soypat/proy-final/README.md

# Capstone Project (Tesis de grado): Diseño, ensamblaje, integración y testeo de un vehículo VTVL eléctrico
## Autores: Patricio Whittingslow & Luis Cretton

Link to public domain site(ITBA) [spanish]:
https://ri.itba.edu.ar/handle/123456789/4253
