soypat/proy-final/chapter/designcad.tex

\section{Planos de diseño y planos de piezas}
En esta sección se detallan vistas explotadas de versiones anteriores 
y luego planos constructivos de las piezas que componen al prototipo.

% VIEJAS
\includepdf[angle=90]{pdf/cad/Vista explotada}
\includepdf[angle=90]{pdf/cad/Vista explotada 1.0}
\includepdf[angle=90]{pdf/cad/Vista explotada 5}

% VERSION FINAL
\includepdf[angle=90]{pdf/cad/ALUM-06-02}
\includepdf[angle=90]{pdf/cad/ALUM-06-03}
\includepdf[angle=0]{pdf/cad/ALUM-06-04}
\includepdf[angle=0]{pdf/cad/ALUM-06-05}
\includepdf[angle=0]{pdf/cad/ALUM-06-06}
\includepdf[angle=0]{pdf/cad/ALUM-06-07}
\includepdf[angle=0]{pdf/cad/ALUM-06-08}
\includepdf[angle=0]{pdf/cad/ALUM-06-09}
\includepdf[angle=0]{pdf/cad/ALUM-06-10}
\includepdf[angle=0]{pdf/cad/ALUM-06-11}
\includepdf[angle=0]{pdf/cad/ALUM-06-12}
\includepdf[angle=0]{pdf/cad/ALUM-06-13}
\includepdf[angle=0]{pdf/cad/ALUM-06-14}
\includepdf[angle=0]{pdf/cad/ALUM-06-15}
\includepdf[angle=0]{pdf/cad/ALUM-06-16}

% \section{Dibujos de }

% \includepdf[angle=90]{pdf/cad/Vista explotada 1.0}
