soypat/proy-final/pf-cretton-whitti.tex

% !TeX spellcheck = es
\documentclass[11pt, titlepage]{article}
\input{tex/preamble.tex}
\input{tex/macros.tex}
\input{tex/code.tex}
% \input{tex/footmult.tex}
\input{tex/glossary.tex}
\lhead{ LIA Aerospace -- ITBA}
\newcommand{\mldivide}{\,{\boldsymbol{\backslash}}\,}
\usepackage{pdfpages}
\author{Patricio Whittingslow \and Luis Cretton}
\begin{document}
\begin{titlepage}
	
	\centering
	\vspace{-1cm}
	\begin{figure}[htb]
		\centering
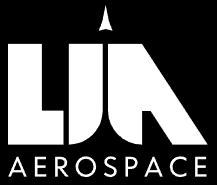
[picture p1: fig/lia-aerospace-logo.png]
		
	\end{figure}
	\begin{figure}[htb]
		\centering
		
	\end{figure}
	
	\vspace{1cm}
	{\Huge Diseño, ensamblaje, integración y testeo de un vehículo VTVL eléctrico \par}
	% {\Huge Gimballed EDF propelled VTVL vehicle design, assembly, integration and testing \par}
	\vspace{2cm}
	{ \large {
			Patricio Whittingslow \\ Luis Cretton 
		\par}}
	\vspace{.5cm}
	{ \large {
			Tutores:\\ Dan Etenberg \\ Alejandro Ghersin
		\par}}
	\vspace{1cm}
	\today
	\vspace{1cm}
	\begin{figure}[htb]
		\centering
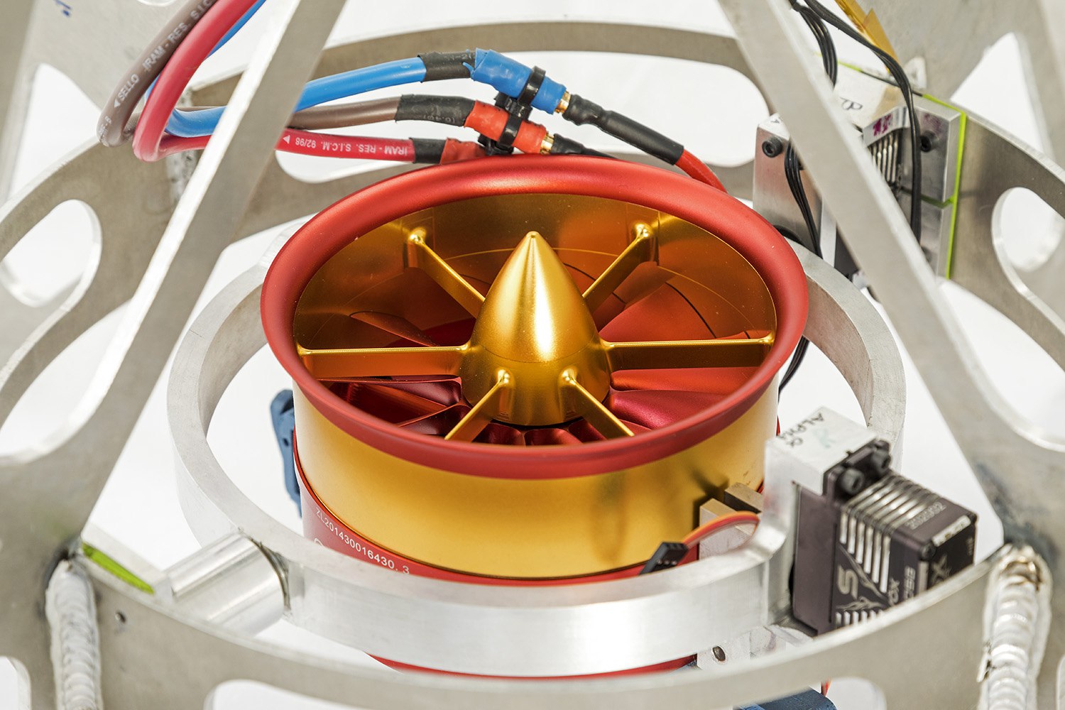
[picture p2: fig/hq/gimbal_close.jpg]
		
	\end{figure}
\end{titlepage}

\begin{abstract}
	
\indent En este documento se encuentran descriptas las secuencias del diseño, simulación, construcción, pruebas, y puesta en marcha de un UAV VTVL. Se evaluaron métodos de propulsión, diseño de fuselaje, software de vuelo, implementación de sistema de control para luego efectuar ensamblaje, y la integración final con testeo en campo. Se logro ensayar el sistema de control a baja escala con el propósito de incorporarlo a un sistema de mayor escala en desarollo paralelo de uso sub-orbital o incluso orbital. 

Se documentan todos los pasos seguidos para llegar al resultado final y se adjuntan los documentos relevantes del desarrollo para su posible replicación incluyendo los planos de cada parte del vehículo, fotos del ensamble, extractos de código, desarrollo de ecuaciones de dinámica de cuerpo rígido y modelos para el control del vehículo utilizando teoría de control óptimo lineal.

% - Proyecto es punta pie para otros desarrollos mas grandes, i.e: ESA FROG.
% - se propuso un projecto, y se logro
% 	- Como se logro?
% 	- Que nos propusimos?
% 	- No seguimos con las pruebas por el incidente. Nos detuvimos. Llevo a mas mejoras
% 	- Se reescribio todo el codigo, mejora de raiz. Se cambiaron componentes.
% 	- mas protecciones electricas
% 	- El fallo nos mostro el valor del proyecto. Si fuera un VTVL a combustible podria haber sido catastrofico
% 	- problema perdida de control podria generar perdidas en proyectos analogos(seguridad/desarrollos) de la empresa donde se usaba este tipo de tecnologia.
% 	- pruebas de campo

% - Flaps: Se diseño en 3D el soporte de sin tener el EDF en la mano. Cuando llego el EDF nos dimos cuenta que el soporte iba arriba de la parte giratoria.
% 	- Se tuvo que pausar y pensar en un diseño para el soporte que consolide el resto del diseño entero.

% - Queda mucho más para investigar y desarrollar.
% 	- En una proxima iteración podria extenderse el alcance de este desarollo.

\end{abstract}

\newpage
\tableofcontents
\newpage
\printunsrtglossaries
\vfill
\hrule
% \vspace{-1cm}
% \subsection*{Nota del autor}
% Si el documento es abierto desde un lector PDF moderno (Chrome, Adobe Acrobat Reader, entre otros), se podrá navegar el mismo mediante las referencias (haciendo click derecho).

\newpage

\input{chapter/intro.tex}

\null\newpage
\clearpage

\input{chapter/design.tex}

\null\newpage
\clearpage

\input{chapter/fea.tex}

\null\newpage
\clearpage

\input{chapter/designfig.tex}

\null\newpage
\clearpage

\input{chapter/model2d_es.tex}
\input{chapter/threeDdemo.tex}

\null\newpage
\clearpage

\input{chapter/simulation.tex}

\null\newpage
\clearpage

\input{chapter/software.tex}

\null\newpage
\clearpage

\input{chapter/tests.tex}

\null\newpage
\clearpage

\input{chapter/challenges-solutions.tex}

\null\newpage
\clearpage

\input{chapter/conclusion.tex}

% \null\newpage
% \clearpage

\subsection*{Agradecimientos}
Dan Etenberg por habernos ayudado en condiciones dificiles dado el contexto de pandemia y por proveer instalaciones, compra de materiales e insumos. 

\medskip

Stéphane Querry por haber intercambiado información acerca de parámetros de diseño del proyecto FROG de la ESA relevantes a la programación del sistema de control.

\medskip

Pablo Cossutta por compartir su experiencia trabajando con sistemas de potencia electrónicos. 

\input{chapter/annex.tex}

\bibliography{tex/biblio} % Indica archivo
\bibliographystyle{plainnat} %estilo de bibliografía
% \bibliographystyle{unsrtnat}
%\includepdf[fitpaper=false,landscape]{pdf/Vistaexplotada5.pdf}

\null\newpage
\clearpage

\input{chapter/designcad.tex}

\end{document}
