soypat/proy-final/tex/preamble.tex

\usepackage[spanish,mexico]{babel}
\usepackage{xcolor}
\definecolor{darkblue}{rgb}{0.1 , 0.1, 0.7}
% referencias antes de geometría!
\usepackage[
hyperfootnotes=true,
urlcolor=blue,
colorlinks=true,
linkcolor=darkblue,
citecolor=darkblue]{hyperref}

% Texto matemático
%\usepackage[utf8]{inputenc}
\usepackage[a4paper,top=2cm,bottom=2cm,left=3cm,right=3cm,marginparwidth=1.75cm,headheight=28pt]{geometry}
%\usepackage[spanish, mexico]{babel}
\usepackage{graphicx}

%\usepackage[utopia]{mathdesign}
\usepackage[T1]{fontenc}					
\usepackage[utf8]{inputenc}		
%\renewcommand*\familydefault{\sfdefault} 

\usepackage{amsmath,array,IEEEtrantools,bm}
\usepackage{pdfpages}
% ENCABEZADO
\usepackage{fancyhdr,framed}
\setlength{\headheight}{44pt}
\pagestyle{fancy}
% TODO
\usepackage[
textwidth=2.6cm,
textsize=footnotesize,
]{todonotes}

\usepackage{natbib}
\usepackage{afterpage}
