soypat/proy-final/presentation.pdf

## Gimballed EDF propelled VTVL vehicle design and control

### Defensa de proyecto final

Patricio Whittingslow
Luís Cretton

11 de febrero de 2023

### Objetivo

- Tecnología central para el desarrollo aeroespacial futuro
- Desarrollo de vehículo plataforma para ensayos a pequeña escala


Figura 1: Starship: referente en tecnología de vehículos orbitales reutilizables.

### Estado del arte

- Tecnología monorrotor fijo tiene uso amplio


Figura 2: Dos vehículos VTVL eléctricos modernos. “VBat” (Izq.) y “Ikarus”. (https://hackaday.com/2018/08/31/single-rotor-drone-a-thrust-vectoring-monocopter/)

### Estado del arte

- Tecnología monorrotor para empuje vectorial siendo usado por la ESA para ensayar algoritmos de control.


Figura 3: FROG de la ESA. Plataforma de ensayo de sistemas.

## Diseño

### Diseño – Propulsión másica

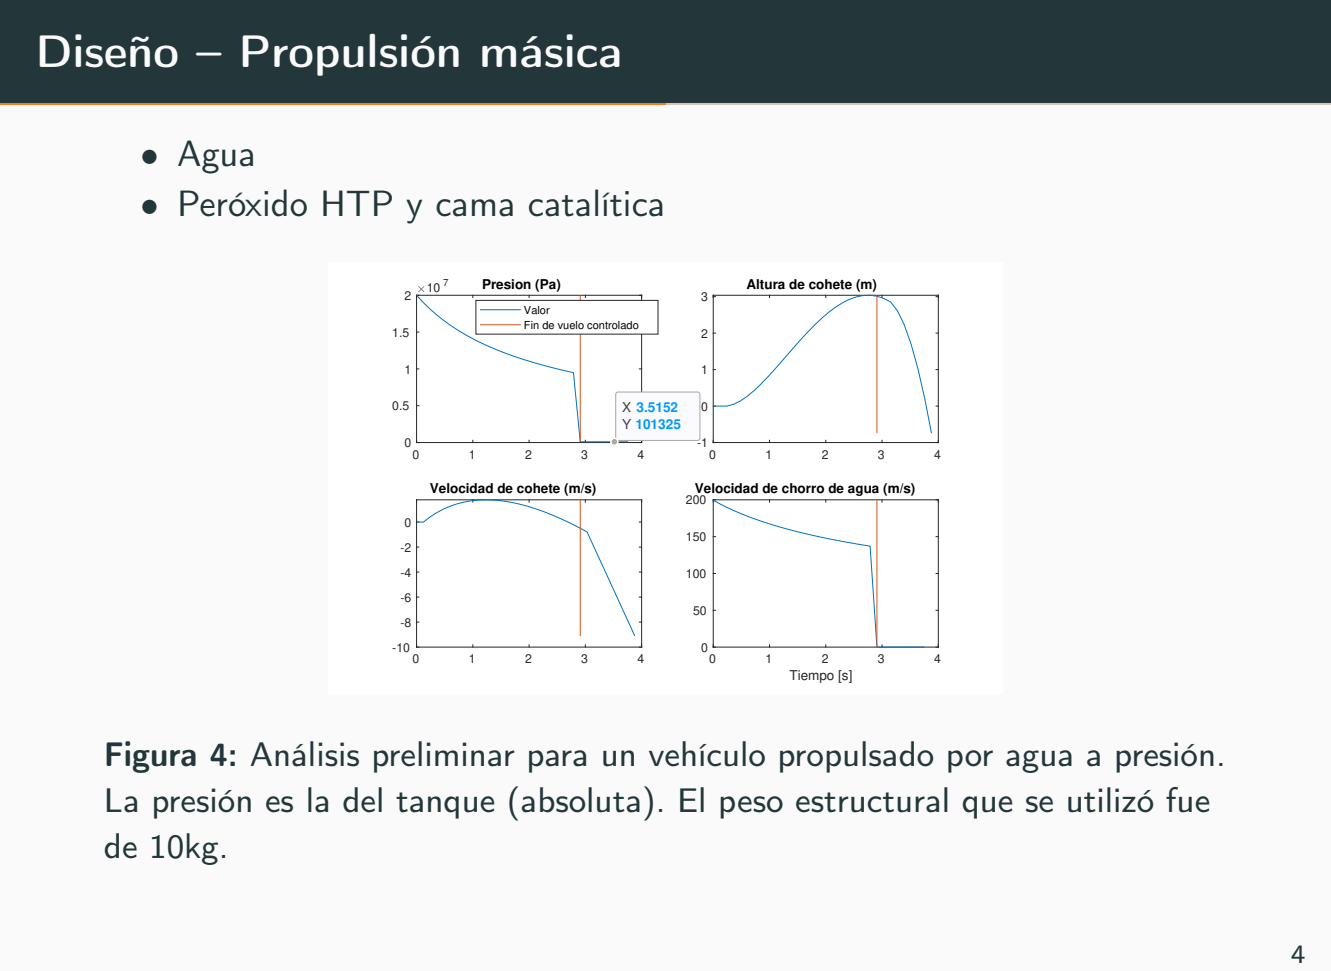
[picture p6: page 6]
Presion (Pa); Tiempo [s]

• Agua
• Peróxido HTP y cama catalítica

Valor
Fin de vuelo controlado

Altura de cohete (m)

Velocidad de cohete (m/s)

200Velocidad de chorro de agua (m/s)

Figura 4: Análisis preliminar para un vehículo propulsado por agua a presión.
La presión es la del tanque (absoluta). El peso estructural que se utilizó fue

### Diseño – Elección de propulsor

Diámetro de EDF | 70mm | 90mm | 120mm
Masa estructural [kg] | 0,4 | 1 | 2
Masa batería [kg] | 0,9 | 1,9 | 2
Mas electrónica [kg] | 0,5 | 1 | 1
Empuje restante [kgf] | 0,01 | 0,478 | 3,116
Tiempo vuelo [s] | 253 | 184 | 132
Precio baterías-propulsor [usd] | 165 | 365 | 693
Costo total [ars] | 23968 | 53017 | 101313

Tabla 1: Estudio de diferentes EDF’s disponibles en el mercado. El requerimiento excluyente para la selección de batería fue que permita vuelo sostenido por 2 minutos.

## Simulación

### Simulación – Modelo matemático

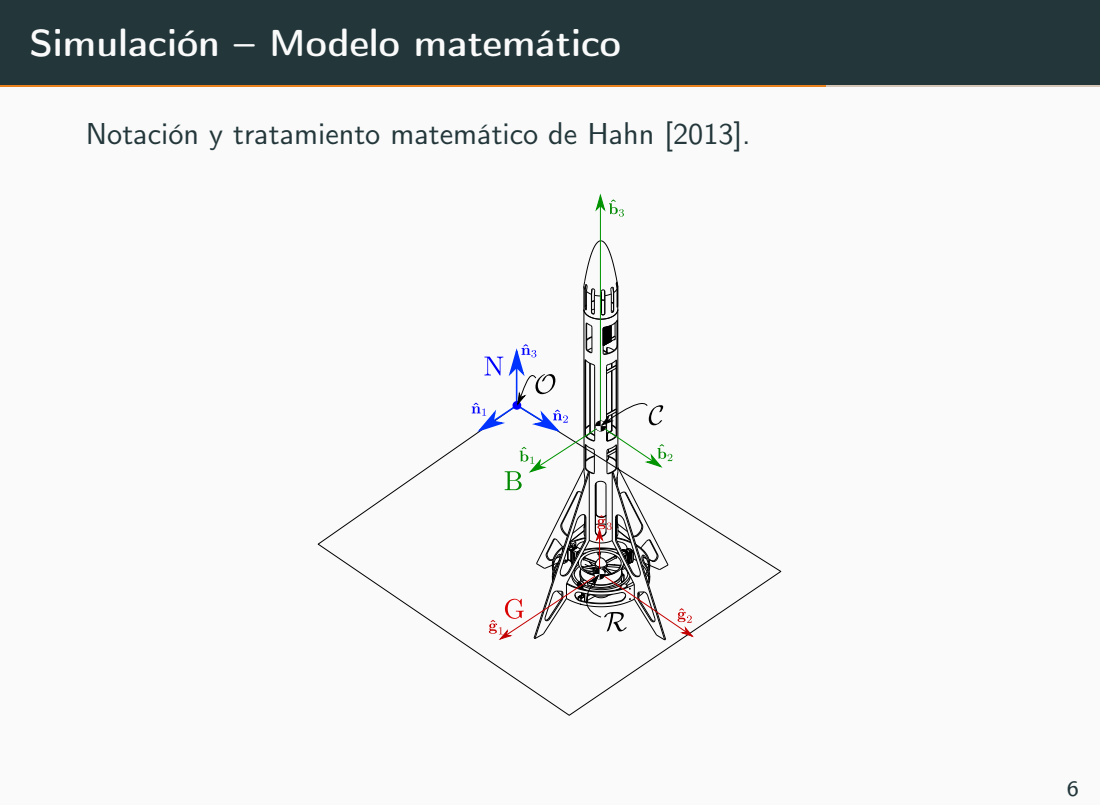
[picture p7: page 9]

Notación y tratamiento matemático de Hahn [2013].

### Simulación – Modelo matemático

Aceleración angular del vehículo tomando en cuenta efecto giroscopo y fuerzas externas debido a vorticidad.

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
BN ·J

B
C
- ω

B
BN − A

BG
- ω˜

G
GB ·J

G
rR
- ω

G
r −

ω˜

B
BN ·J

G
rR
- ω

G
r − A

BG
·J

G
rC

·

Nω˙

G

r +MB
C

### Simulación – Control

- Representación espacio de estados.
- Controlador LQR.
- Estimador de actitud Madgewick.
x˙ = Ax + Bu | (1)

u = KLQR (x − x0

) | (2)

## Referencias

Hubert Hahn. Rigid Body Dynamics of Mechanisms: 1 Theoretical Basis. Springer Science & Business Media, 2013.
