soypat/proy-final/pf-cretton-whitti.pdf

LIA Aerospace

# Gimballed EDF propelled VTVL vehicle design and control

Patricio Whittingslow
Luis Cretton

8 de abril de 2021

Resumen

En este documento se encuentran descriptas las secuencias del diseño, simulación, pruebas, y puesta en marcha de un vehículo autónomo VTVL (Vertical Take-off Vertical Landing). Se desarrolla la elección de un método de propulsión que lograra ensayar el sistema de control a baja escala para luego ser puesto en marcha en un sistema de mayor escala de uso sub-orbital o incluso orbital.

LIA | ÍNDICE

## Índice

Glosario | 2
Siglas | 2
1. Introducción | 3
2. Estudios | 3
3. Diseño | 6
4. Modelo 2D simplificado | 10
5. Ecuaciones de movimiento de cuerpo rígido | 12
6. Simulación | 19
7. Desarrollo de software | 22

LIA | Siglas

## Glosario

Corrutina Una unidad de procesamiento que puede ejecutarse en simultaneo con otras corrutinas.

Electronic Speed Control Controlador de velocidad para motores brushless. Suelen tener DC a la entrada y trifásica a la salida.

Electronic ducted fan Turbina impulsada por un motor eléctrico brushless. Es eficiente a altas velocidades.

Linear Quadratic Regulator Regulador basado en control óptimo que busca reducir error cuadratico de una función costo.

System on a chip Integración de modulos conectados a un controlador en un único circuito impreso.

LIA Laboratorio de Investigaciónes Aeroespaciales. Empresa para la cual se efectuó el desarrollo del vehículo.

## Siglas

I

2C Protocolo de comunicación de dos hilos que permite comunicar varios circuitos integrados en un bus.

GPIO Salida digital de uso genérico. Pueden estar en high (tensión de fuente) o low (puesto a tierra).

SPI Serial peripheral interface. Un protocolo de comunicación full-duplex de Motorola.

UART Protocolo de comunicación universal asincrono.

Nota del autor

Si el documento es abierto desde un lector PDF moderno (Chrome, Adobe Acrobat Reader, entre otros), se podrá navegar el mismo mediante las referencias (haciendo click derecho).

LIA | 2 ESTUDIOS

## 1. Introducción

El diseño, desarrollo, fabricación, armado, simulación y lanzamiento de cohetes, no es una tarea sencilla ni repetida en intervalos de cortos de tiempo, al contrario, suelen llevar décadas y una fuerte inversión para que sean posibles estos logros. El diseño y auge de vehículos VTVL viene a subsanar estos factores ya que una vez terminada la misión el vehículo se puede reutilizar, con mínimas intervenciones, y estaría listo para una nueva misión, atacando estos dos puntos principales anteriormente mencionados, el tiempo y el costo. Esto es a diferencia del método convencional donde el vehículo, luego de completar la misión, pasa a formar parte de basura espacial o, en el mejor de los casos, es recuperado del mar como el caso del Space Shuttle.

Un vehículo VTVL es aquel que despega verticalmente (como la mayoría de los cohetes convencionales) y aterriza verticalmente, por sí solo, sin necesidad de ser tripulado, y con el objeto de completar una misión, esto supone una gran variante de ventajas, como ser una de las más destacadas el reutilizamiento del vehículo, con todo lo que ello implica, logrando una optimización de los costos, disminución de huella ecológica, y tiempo de desarrollo para las empresas interesadas.

Los vehículos VTVL son tan viejos como el primer alunizaje. Traen en si varias ventajas frente a otros vehículos voladores como la gran reducción de espacio necesario para despegar y aterrizar. Esto no es un detalle menor dado que la mayor parte de la superficie terrestre de la tierra no son pistas de aterrizaje si no más bien terreno formado naturalmente.

Este documento propone el diseño, simulación, control y fabricación de un vehículo con capacidades VTVL siendo un prototipo de baja escala. Este prototipo serviría como punta pie inicial para vehículos de escala mayor que puedan completar misiones espaciales. Existen varias ventajas de implementar este tipo de tecnología.

A baja escala, un vehículo que despega y aterriza por su cuenta, teniendo la capacidad de superar obstáculos que se presenten, puede ser de gran utilidad en ambientes hostiles para el ser humano, que esto se logre de manera rápida y efectiva podría ser la diferencia entre el éxito o no de la misión. Como ser el transporte de insumos médicos en tiempo real desde que un paciente lo requiere, en zonas de acceso limitado.

Últimamente hay un interés nuevo en imágenes espaciales. El vehículo podría ser utilizado para fines de sistemas de monitoreo y análisis geoespacial mediante el uso de estas imágenes, como hacen las empresas Ceres Imaging y Satellogic.

El vehículo una vez desarrollado y funcionando, puede servir de plataforma para diversos estudios de fenómenos de dinámica de fluidos, como ser, mediciones aerodinámicas, investigación del fuel sloshing en vehículos con tanques esbeltos.

Los sistemas de vehículos orbitales tienen sistemas complejos que deben ser testeados en una primera etapa mediante algún ensayo controlado. El vehículo que se desarrolla en el presente documento podría ser usado para tales fines como una plataforma para pruebas como ser el despliegue de una nariz o etapa, comprobación de sensores y actuadores a gran velocidad y con empuje variable.

## 2. Estudios

En lo que se refiere a la construcción del vehículo, el diseño propuesto paso por varias etapas y decisiones de ingeniería hasta su forma final. Desde su diseño en lápiz y papel hasta la simulación del CAD con el detalle del ultimo bulón del ensamble para poder recoger datos de momentos de inercia, centros de masa y la dinámica del vehículo.

LIA | 2 ESTUDIOS

### 2.1. Agua como propelente

El primer prototipo muy distante del diseño final perteneciente a este trabajo, consistía en un recipiente a presión con agua, abulonado a un chasis, con un gimbal y actuadores para poder redirigir el empuje.

La figura 1 muestra los resultados de una simulación de un vehículo pequeño de aluminio con un recipiente a presión lleno en parte de agua y aire a 200 bar. La simulación considera masa variable y una transición isoentrópica del gas en el recipiente. En el mejor de los casos se llegaba a un tiempo de vuelo cercano a los 4 segundos que no es suficiente para comprobar un sistema de control.
Para optimizar este problema se modificaba

Diámetro de la tobera – más empuje vs. menos tiempo de vuelo controlado

Volumen de agua – más tiempo de vuelo vs. mayor peso de vehículo

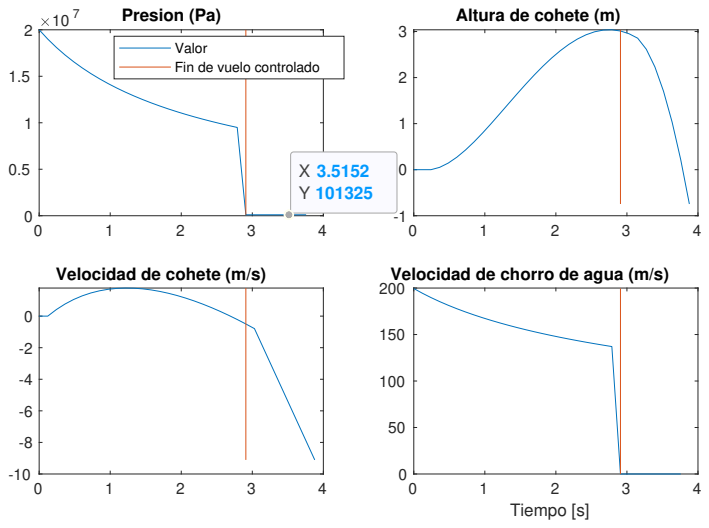
[picture p8: figure]
Presion (Pa); Altura de cohete (m); Velocidad de cohete (m/s); Tiempo [s]; Velocidad de chorro de agua (m/s); Valor Fin de vuelo controlado

Figura 1: Análisis preliminar para un vehículo propulsado por agua a presión. La presión es la del tanque (absoluta). El peso estructural que se utilizó fue de 10kg.

### 2.2. Turbina a reacción

Se propuso la construcción de una turbina de combustible líquido, como método de propulsión del vehículo favorable debido al excelente cociente de peso-empuje.
Esta idea se vio descartada por la pandemia que estamos atravesando (COVID19) debido a que no teníamos acceso al taller de la institución para poder realizar en tiempo y forma el dispositivo mecánico, que era la primer tarea inmediata a tener en banco de pruebas asegurando su funcionamiento en optimas condiciones, para luego proseguir con el desarrollo del vehículo y el sistema de control.

### 2.3. Propulsión eléctrica

Luego de descartar las ideas vistas en 2.1 y 2.2 se pasó al análisis de la incorporación de una turbina eléctrica que es un dispositivo ya existente en el mercado, no en nuestro país, pero que podría llegar a importarse mediante una inversión privada.¹ Dado el alcance de un

1Agradecemos a LIA Aerospace por hacerse cargo de la compra de todos los elementos necesarios para la fabricación del cohete.

LIA | 2 ESTUDIOS


Figura 2: Dos vehículos VTVL eléctricos modernos. “VBat” (Izq.) y “Ikarus” (https://hackaday.com/2018/08/31/single-rotor-drone-a-thrust-vectoring-monocopter/) (Der.).

proyecto de universidad se decidió por un diseño compuesto por elementos comercialmente disponibles.²

Para lograr estas tareas generalmente los vehículos VTVL de baja escala generalmente son propulsados por motores eléctricos.

Los vehículos VTVL eléctricos son propulsados por hélices en su mayoría y constan casi siempre de 3 o más propulsores en un arreglo simétrico y plano. Recientemente hay un interés por la construcción de vehículos de una sola hélice por la buena relación empuje– peso que tienen. Sin embargo, estos vehículos no vienen sin sus complicaciones:

La rotación dada al aire por la hélice causa un momento en el eje de propulsión que es contrarrestado en vehículos multirrotores.

Inclinar al rotor durante su funcionamiento causa una fuerza perpendicular a la dirección de inclinación conocido como el efecto giroscópico.

El primer punto es mitigado fácilmente agregando álabes a la salida del chorro para enderezar el flujo y contrarrestar la rotación. El segundo punto solo se resuelve conociendo las ecuaciones de momento angular y controlando actuadores con un sistema de control a lazo cerrado. Los sistemas vistos en la figura 2 tienen la particularidad de poder ser representados con relativa facilidad usando un solo marco de referencia inercial para el cálculo de las ecuaciones de momento angular.

Existen placas pre-programadas para vehículos multirrotores, pero en el caso de vehículos monorrotores de hélice fija se precisa re-programar la placa para compensar por el efecto giroscópico y agregar dinámica de álabes ya que no existe software disponible aún para esta configuración. En el caso de tener una hélice móvil se suma un nivel de complejidad agregada debido al despeje de las ecuaciones de momento angular (ver sección 5). Al momento de escribir este documento aún no hay desarrollo disponible de carácter público para esta configuración.

2Commercial off the shelf (COTS)

LIA | 3 DISEÑO

## 3. Diseño

En el marco de este proyecto, es de interés el diseño mecánico del mecanismo de control semejante un vehículo propulsado por combustión externa. Estos últimos suelen ser dirigidos por toberas montadas sobre un cardán. En el caso de un vehículo eléctrico de una hélice se tendría que montar el sistema de propulsión centrado en un gimbal para no obstruir el flujo.

### 3.1. Selección de propulsor

Los requerimientos para el propulsor son los siguientes

Empuje que mantenga altura del vehículo para la máxima actuación del gimbal

Disponible comercialmente

Precio de propulsor y accesorios relevantes dentro de presupuesto

Durabilidad ante pruebas físicas en cuanto a la duración del proyecto

Estos requerimientos fueron los primeros especificados para el diseño del vehículo. El diseño estructural y la selección de componentes electrónicos parten del propulsor seleccionado ya que este es la pieza central para lograr los objetivos propuestos y la que más puede variar en especificaciones técnicas.

Existen diversas maneras de impulsar un vehículo de forma eléctrica. Luego de un cuidadoso estudio y discusión de ingeniería se decidió optar por un EDF, quien juega un rol central en el diseño pues es lo que se intenta controlar para llevar a cabo la navegación y guiado.

Se generó una lista de EDF’s de diferentes diámetros disponibles comercialmente.

| 70mm | 90mm | 120mm
Masa estructural [kg] | 0,4 | 1 | 2
Masa batería [kg] | 0,9 | 1,9 | 2
Mas electrónica [kg] | 0,5 | 1 | 1
Empuje restante [kgf] | 0,01 | 0,478 | 3,116
Tiempo vuelo [s] | 252,972973 | 183,5294118 | 131,8309859
Precio baterías-propulsor [usd] | 165,075 | 365,15 | 693,005
Costo total [ars] | 23968,06463 | 53017,95425 | 101313,866

Tabla 1: Estudio de diferentes EDF’s disponibles en el mercado. El requerimiento excluyente para la selección de batería fue que permita vuelo sostenido por 2 minutos.

El empuje restante de la tabla 1 es el empuje que sobra luego de restar el peso del vehículo al empuje nominal del EDF. Este empuje dará margen para maniobrar y recuperar la orientación luego de una perturbación externa.

Los EDF de aluminio solo se consiguen en el exterior y su precio es en dolares³
| | | . Esto trae
varios inconvenientes en lo referente al presupuesto acotado, logística, compra y obtención.
Los EDF disponibles de plástico tienen una relación de empuje-diámetro mucho menor con
respecto a los de aluminio. Cabe destacar que el costo de un EDF de plástico y un EDF
de aluminio son cercanos para diámetros similares. | juntar estos dos
parrafos (arriba
Los EDF que fueron analizados son los más baratos que se encontraron en eBay y son y abajo) en uno provenientes de Hong Kong. Como condición de selección excluyente para cumplir con el
requerimiento de durabilidad el hecho de que sean de aluminio ya que deberán resistir

LIA | 3 DISEÑO

test y pruebas físicas (durabilidad) además de la fabricación y vinculación mecánica de
actuadores de aluminio (tensiones). Son todos de aluminio y se espera . | corregir esto

Se decidió por el EDF de 120mm, motor brushless alimentado por una batería Li-Po
12s (48V) 5000mAh 50c/100c para la construcción del prototipo. Este EDF mantiene un
empuje resultante positivo para un ángulo de actuación de aproximadamente 45◦
, el cual
supera el ángulo actuado máximo de las simulaciones.

### 3.2. Diseño de la mecánica

Para el diseño del gimbal se propuso una distribución de los mecanismos de actuación con servos concéntricos a los ejes de rotación. Para evitar de esta manera complejidad de mecanismos, cantidad de piezas de conexión entre servo y ejes, manufactura de mecanismos, uniones rotoides, y obtener así un mapeo lineal del ángulo de actuación. El único intermediario es el rodamiento que como se dispuso en la configuración ocupa el mínimo lugar posible justo por encima de la estría del servo y se lleva las cargas. Este mecanismo viene con la desventaja de una reducción de la resolución del ángulo de actuación comparado a un sistema actuado por un mecanismo biela-manivela.

El material seleccionado para la fabricación del gimbal fue aluminio serie siete mil calidad aeroespacial. Esta construido de una sola pieza, siendo el elemento que se lleva las tensiones en todo momento en variabilidad de ángulos hacia el fuselaje, por ello la decisión de ser de la serie de mayor resistencia mecánica de los aluminios comerciales.

Los rodamientos seleccionados son de dimensiones 18mm exterior, 10mm interior y 7mm de espesor, elegidos de esta manera por una cuestión de espacio para poder pasar la estría de los servomotores por dentro, dejando un espesor de la pared del estriado de 2.5mm, para evitar fisuras y hacer posible la manufactura de la pieza. La forma de generar el estriado interno, es la de indentar con un patrón sobre un agujero previo de diámetro medio a los valores máximos y mínimos de las crestas y valles de la estría. Esta operación debe hacerse con el material en bruto para no arruinar las tolerancias que necesitan los rodamientos. Los rodamientos se montarían clavados, minimizando el peso al no agregar anillos seguers ni tapas con bulones.

Los ejes del gimbal estarían en disposición simplemente apoyada y de forma axisimétrica para prevenir perturbaciones dinámicas por desbalanceo.

Con respecto al fuselaje, al inicio se pensó una envolvente cilíndrica para el anillo externo del gimbal. Luego se diseñó un desarrollo reticulado optimizado, se pasó por diferentes modelos e ideas, hasta que se combinaron varios puntos fuertes de cada idea. La envolvente del gimbal se fabrica de forma rolada y optimizada en peso a raíz de una planchuela de aluminio vaciada y luego generando su forma cilíndrica.⁴ Esto distribuye las masas de manera más favorable con menos espacio ocupado (dinámica-peso). Aguas arriba del gimbal se opto por un chasis tubular, con diversos vaciados, que mediante flejes puede soportar cada elemento que se acopla al cohete por medio de uniones abulonadas. Permitiendo mediante sus aberturas el acceso a cada componente del vehículo, proporcionando, además, una renovación del aire para una evacuación del calor generado, y un flujo abundante hacia la admisión del EDF.

De la manera que se construye el gimbal puede entregar una rotación entera sin hacer contacto con la estructura. Se elige esta configuración por posibles desviaciones del proyecto en el futuro, calculamos que utilizaremos menos de 20◦ de rotación de cada eje de gimbal (±10◦
).

3El cambio de divisas es desfavorable para el lugar donde se desarrolla este proyecto.
4Contiene al anillo del gimbal.

LIA | 3 DISEÑO

### 3.3. Posición de baterías

La la decisión de donde posicionar las baterías surgía de querer simular un vehículo semejante a los VTVL con motores a reacción y también la posibilidad de tener una inercia favorable para los margenes de estabilidad. Estos dos últimos puntos sugieren que la posición ideal para las baterías es arriba de todo. Esto haría que el punto alrededor del cual se linealizó las ecuaciones de movimiento sea más estable. Luego de una conversación con Pablo Cossutta, un ingeniero electrónico especialista en sistemas de potencia, se optó por la configuración encontrada en el documento. Las baterías se encuentran cerca del EDF para alejar las líneas de potencia trifásica correspondientes al motor brushlesss de lo que es la electrónica digital. Al inestabilizar el punto de operación se obtiene una mejora en la respuesta ante actuaciones permitiendo una corrección de trayectoria más rápida.⁵

### 3.4. Selección de servos

Para obtener una buena respuesta del vehículo ante actuaciones se debe acotar la resolución necesaria. Según Castillo-Martínez et al. [2018], la resolución angular de un servo analógico está dada por

Rp =

θ · TD
PW
donde θ es el angulo de barrido del servo (especificado por el fabricante), TD es el tiempo muerto y PW es el ancho de pulso operativo.
El servo seleccionado es el SC1258TG. Tiene las siguientes especificaciones

Tiempo muerto (deadband) 3µs

Rango de ancho de pulso mínimo y máximo 800-2100µs

Posición neutra 1500µs

Ángulo de barrido operativo 100◦
(para 1000-2000µs)

Velocidad 1,05 rad/s

Controlador digital

Se tiene entonces una resolución mínima de 0,3◦
con un ancho de pulso de 2000µs. Esta cuenta cede la resolución para un servo analógico, en el caso de tener un servo digital se toma el límite superior entre este valor y la resolución del controlador digital. Como el fabricante no especifica el controlador utilizado, se supone el peor de los casos: un controlador de 8 bits. Este caso tiene una resolución de 0,4◦
Esta resolución es alimentada como parámetro de actuación en las simulaciones.

### 3.5. Tren de aterrizaje

Se definen algunos requerimientos para el tren de aterrizaje

Cada pata será dimensionada para soportar 20 veces el peso del vehículo. Este factor
de seguridad toma en cuenta la posibilidad de aterrizaje desparejo y el factor dinámico
de un impacto | 20 veces? Cuan- tas veces?

Facilidad de fabricación y armado

5Este resultado es deseado cuando se desea tener mejor rendimiento por ángulo de actuación, como sucede con los aviones caza que utilizan este fenómeno a conveniencia.

LIA | 3 DISEÑO

El primer diseño consistía en una estructura reticulada, la cual se decidió abandonar por la dificultad del armado y sucesivas soldaduras, consecuentes alineaciones por las dilataciones térmicas.

El diseño seleccionado consiste en unas patas compuestas de una placa de aluminio vaciada y soldada a la estructura principal del fuselaje. Otorga rigidez a expensas de bajo peso y facilidad de construcción.

### 3.6. Selección de controlador y sensores

Se pasó por dos etapas hasta llegar a la decisión final del controlador. Se empezó planteando la utilización de una Raspberry Pi 4B+ para controlar los actuadores con PWM. Esta configuración requeriría el diseño de una placa ad-hoc para desacoplar galvánicamente la Raspberry del controlador de velocidad del EDF (ESC). Se descartó esta idea a favor de usar una combinación de Raspberry Pi y una placa propia de LIA Aerospace.

El controlador a usar es el ARM Cortex-A72 que sería comprado en el paquete comercial (SoC) conocido como Raspberry Pi 4B+. El producto provee salidas para los siguientes usos

UART

SPI

I

2C

GPIO

El controlador ira montado sobre una placa cuyo desarrollo pertenece a LIA Aerospace denominada LIA-Board. Esta placa hace interfaz con el controlador mediante el GPIO header del SoC. Esto le permite al controlador acceder a los periféricos y salidas disponibles del LIA-Board que controlaran los actuadores y leerán los sensores.

### 3.7. Contexto de pandemia

Las medidas tomadas durante la pandemia por el gobierno fueron muy estrictas e influenció a todo tipo de acción que se quiso tomar. Durante el primer año de pandemia no nos pudimos reunir físicamente para discutir ideas de diseño, lo cual dificultó el avance físico del proyecto como así también la toma de decisiones y la comunicación entre partes, crucial en el inicio de todos proyectos de ingeniería.

Una de las mayores complicaciones que se tuvo fue la compra de componentes, además de la fabricación, que se vio afectada, por las políticas cambiantes de nuestro país con respecto a la compra y la entrada de productos importados a suelo argentino. Incluso la compra y llegada de los productos fue un motivo de festejo luego de un tortuoso trayecto.

LIA | 4 MODELO 2D SIMPLIFICADO

## 4. Modelo 2D simplificado

Esta siguiente sección detallará el tratamiento matemático efectuado para controlar un vehículo con propulsión vectorizada en el plano. El propósito es ilustrar a un nivel simple las herramientas que serán aplicadas para controlar el vehículo diseñado.

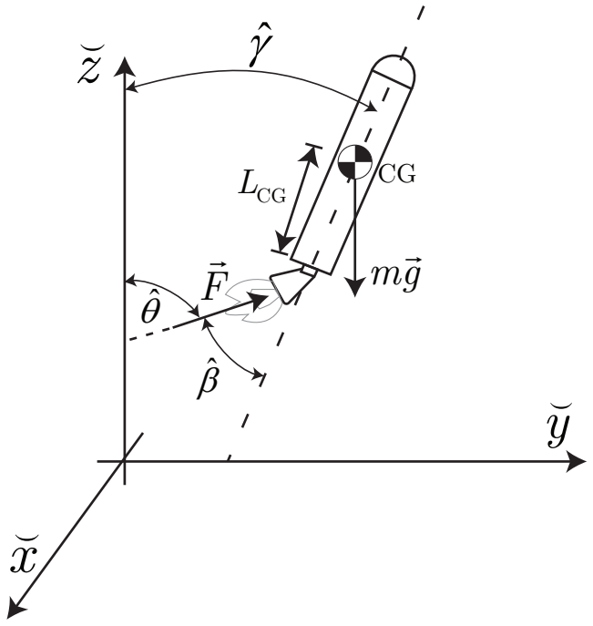
[picture p9: figure]
LCG

Figura 3: Diagrama de cuerpo libre de un vehículo con propulsión vectorizada 2D.

### 4.1. Modelado matemático

Comenzamos con las ecuaciones dinámicas de un vehículo en el plano con control de propulsión vectorizada (por ángulo)

y¨ =

F
m

sin(γ + β)
z¨ =

F
m

cos(γ + β) − g
γ¨ =

LCG·F
Ixx

sin β

donde LCG y F están en función del tiempo, m = m0 −

R
m˙ y θ = γ + β.
Vale la pena aclarar que no se tomarán en cuenta los siguientes efectos:

Coeficiente de arrastre

Viento

Fuel sloshing

Efectos relativistas

### 4.2. Armado de sistema lineal

Se propone un punto de operación alrededor del cual se efectúa la linealización las ecuaciones. El estado del vehículo es vertical y quieto en el espacio.

6

6La linealización es valida solo para un vehículo vertical. Se deberá modificar el método para modelar un vehículo orbital.

LIA | 4 MODELO 2D SIMPLIFICADO

γ

∗ = 0

β

∗ = 0

F

∗ = mg

en este caso F es la desviación del punto de operación. Desde ahora en adelante ∆F = F − mg.

### 4.3. Representación en espacio de estados

El número de variables de estado será igual a número de almacenadores de energía independientes. Estos son

z Energía potencial por la gravedad

y,˙ z˙ Energía cinética del vehículo

γ˙ Momento angular del vehículo

entonces, las variables de estado son las siguientes

x1 = y
x2 = ˙y
x3 = z
x4 = ˙z
x5 = γ
x6 = ˙γ

donde x˙1 = x2, x˙3 = x4 y x˙5 = x6
Se aprovecha la expansión de Taylor para la linealización de expresiones trigonométricas:

sin(x + y)|x=x0+∆x,y=y0+∆y ≈ sin(x0 + y0) + cos(x0 + y0)(x − x0) + cos(x0 + y0)(y − y0)

Las ecuaciones dinámicas de los estados 2,3, y 4 son dadas por las ecuaciones mostradas al comienzo de esta sección. Abajo están las ecuaciones de estados

x˙2 =

F
m
(γ + β) = gx5 + gu2 | (1)

x˙4 =

F
m

− g =

F − F0
m

=

u1
m

(2)

x˙6 =

LCG · F

Ixx

β =

LCG · mg

Ixx

u2 | (3)

donde Ts es el periodo de muestreo. Los vectores de entrada y salida son

u(t) =
u1
u2
=
∆F
β

y(t) =

y1
y2
y3
- =

y
z
γ

LIA | 5 ECUACIONES DE MOVIMIENTO DE CUERPO RÍGIDO

tal que las ecuaciones de salida son

y1 = x1 | (4)
y2 = x3 | (5)
y3 = x5 | (6)

Se escriben las matrices del sistema y de control (D = [0])

A =

0 1 0 0 0 0
0 0 0 0 g 0
0 0 0 1 0 0
0 0 0 0 0 0
0 0 0 0 0 1
0 0 0 0 0 0

, B =

0 | 0
0 | g
0 | 0
1
m

0
0 0
0

LCG·mg
Ixx

, C =

1 0 0 0 0 0
0 0 1 0 0 0
0 0 0 0 1 0
- (7)

El sistema mostrado en (7) es fully state controllable.

## 5. Ecuaciones de movimiento de cuerpo rígido

A continuación se mostrarán las ecuaciones de movimiento en el espacio usadas para controlar el vehículo. Se hará referencia a la figura 3 para explicar las variables en juego en el modelo 3D debido a la dificultad inherente de mostrar las 16 variables de estado en un dibujo del modelo 3D.

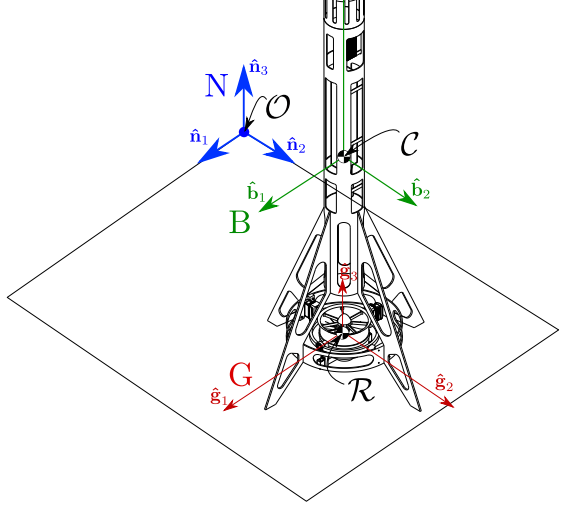
[picture p10: figure]

Figura 4: Marcos de referencia tomados para el análisis de cuerpo rígido. Por simplicidad se toman los centros de masa del cardán y del rotor como coincidentes en el punto R.

LIA | 5 ECUACIONES DE MOVIMIENTO DE CUERPO RÍGIDO

### 5.1. Notación

La notación es la del libro Rigid Body Dynamics of Mechanisms, Theoretical Basics Hahn [2013]. Se requiere un tratamiento algebraico explicito de los marcos de referencia y representación debido al caso especial de un gimballed rotor. Este tratamiento facilita la programación de la simulación y, en consecuencia, el control, el cual se volvería ambiguo y complejo con un tratamiento más común o simplificado.

rCO = [x, y, z] : Posición absoluta del centro de masa del vehículo léase “posición de C respecto O”)

rRC : Posición del centro de masa del cardán respecto al centro de masa del vehículo

η = [φ, θ, ψ] : Ángulos de actitud del vehículo (Ángulos Euler)

ω

G
r

: Velocidad angular del rotor del EDF representado en el marco G (dirección constante)

ω

B
BN : Velocidad angular de B respecto a N, representado en el marco B.

α, β : Ángulo de actuación de vectorización del EDF o ángulo de actitud del marco G

δ : Ángulo de actuación de los dos flaps anti-roll

m : Masa del vehículo sin rotor

mr : Masa del rotor

g : Aceleración de la gravedad

F

B : Empuje del EDF representado en el marco B

ANB : Matriz de transformación de cosenos directores de un marco B a el marco N

Caracterización del EDF

τc : Torque efectivo de control del EDF

KT : Constante de empuje del EDF

KQ : Coeficiente de torque viscoso de fricción

Q : Torque viscoso de fricción

τr : Torque de reacción por el swirl de salida

Caracterización del mecanismo anti-roll:

KFL

: Coeficiente de lift de los flaps anti-roll

KFD

: Coeficiente de drag de los flaps anti-roll

FL : Lift de los flaps anti-roll

FD : Drag de los flaps anti-roll

Matriz de inercia:

J

B
C

: Vehículo sin rotor respecto a C representado en B

J

G
rR : Rotor respecto a R representado en G

J

G
gR : Cardán y motor sin rotor respecto a R representado en G

LIA | 5 ECUACIONES DE MOVIMIENTO DE CUERPO RÍGIDO

### 5.2. Notación del álgebra a utilizar

El producto escalar se define como • para diferenciarlo de simple multiplicación vectorial (·). ω˜ es la matriz skew del vector que reemplaza el producto vectorial ya que r˜· v = r × v

ω˜

L
LR =

0 −ω

L

| zLR, | ωL
| | yLR
ω

L
zLR | 0 | −ω

L
xLR
−ω

L
yLR | ω
| L
| xLR | 0

Se dice que J

B
C

es la matriz de inercia respecto el punto C, representado en el marco B: es decir, las componentes de la matriz de inercia están en la base de B. Esto se puede escribir así:

J

B

C = Jb1bˆ1 + Jb2bˆ2 + Jb3bˆ3

La derivada del término anterior respecto un marco N quedaría escrito

NJ˙B
C =

N dJ

B
C
dt

= ANB
·

B dJ

B
C
dt

Se pueden demostrar las siguientes ecuaciones

A˙ RL = ARL
- ω˜

L
LR = ˜ω

R

LR · ALR = −ω˜

L

LR · ARL | (8)

ABN = (ANB)

> = (ANB)

−1 | ⇒ | ANB
- ABN = I | (9)

donde ω

L
LR es la velocidad angular vectorial del marco L con respecto a R representado en L, ARL es la matriz de cosenos directores que transforma una vector de una base ortogonal L a otra base ortogonal R, y A˙ RL es la derivada de la matriz ARL respecto R.

LIA | 5 ECUACIONES DE MOVIMIENTO DE CUERPO RÍGIDO

### 5.3. Variables de estado

Se tendrán las variables de estado de posición y velocidad donde z positivo es alejándose de la tierra.
r

N
CO =

x y z
, r˙

N
CO =
x˙ y˙ z˙

El movimiento cuerpo rígido será descrito por 3 ángulos de Euler (Cardán o Bryant en algunas bibliografías) φ, θ y ψ (roll, pitch, yaw respectivamente).

η =

φ θ ψ
(10)

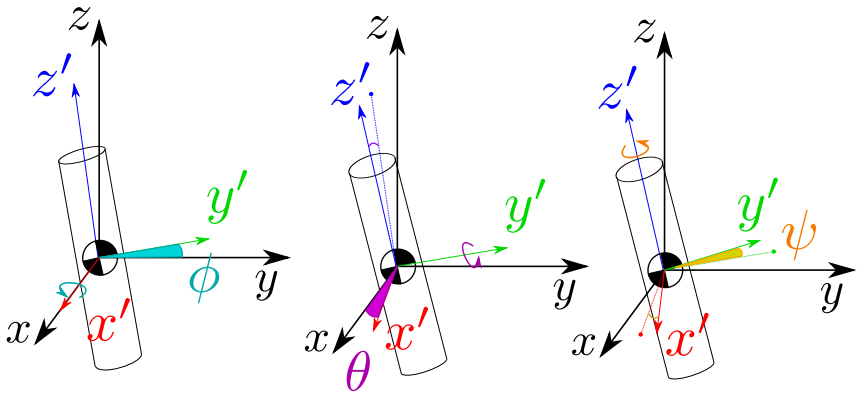
[picture p11: figure]

Figura 5: Diagrama mostrando las rotaciones de ángulo de euler en el orden que son efectuadas para describir el sistema. φ representa el pitch, θ el yaw y ψ el roll. Se muestran las últimas posiciones de los ejes rotados con una linea punteada.

Los ángulos de la vectorización de la tobera serán α y β. δ corresponde a los actuadores que contrarrestan el roll del vehículo mediante dos flaps. Los ángulos α y β describen la dirección en la que está apuntando la tobera (equivalente a la orientación G) respecto la dirección del vehículo (marco B). ωr = ω

G
r

es la velocidad angular del rotor.

Se escriben las variables de estado y el vector input, donde F es la fuerza que hace la tobera sobre el vehículo (la cual depende de la velocidad del vehículo)⁷

x =

r

N
CO η r˙

N
CO ω

B

BN | ωr | α β δ > | (11)

u =

τc | α˙ | β˙ | ˙δ
> | (12)

En la próxima sección se buscará obtener el vector de variables de estado derivado en el tiempo x˙ .

### 5.4. Ecuaciones diferenciales

Definimos la transformación de los ángulos euler con una matriz de transformación ABN donde c y s son las funciones coseno y seno, respectivamente.

ABN =

c θ · c ψ | c θ · s ψ | − s θ
s φ · s θ · c ψ − c φ · s ψ s φ · s θ · s ψ + c φ · c ψ s φ · c θ c φ · s θ · c ψ + s φ · s ψ c φ · s θ · s ψ − s φ · c ψ c φ · c θ
- (13)

La transformación nos servirá para poder pasar de la dinámica que está definida en el marco del vehículo B al marco N donde se tienen las variables de estado que se desean controlar.

7En el código φ, θ y ψ aparecen como q,r,s

LIA | 5 ECUACIONES DE MOVIMIENTO DE CUERPO RÍGIDO

Podemos obtener la velocidad en el marco del cuerpo

r˙

B

CO = ABN · r˙
N
CO | (14)

La obtención de la velocidad angular del cuerpo se complica por el hecho que la razón de cambio de los ángulos de Euler no son vectores cartesianos, si no más bien parámetros que describen la orientación del cuerpo rígido en el espacio.⁸ Para relacionar la velocidad angular con η es necesario utilizar la matriz de actitud cinemática H(η).

H(η) =

1 sin(φ) tan(θ) cos(φ) tan(θ)
0 | cos(φ) | − sin(φ)
0 sin(φ) sec(θ) cos(φ) sec(θ)
- (15)

La matriz de actitud cinemática se usa para transformar

η˙ = H(η) · ω

N
BN | (16)

ω

B

BN = ABN · ω
N
BN | (17)

e inversamente

ω

N

BN = H⁻¹
(η) · η˙ | (18) (19)

La fuerza que impulsa al vehículo en el marco del cuerpo se obtiene transformando del marco del cardán donde se conocen los componentes, al marco cuerpo. La matriz es calculada reemplazando φ ≡ α, θ ≡ β, y ψ = 0.

F

B = ABG · F

G | (20)

La aceleración del centro de masa del vehículo medido en el marco del cuerpo B es igualada a la fuerza
B d
dt
r˙

B
CO
=

1
m + mr
- F

B
| (21)

luego obtenemos la aceleración en coordenadas globales

¨r

N

CO = ANB
·

B d
dt
r˙

B
CO
− g
N | (22)

Los momentos actuantes externos en el marco del vehículo respecto su centro de gravedad C están en función del diseño de los flaps anti roll Romarowski [2020].

MB
C = ˜r

B
RC · F

B + ABG ·

0
0
ω

2
rKFL

dT δ + τr

- (23)

La aceleración angular en el marco B sale del desarrollo de la sección 5.5

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
BN · J

B
C
- ω

B

BN − ABG · ω˜

G
GB · J

G
rR · ω

G
r − ω˜

B
BN · J

G
rR · ω

G

r − ABG · J

G
rC

·

Nω˙

G
r + MB
C
(24)
El rotor y los servos son modelados como de primer orden por el momento. Son limitados por velocidad máxima según sus especificaciones.
Las ecuaciones diferenciales se pueden entonces escribir

x˙ =

r˙

N
CO η˙ ¨r

N
CO

B d
dt
ω

B
BN
ω˙ r | α˙ | β˙ | ˙δ
> | (25)

8Como bien sabemos la matriz de transformación A solo es aplicable para transformar vectores cartesianos de una base ortogonal a otra. Los parámetros η conforman un vector de configuración, no un vector cartesiano!

LIA | 5 ECUACIONES DE MOVIMIENTO DE CUERPO RÍGIDO

### 5.5. Dinámica angular del vehículo

El momento angular del vehículo respecto de su centro de masa (C) y representado en el marco fijo-tierra N debe tomar en cuenta el momento angular por tener un cuerpo con velocidad lineal y angular propia.

L

N

C = ANB
- J

B
C
- ω

B
BN | | {z | }

Vehículo

+ ANGJ

G
gR · ω

G
GN + mg · ˜r

N
RC · r˙

N
RC
| | {z | }
Cardán & EDF

+ ANG · J

G
rR · ω

G
r + mr · ˜r

N
RC · r˙

N
RC
| | {z | }
Rotor
(26)
Esta ecuación describe los efectos de tener un cardán con un rotor integrado acoplado al vehículo sin embargo algunos términos se podrían considerar despreciables debido al diseño del cardán.
Ambos gimbals del cardán tienen su eje de giro cercano a su centro de masa lo cual significa que la velocidad relativa entre los puntos R y C va tener poco impacto sobre los torques internos del vehículo. Se considera que
r˙RC = 0 | (27)

La velocidad angular de los gimbals es poca ya que su actuación ocurre en el orden de la décima de grado lo cual implica un bajo impacto del término del cardán cuando es integrado en el tiempo. El término ANGJ

G
gR ·ω

G
GN entonces pasa a formar parte de la inercia del resto del vehículo J

B
C

, el cual ahora solo excluye al rotor. El momento angular nos queda simplificado:

L

N

C = ANB
- J

B
C
- ω

B

BN + ANGJ

G
rR · ω

G
r

(28)

donde ωr es la velocidad del rotor y J

G
rR es la matriz de inercia del rotor tomado alrededor de su centro de masa representado en coordenadas del marco cardán G. Derivamos el momento angular con respecto a N y junto con J

B
C ≈ constante 9

NL˙ N
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
BN + ANG · J

G
rR · ω

G
r

= A˙ NB
- J

B
C
- ω

B

BN + ANB
·

NJ˙B
C
|{z}
≈0

·ω

B

BN + ANB
- J

B
C
- ω˙

B

BN + A˙ NG · J
G
rR · ω

G

r + ANG ·

N d
dt
J

G
rR · ω

G
r

la derivada de la inercia del cuerpo se anula y luego se aplica la regla de la cadena a la derivada

NL˙ N

C = A˙ NB
- J

B
C
- ω

B

BN + ANB
- J

B
C
- ω˙

B

BN + A˙ NG · J
G
rR · ω

G

r + ANG ·

N d
dt
J

G
rR · ω

G
r

= ANB
- ω˜

B
BN · J

B
C
- ω

B

BN + ANB
- J

B
C
- ω˙

B

BN + ANG · ω˜

G
GN · J

G
rR · ω

G

r + ANG ·

NJ˙G
rR · ω

G
r + J

G
rR ·

Nω˙

G
r

donde J˙G
rR se puede considerar despreciable por la geometría ligera del conjunto cardán y por actuaciones pequeñas (mencionadas anteriormente).

Como el rotor es fijo a al vehículo alrededor de un punto cercano a R y el movimiento del gimbal es restringido por los actuadores se supone que el rotor es parte del cuerpo rígido del vehículo y se plantea su momento angular como un vector libre. Así podemos igualar J

G
rR ≡ J

G
rC = J

G
r

, y por extensión, J

B
R ≡ J

B
C

= ANB
- ω˜

B
BN · J

B
C
- ω

B
BN + ANB
- J

B
C
- ω˙

B

BN + ANG · ω˜

G
GN · J

G
r
- ω

G

r + ANG · J

G
r

·

Nω˙

G
r

9La inercia del vehículo en su propio marco J

B
C es constante excepto por las variaciones introducidas al agruparlo con el término del cardán J

B
gC, el cual varía en función a la actuación α, β.

LIA | 5 ECUACIONES DE MOVIMIENTO DE CUERPO RÍGIDO

multiplicando por ABN

ABNX

i

MN
iC =

X

i

MB
iC = ˜ω

B
BN · J

B
C
- ω

B
BN + J

B
C
- ω˙

B

BN + ABG · ω˜

G
GN · J

G
r
- ω

G

r + ABG · J

G
r

·

Nω˙

G
r

entonces

J

B
C
- ω˙

B
BN = −ω˜

B
BN · J

B
C
- ω

B

BN − ABG · ω˜

G
GN · J

G
r
- ω

G

r − ABG · J

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
donde ω

G
GN = ω

G
GB + ω

G
BN = ω

G
GB + AGBω
B
BN | Esto está bien?
| el término ω˜ B BN ·
| J G
| r ·ω G r nos hace
| ruido

J

B
C
- ω˙

B
BN = −ω˜

B
BN · J

B
C
- ω

B

BN − ABG · ω˜

G
GB · J

G
r
- ω

G

r − ABGAGB
- ω˜

B
BN · J

G
r
- ω

G

r − ABG · J

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
= −ω˜

B
BN · J

B
C
- ω

B

BN − ABG · ω˜

G
GB · J

G
r
- ω

G
r − ω˜

B
BN · J

G
r
- ω

G

r − ABG · J

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
donde Nω˙

G

r = AGN ·

Gω˙

G

r = AGN · ω˙ rˆg3 | AGN debería
| ser ANG posi-
| blemente

LIA | 6 SIMULACIÓN

## 6. Simulación

Para comprobar el sistema de control se definió el sistema no-lineal en Matlab , se obtuvo el sistema lineal sobre un punto de operación tomando el jacobiano del sistema de ecuaciones diferenciales para controlar el sistema, y finalmente se integró el sistema no lineal en el tiempo retroalimentado con el sistema de control.
Se investigó la respuesta del vehículo ante perturbaciones Delta-Dirac de orientación.

### 6.1. Sistema no-lineal

El sistema (25) describe la dinámica no-lineal del vehículo con 16 ecuaciones. Estas pueden ser integradas mediante un método numérico para ecuaciones diferenciales ordinarias multivariables no-autónomas. El requerimiento no-autónomo surge de la necesidad de incorporar el vector u a la integración, el cual incluye las actuaciones en base a lo que leen los sensores.

Para satisfacer el requerimiento no-autónomo se tuvo que implementar un método numérico basado en Runge-Kutta orden 4. El método fue probado y contrastado con soluciones analíticas conocidas.

### 6.2. Sistema de control

Se optó por controlar mediante el controlador LQR debido a la simplicidad de implementación y adaptabilidad para problemas de variables de estado. Como se mencionó anteriormente, se obtiene el jacobiano del sistema (25) alrededor del punto de operación. Esta es la matriz del sistema A. La matriz B también es el jacobiano del sistema pero diferenciado respecto u. Finalmente, C es la combinación lineal de las mediciones de los sensores (ver sección 4 para entender el proceso).
Se modelaron las siguientes imperfecciones en el sistema:

Delay en medición/actuación

Desalineación de sensores (acelerómetro y giroscopio)

| Resolución mínima de actuación del gimbal según lo visto en la sección 3.4

La matriz costo asociada al equilibrio es construida asignando los siguientes valores a la diagonal: 5 a las posiciones globales, 1 a las velocidades, 1e-3 a la velocidad del rotor del EDF, 1e-4 a la velocidad angular en pitch y yaw del vehículo, y 1e-5 a las variables restantes (actuadores, ángulos de Euler y velocidad angular en roll).

La matriz costo asociada a los actuadores es diagonal con los siguientes valores: 1000 a actuadores de pitch y yaw del gimbal, 1e-5 al actuador de roll, y 1e-6 al control velocidad del rotor del EDF.

### 6.3. Resultados de simulación

Todos los ejes x corresponden al tiempo en segundos.

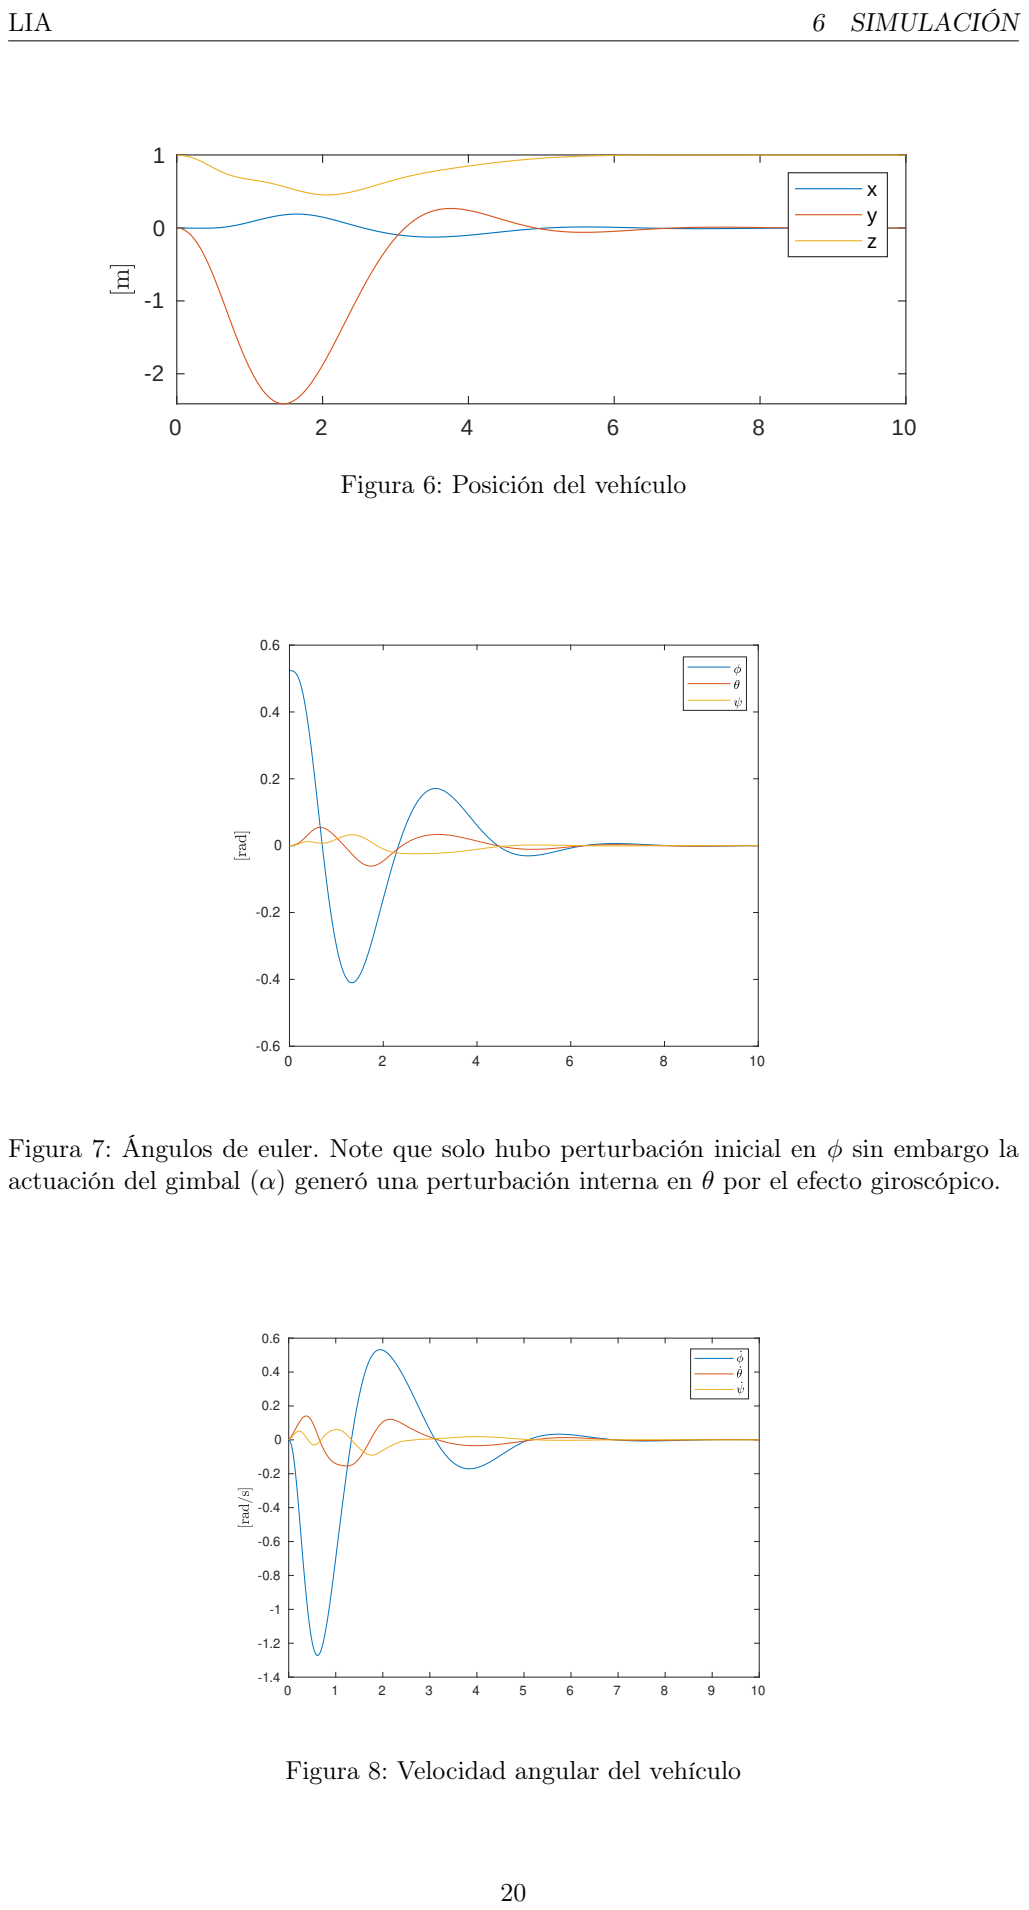
[picture p12: page 22]
LIA; 6 SIMULACIÓN

Figura 6: Posición del vehículo

Figura 7: Ángulos de euler. Note que solo hubo perturbación inicial en φ sin embargo la
actuación del gimbal (α) generó una perturbación interna en θ por el efecto giroscópico.

Figura 8: Velocidad angular del vehículo

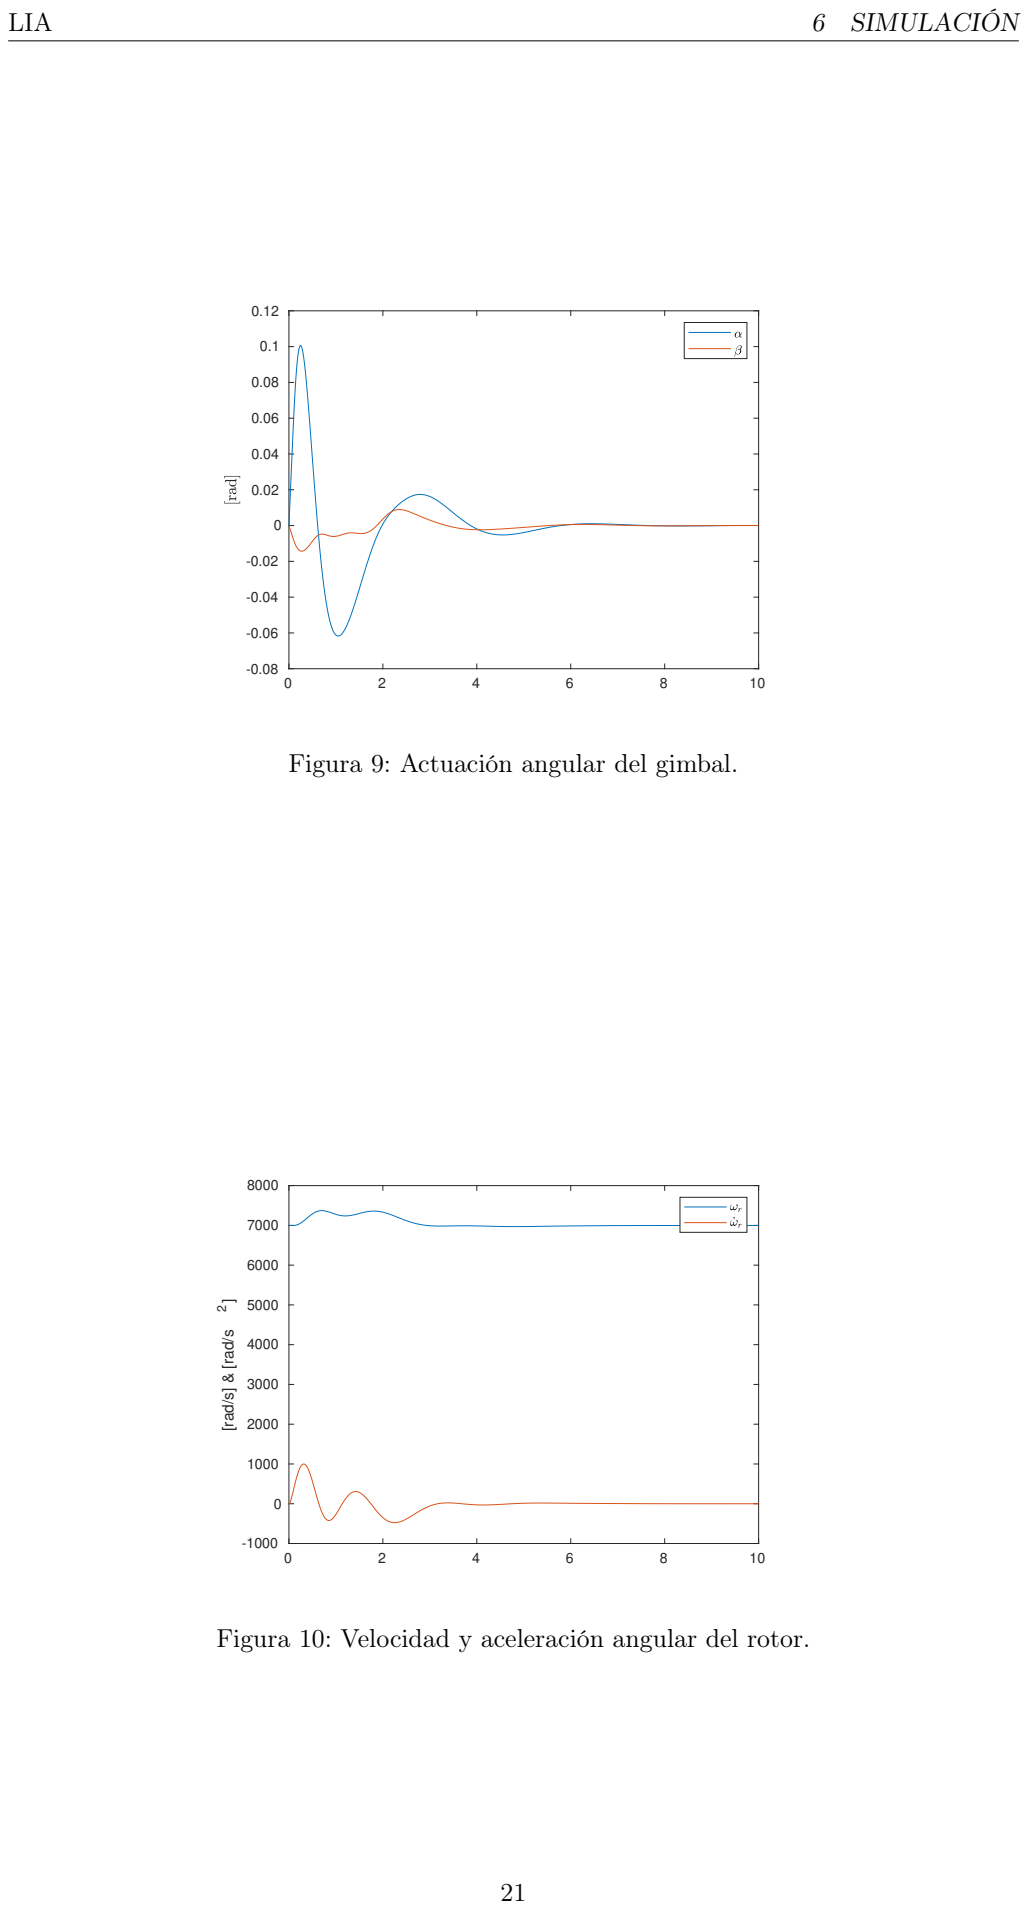
[picture p13: page 23]
LIA; 6 SIMULACIÓN; [rad/s] & [rad/s

Figura 9: Actuación angular del gimbal.

Figura 10: Velocidad y aceleración angular del rotor.

LIA | 7 DESARROLLO DE SOFTWARE

## 7. Desarrollo de software

La decisión de software a usar depende del controlador a usar, poder de cálculo disponible, interfases de periféricos y funcionalidad deseada.

La Raspberry Pi provee un entorno con Linux instalado que permite la programación con virtualmente cualquier lenguaje de programación en existencia. Dado estas condiciones, el lenguaje de programación elegido es Go (Golang) debido a los siguientes puntos

| Seguro - Modelo de memoria Go, sistema de tipado fuerte¹⁰

Simple - Claridad de sintaxis

| Concurrencia - Crear corrutinas es simple, paralelizar corrutinas es trivial
| Rendimiento - Superior a Python, Java y Matlab. Comparable a C. Esto también
implica un menor consumo de energía
| Estable - The Go 1 promise (La promesa Go 1)
| Comprobado - Usado en sistemas de alto-riesgo/alta-complejidad (Kubernetes, Doc-
ker, Go-HEP)
| Portable - Todos los programas Go compilan a código nativo (código de máquina) para cualquier arquitectura y sistema operativo. Incluso se puede programar micro-

controladores (TinyGo)

### 7.1. Flujo de control

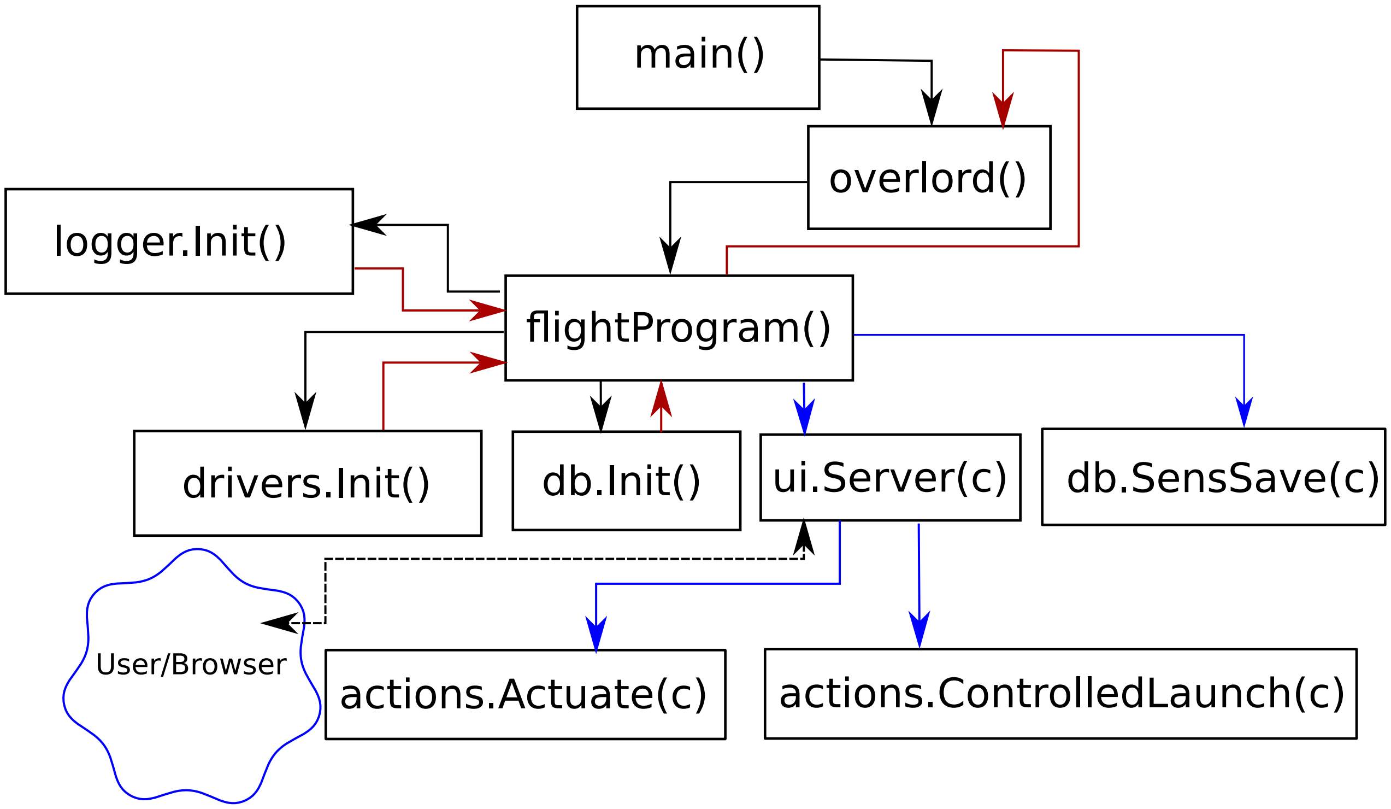
[picture p14: figure]
main(); overlord(); ightProgram(); drivers.Init(); db.Init(); ui.Server(c); db.SensSave(c); actions.Actuate(c); actions.ControlledLaunch(c); User/Browser; logger.Init()

Figura 11: Gráfico de flujo de control (CFG) del programa de vuelo. Las lineas de flujo azules son corrutinas independientes al programa principal. Las lineas negras son flujo del programa principal. Las lineas rojas son flujo del programa principal al encontrar un error.

Se ilustra el flujo de control a grandes rasgos usando un CFG en la figura 11. El programa principal corre la rutina overlord que a su vez comanda flightProgram y espera que esta devuelva control a overlord. El propósito de overlord es guardar el estado del vehículo y ante una falla irrecuperable en flightProgram, terminar con todas las corrutinas generadas por flightProgram y sus afiliadas y a su vez reiniciar flightProgram nuevamente con el último estado antes de la falla.

10Hoy en día hay pocos lenguajes con sistemas de tipos fuertes. Contrario a la creencia popular, C y C++ ambos son tipados débilmente.

LIA | REFERENCIAS

### 7.2. Interfaz con hardware

Como se mencionó anteriormente, la computadora elegida tiene varios puertos que servirán como interfases con periféricos, entre ellos

ADC (sensores)

Generadores de PWM (para actuadores)

Blinkenlights

Para la interacción del software con el hardware se usará la librería periph.io. Esta librería permite la interacción a través de los protocolos de comunicación de la Raspberry Pi. Los drivers para los periféricos fueron programados según la información dada en las datasheet.

### 7.3. Implementación

Al momento de documentar los avances el programa de vuelo tiene 3540 líneas de lógica, de las cuales 1680 corresponden a los drivers de control de periféricos. Se logra controlar la actuación de hasta 12 señales PWM y en simultaneo leer 16 señales de telemetría y guardar a archivo en una tarjeta SD a 1200 muestras por segundo (cada canal). 1060 líneas de código son dedicadas a la interfaz de usuario para facilitar el control del vehículo desde un browser, como por ejemplo Firefox.

Agradecimientos

Dan Etenberg por hacer todo posible. Pablo Cossutta por compartir su experiencia trabajando con sistemas de potencia. Ben Romarowski por ayuda con la aerodinámica de los álabes.

## Referencias

Miguel Ángel Castillo-Martínez, Blanca Esther Carvajal-Gámez, and Francisco Javier Gallegos Funes. Efectos en la resolución de servomotores con interfaz pwm por la generación de señales en microcontroladores. Research in Computing Science, 147:89–98, 2018.

Hubert Hahn. Rigid Body Dynamics of Mechanisms: 1 Theoretical Basis. Springer Science & Business Media, 2013.

Ben Romarowski. Dynamics and control of gimballed edf. Technical report, LIA Aerospace, 2020.
