soypat/proy-final/chapter/model2d_es.tex

\section{Modelo 2D simplificado} \label{sec:model2d}

Esta siguiente sección detallará el tratamiento matemático efectuado para controlar un vehículo con propulsión vectorizada en el plano. El propósito es ilustrar a un nivel simple las herramientas que se aplicaron para controlar un vehículo VTVL propulsado por un motor cohete. Se asume que el vehículo se encuentra en el plano y que el control de propulsión vectorizada se efectúa por medio de un ángulo de inclinación del motor.

\begin{figure}[htb!]
	\centering
	
	\caption{Diagrama de cuerpo libre de un vehículo con propulsión vectorizada 2D.}
	\label{fig:FBD2D}
\end{figure}

\subsection{Modelado matemático}
Se comenzó con las ecuaciones dinámicas de un vehículo en el plano con control de propulsión vectorizada (por ángulo)

\[
\left\{
\begin{array}{l}
	\ddot{y}=\frac{F}{m} \sin(\gamma+\beta) \\
	\ddot{z}=\frac{F}{m} \cos (\gamma+\beta)-g \\
	\ddot{\gamma} = -\frac{L_{\CG}\cdot F}{I_{xx}}\sin(\beta)
\end{array}
\right.
\]
donde \(\LCG\) y \(F\) están en función del tiempo, $m =m_0 - \int \dot{m} $ y $\theta = \gamma+\beta$. Por cuestiones demostrativas de este ejercicio se desprecia el rozamiento con el aire. 

\subsection{Armado de sistema lineal}
Para controlar el sistema se aplicará la teoría de control óptimo. Para ello se deberá linealizar el sistema alrededor de un punto de operación. El estado del vehículo alrededor del cual se linealizó en este caso fue \textit{vertical y quieto en el espacio}.\footnote{La linealización es valida solo para un vehículo vertical. Se deberá modificar el método para modelar un vehículo que se inclina para volar correctamente.} 

\begin{align*}
	\gamma^* = 0 \\
	\beta^* = 0 \\
	F^* = mg
\end{align*}
en este caso $F$ fue la desviación del punto de operación siendo $\Delta F = F- mg$.

\subsection{Representación en espacio de estados}
El número de variables de estado fue igual a número de almacenadores de energía independientes. Estos son

\begin{enumerate}
	\item[$z$] Energía potencial por la gravedad
	\item[$\dot{z}$,] $\dot{y}$  Energía cinética del vehículo
	\item[$\dot{\gamma}$] Momento angular del vehículo
\end{enumerate}
entonces, las variables de estado fueron las siguientes
\begin{align*}
	x_1 = y \\
	x_2 = \dot{y} \\
	x_3 = z \\
	x_4 = \dot{z} \\
	x_5 = \gamma \\
	x_6 = \dot{\gamma}
\end{align*}
donde $\dot{x_1} = x_2$, $\dot{x_3} = x_4$ y $\dot{x_5} = x_6$

Se aprovecho la expansión de Taylor para la linealización de expresiones trigonométricas:
\[
\sin(x+y)|_{x=x_0+\Delta x,y=y_0+\Delta y} \approx \sin(x_0+y_0) + \cos(x_0 + y_0) (x-x_0) + \cos(x_0 + y_0) (y-y_0)
\]
% \todo{Revertir cambios tiempo pasado}
Las ecuaciones dinámicas de los estados 2, 3, y 4 fueron dadas por las ecuaciones mostradas al comienzo de esta sección.

Abajo se encuentran las ecuaciones de estados
\begin{equation}
	\dot{x_2} = \frac{F}{m} \left( \gamma+\beta \right) = g x_5 + g u_2 
\end{equation}
\begin{equation}
\dot{x_4} = \frac{F}{m} - g =\frac{F-F_0}{m}= \frac{u_1}{m}
\end{equation}
\begin{equation}
\dot{x_6} = -\frac{\LCG \cdot F}{I_{xx}} \beta = -\frac{\LCG \cdot mg}{I_{xx}} u_2 
\end{equation}

donde $\Ts$ es el periodo de muestreo.

Los vectores de entrada y salida resultaron
\[
\Cme{u}(t) = \begin{bmatrix}
u_1 \\
u_2
\end{bmatrix} = \begin{bmatrix}
\Delta F \\
\beta
\end{bmatrix}
\]
\[
\Cme{y}(t) = \begin{bmatrix}
y_1 \\
y_2 \\
y_3
\end{bmatrix} = \begin{bmatrix}
y \\
z \\
\gamma
\end{bmatrix}
\]
tal que las ecuaciones de salida son

\begin{equation}
	y_1 = x_1 
\end{equation}
\begin{equation}
	y_2 = x_3
\end{equation}
\begin{equation}
	y_3 = x_5
\end{equation}

Se calcularon las matrices del sistema y de control ($\Mme{D} = [0]$)
\begin{equation} \label{eq:ssmatrices}
	\Mme{A} = 
	\left[\begin{array}{cccccc} 0 & 1 & 0 & 0 & 0 & 0\\ 0 & 0 & 0 & 0 & g & 0\\ 0 & 0 & 0 & 1 & 0 & 0\\ 0 & 0 & 0 & 0 & 0 & 0\\ 0 & 0 & 0 & 0 & 0 & 1\\ 0 & 0 & 0 & 0 & 0 & 0 \end{array}\right],\quad \Mme{B} = 
	\left[\begin{array}{cc} 0 & 0\\ 0 & g\\ 0 & 0\\ \frac{1}{m} & 0\\ 0 & 0\\ 0 & -\frac{\LCG \cdot mg}{I_{xx}} \end{array}\right], \quad \Mme{C} =  \left[\begin{array}{cccccc} 1 & 0 & 0 & 0 & 0 & 0\\ 0 & 0 & 1 & 0 & 0 & 0\\ 0 & 0 & 0 & 0 & 1 & 0 \end{array}\right]
\end{equation}
El sistema mostrado en \eqref{eq:ssmatrices} es \textit{fully state controllable}.
