soypat/proy-final/tex/beamer_preamble.tex

\usepackage[utf8]{inputenc}
\usepackage[T1]{fontenc}
\usepackage[utopia]{mathdesign}
\usetheme[progressbar=frametitle]{metropolis}

\usepackage{amsmath}
\usepackage[spanish, mexico]{babel}
\usepackage{graphicx}
% \usepackage{xcolor}
\usefonttheme[onlymath]{serif}
\usepackage{natbib}

% Footnotes.
% \makeatother
% \renewcommand{\thefootnote}{\ifcase\value{footnote}\or$\dagger$\or
% $\ast$\or\$\or\#\or\ddagger\or$\therefore$\fi}
% \makeatletter
