soypat/proy-final/tex/code.tex

%\usepackage{bigfoot} % to allow verbatim in footnote
\usepackage[numbered,framed]{matlab-prettifier}

\let\ph\mlplaceholder % shorter macro
\lstMakeShortInline"
\renewcommand{\lstlistingname}{Código}
\renewcommand{\lstlistlistingname }{Códigos \Matlab}
\lstset{
  style              = Matlab-editor,
  basicstyle         = \mlttfamily,
  escapechar         = ",
  mlshowsectionrules = true,
  numbers = none,
  tabsize=4,
  literate = {-}{-}1,
}
\lstnewenvironment{sflisting}[1][]
{\lstset{#1}\mathversion{sans}}{}
