soypat/proy-final/fig/design/0.png

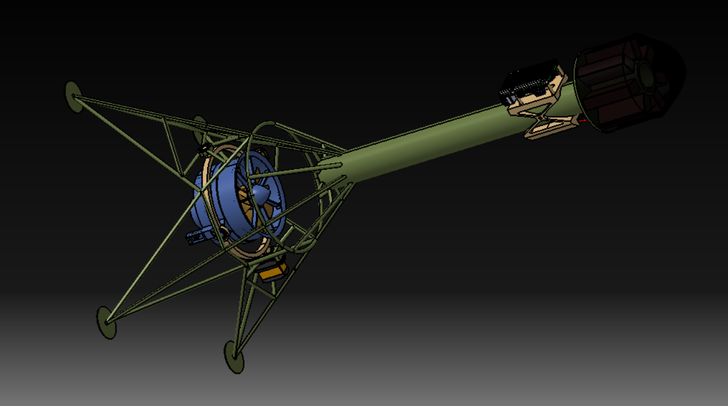
fig/design/0.png
