soypat/proy-final/fig/design/1.png

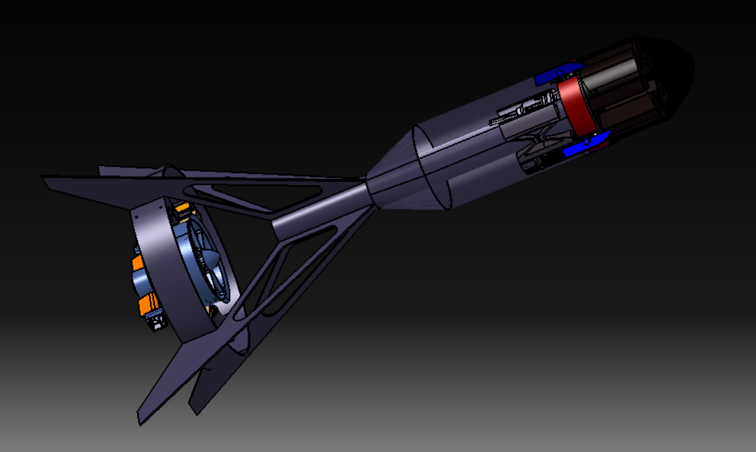
fig/design/1.png
