soypat/proy-final/fig/design/2.png

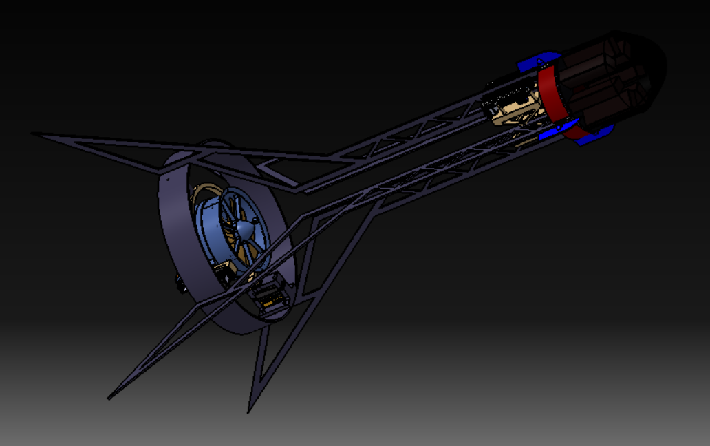
fig/design/2.png
