soypat/proy-final/fig/design/3.png

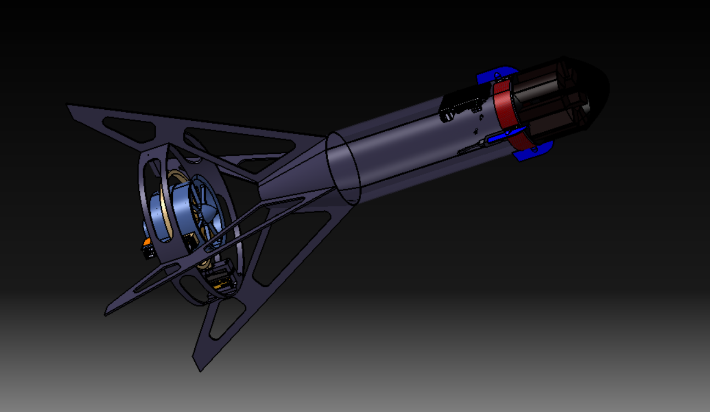
fig/design/3.png
