soypat/proy-final/fig/design/4.png

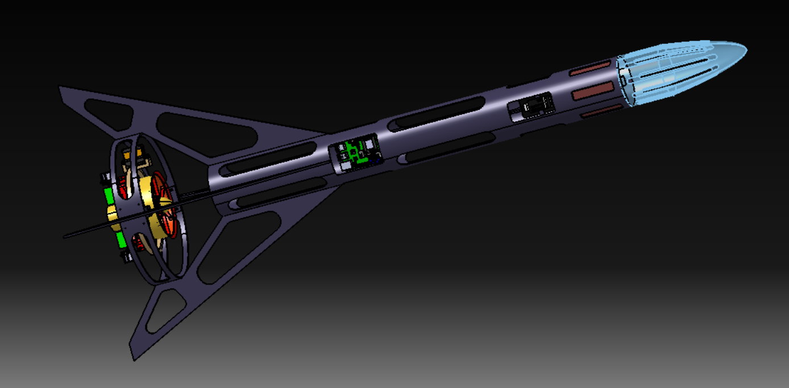
fig/design/4.png
