soypat/proy-final/fig/design/5.png

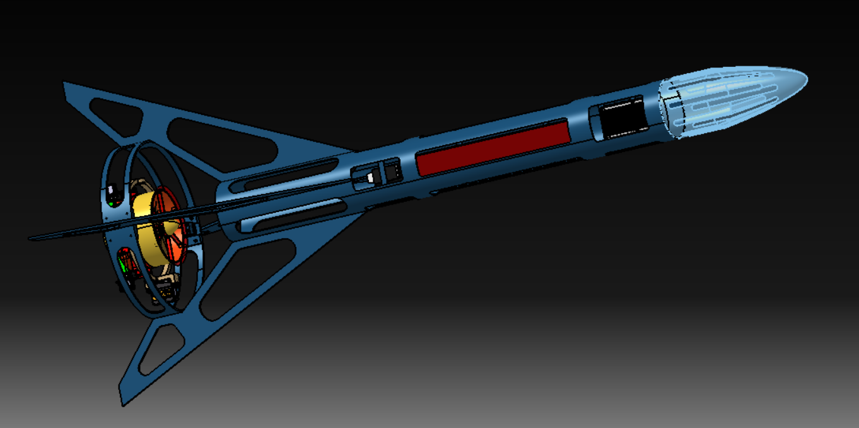
fig/design/5.png
