soypat/proy-final/fig/design/7.png

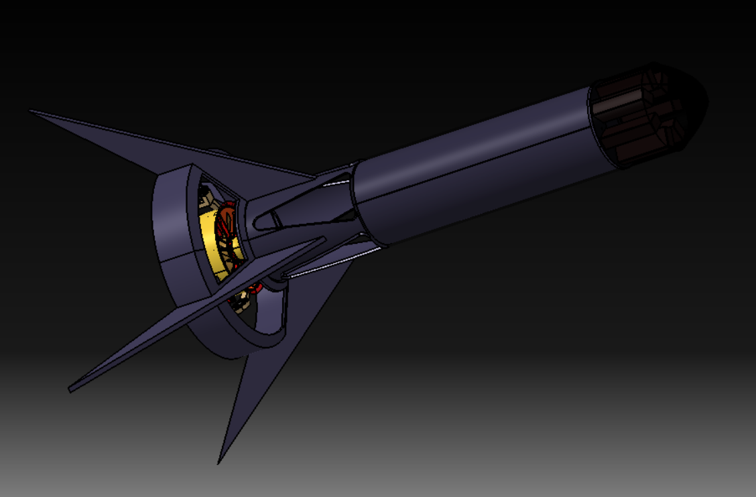
fig/design/7.png
