soypat/proy-final/fig/design/8.png

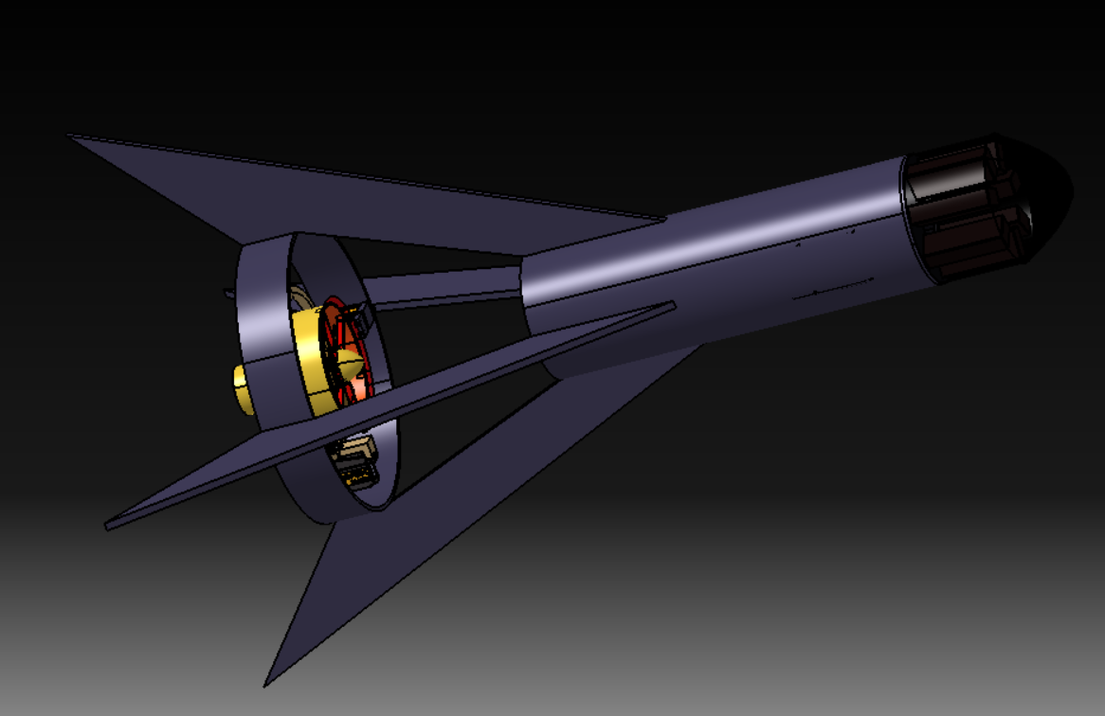
fig/design/8.png
