soypat/proy-final/fig/design/v6.png

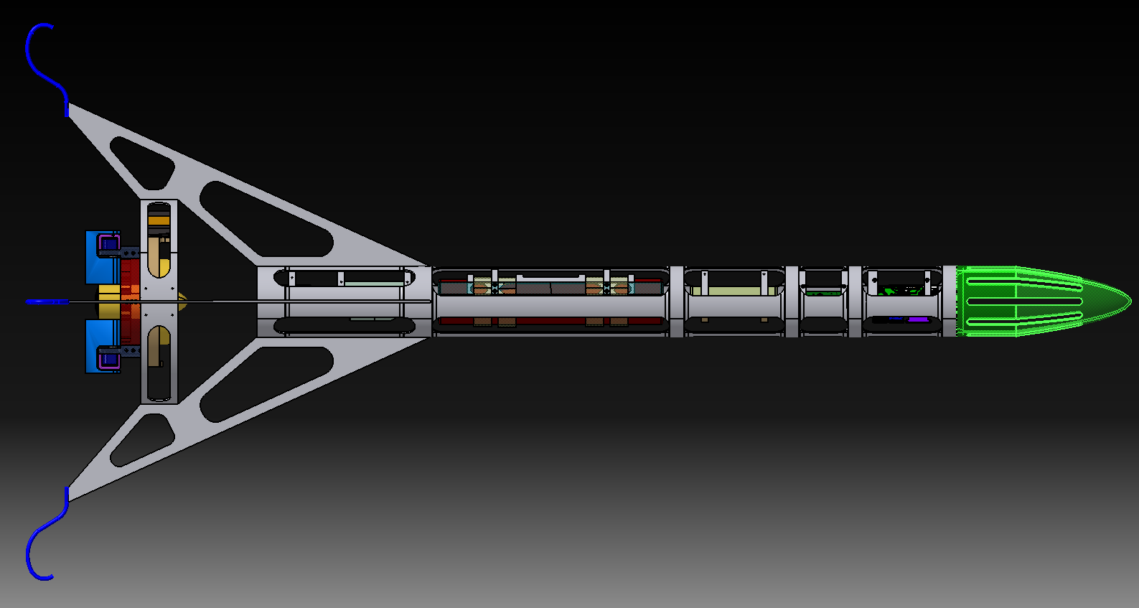
fig/design/v6.png
