soypat/proy-final/fig/design/v6_1.png

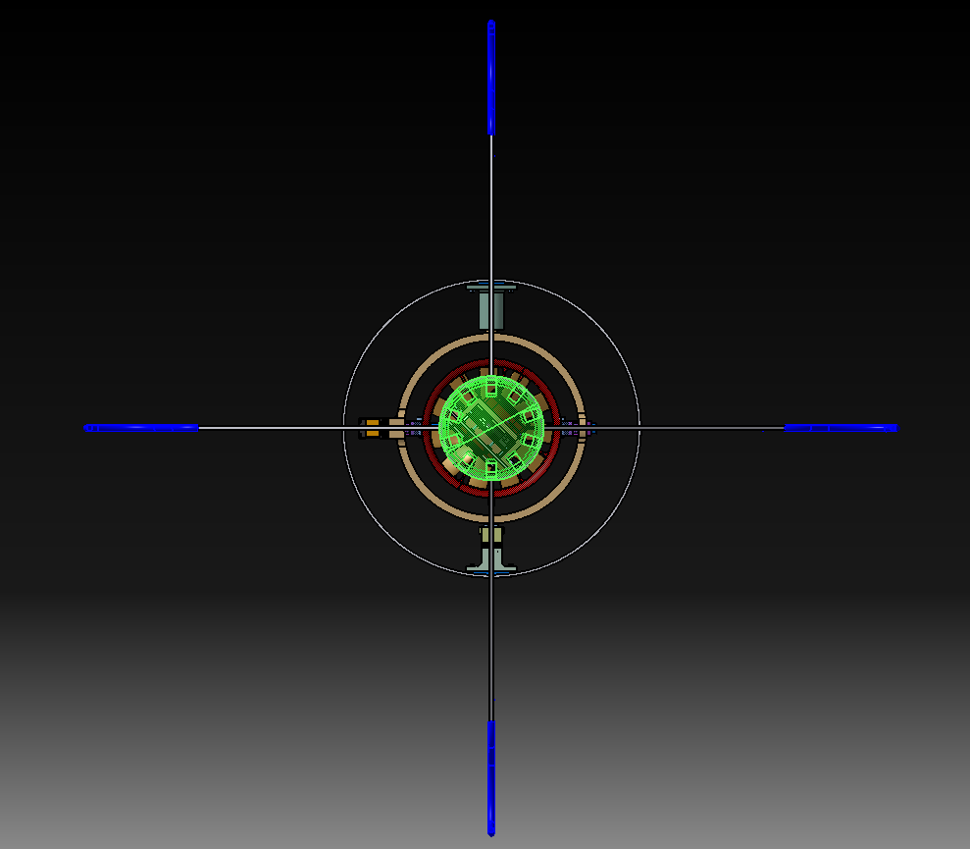
fig/design/v6_1.png
