soypat/proy-final/fig/design/v6_2.png

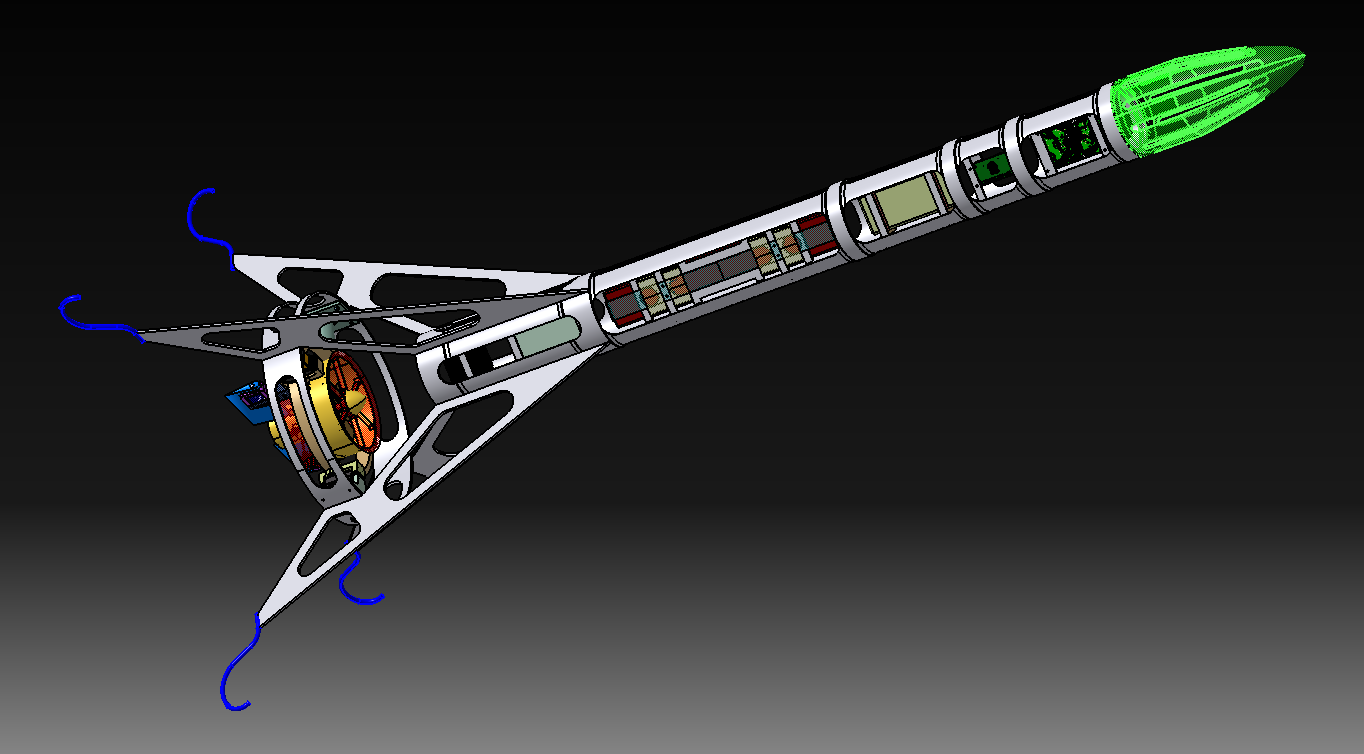
fig/design/v6_2.png
