soypat/proy-final/fig/design/v6_3.png

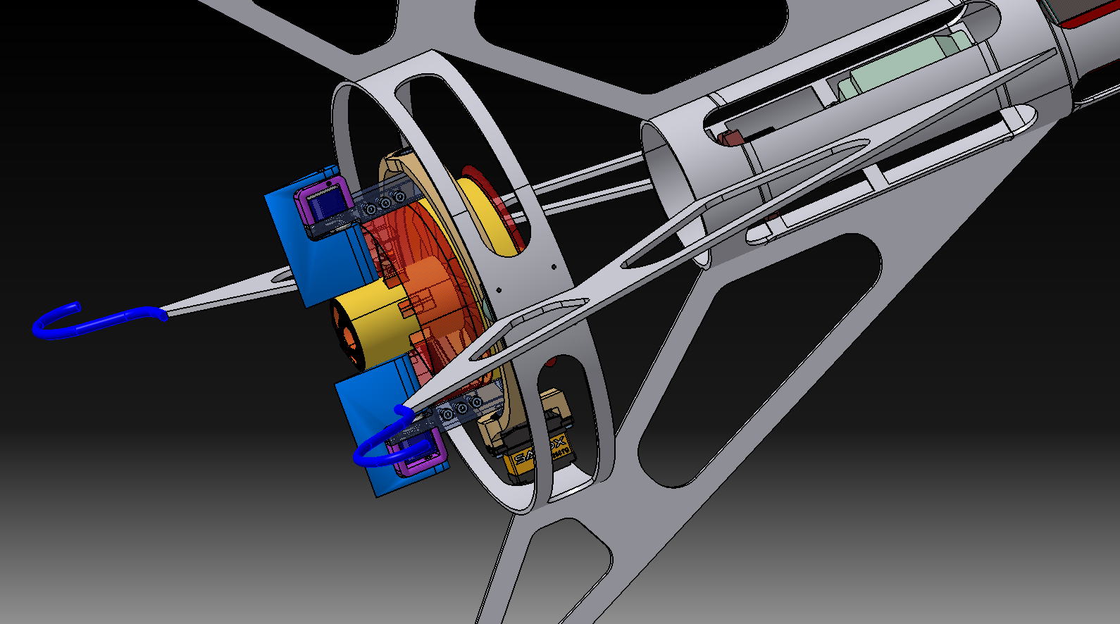
fig/design/v6_3.png
