soypat/proy-final/fig/design/v6_4.png

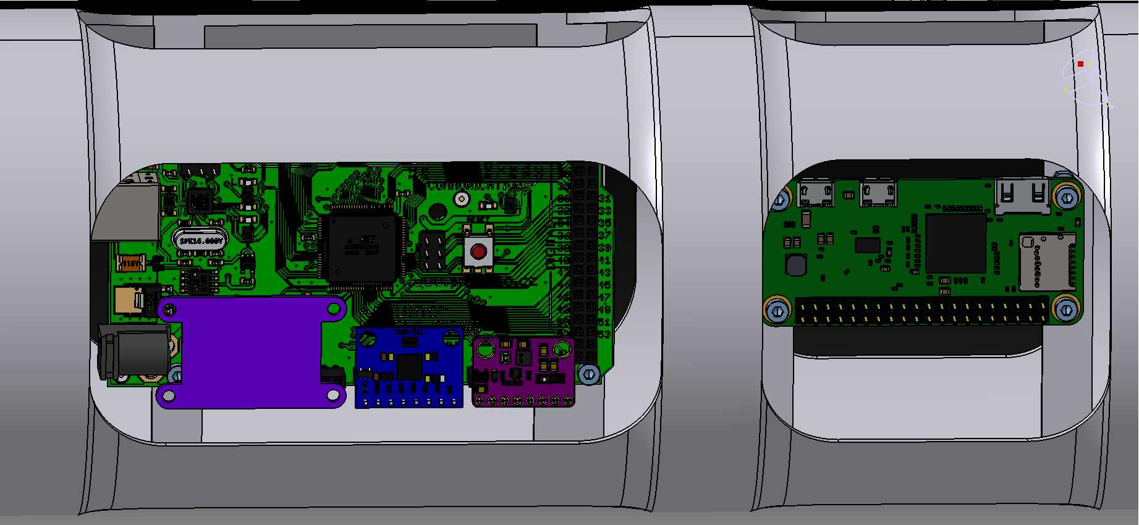
fig/design/v6_4.png
