soypat/proy-final/fig/design/v6_5.png

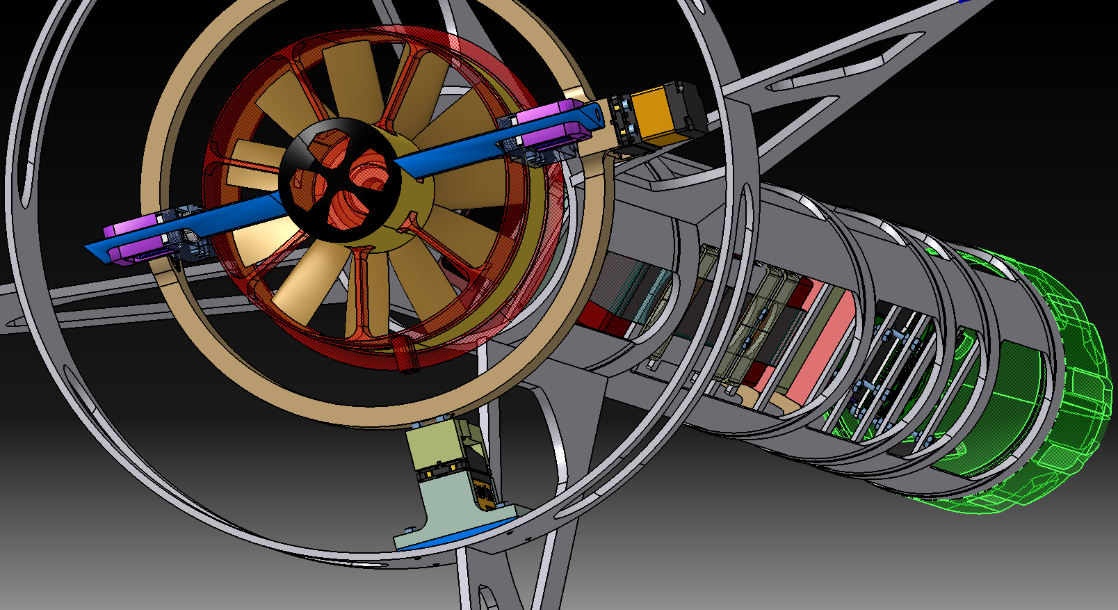
fig/design/v6_5.png
