soypat/proy-final/fig/design/v6_6.png

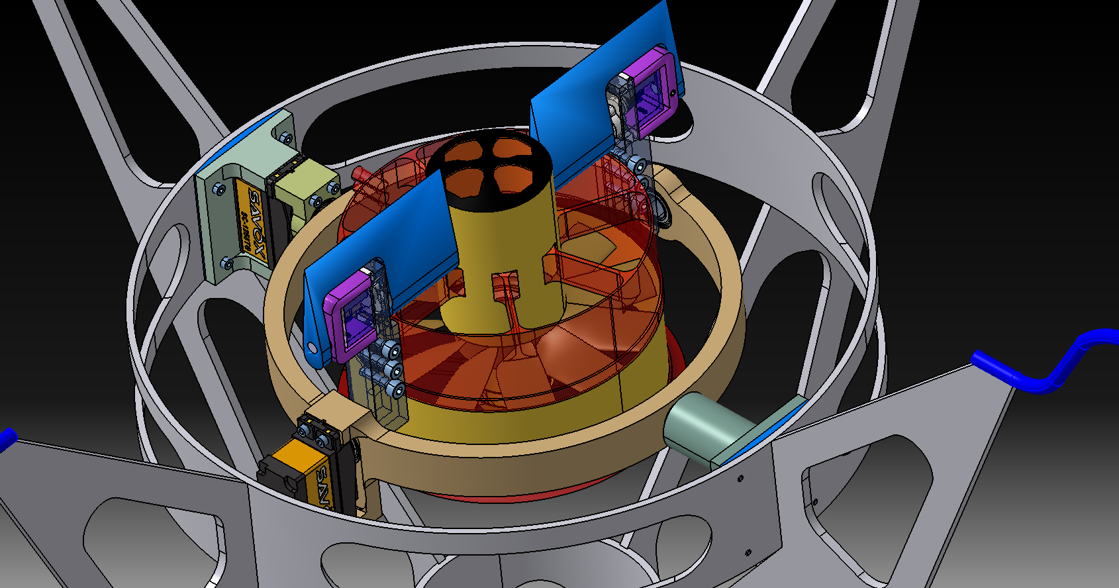
fig/design/v6_6.png
