soypat/proy-final/fig/fea/imagenpatas.png

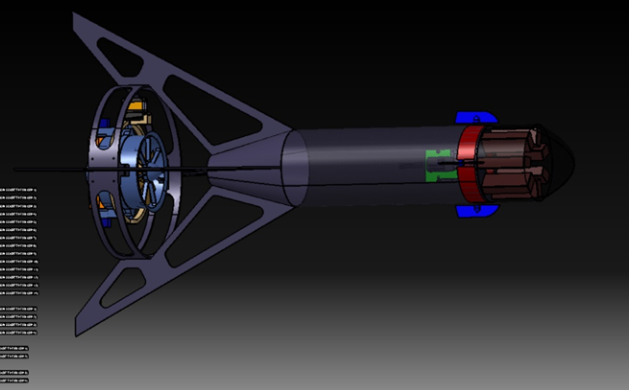
fig/fea/imagenpatas.png
