soypat/proy-final/fig/fea/inercias.png

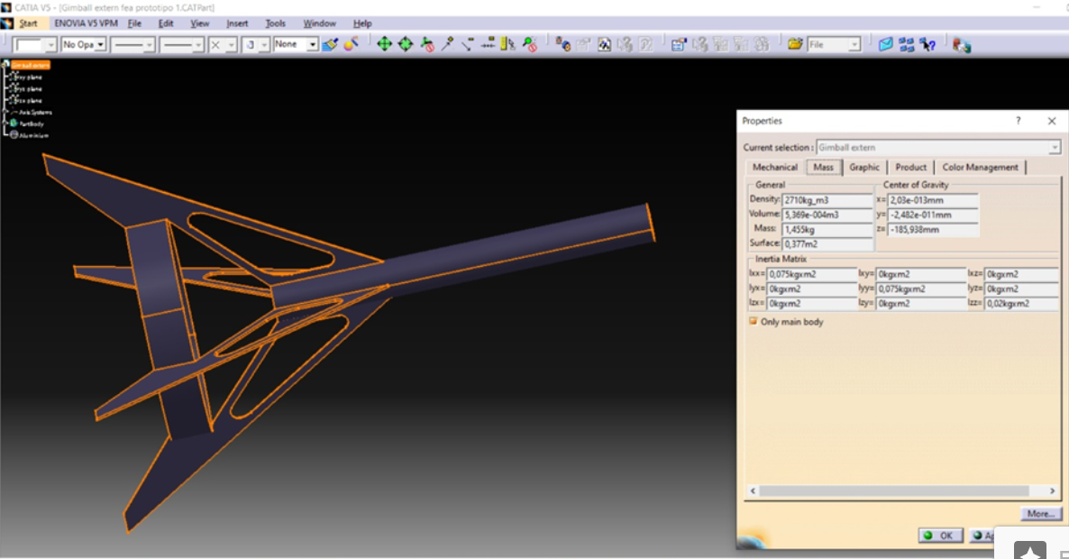
fig/fea/inercias.png
