soypat/proy-final/fig/fea/inerciaspatas.png

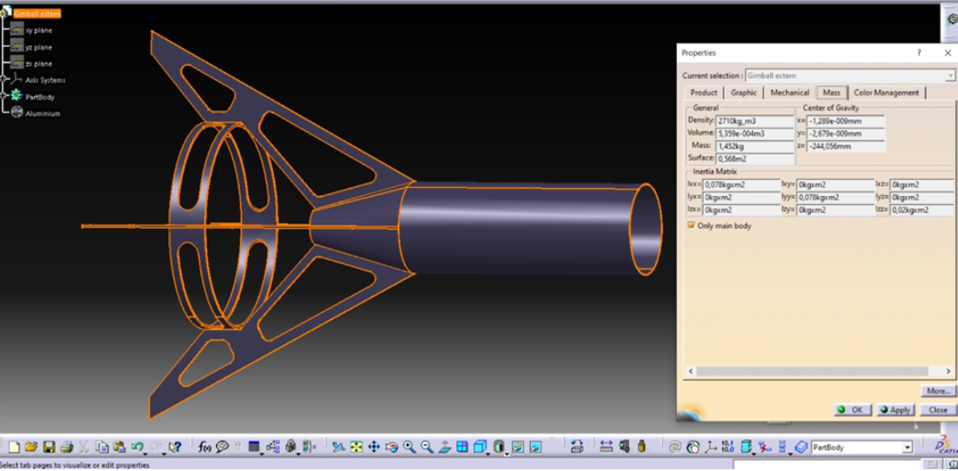
fig/fea/inerciaspatas.png
