soypat/proy-final/fig/fea/jaula2.png

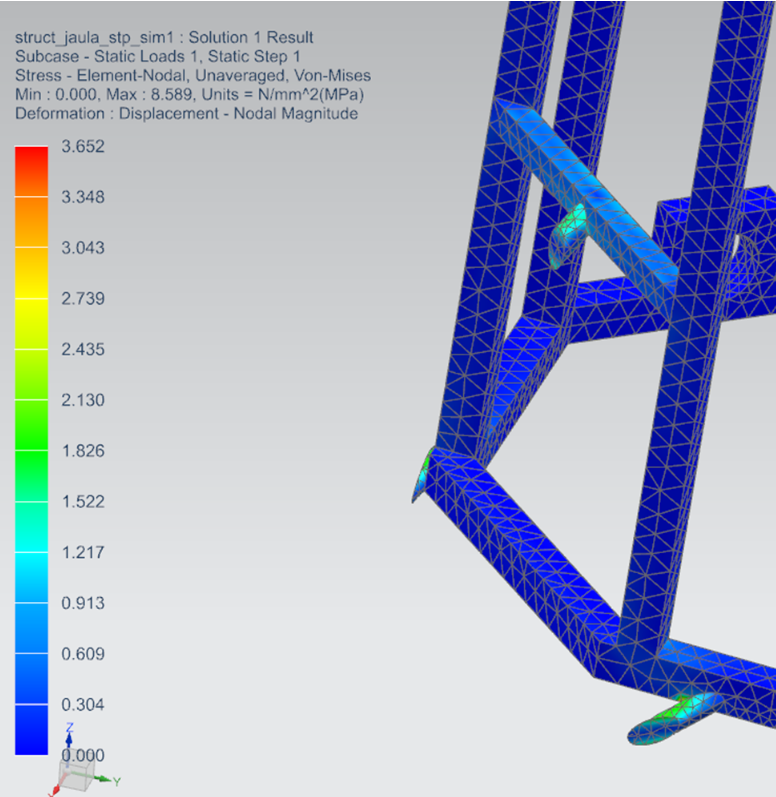
fig/fea/jaula2.png
