soypat/proy-final/fig/fea/jaula.png

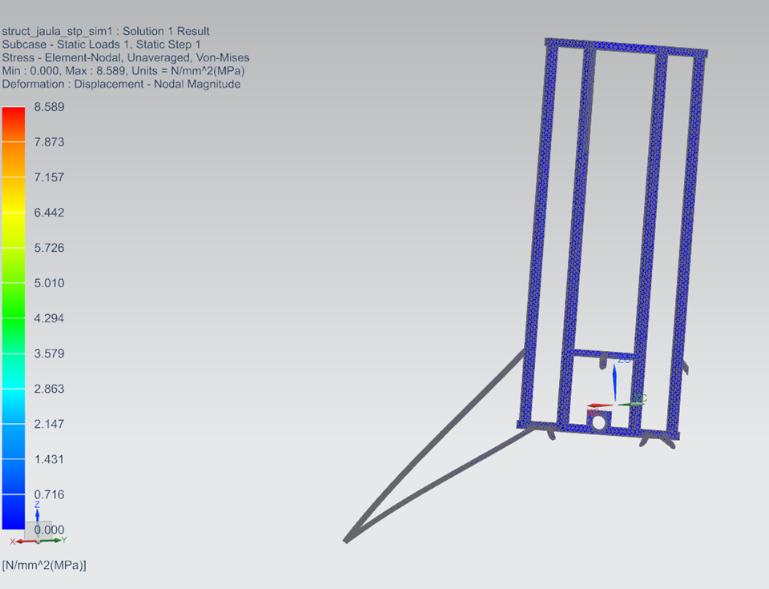
fig/fea/jaula.png
