soypat/proy-final/fig/fea/patas1.png

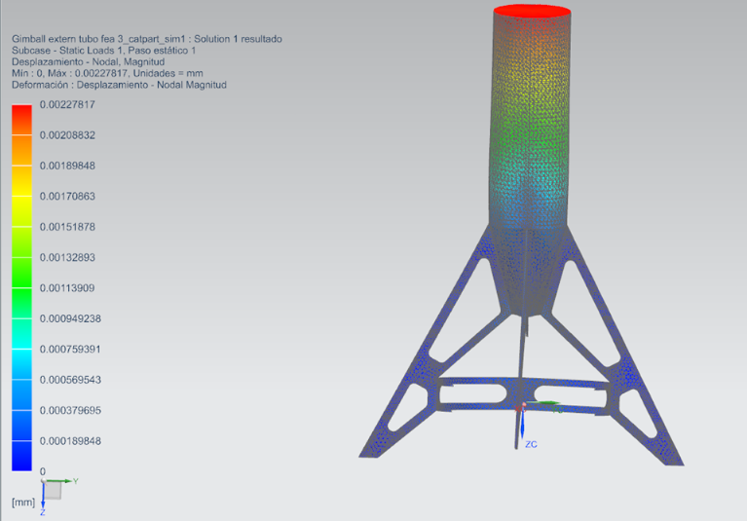
fig/fea/patas1.png
