soypat/proy-final/fig/fea/patas2.png

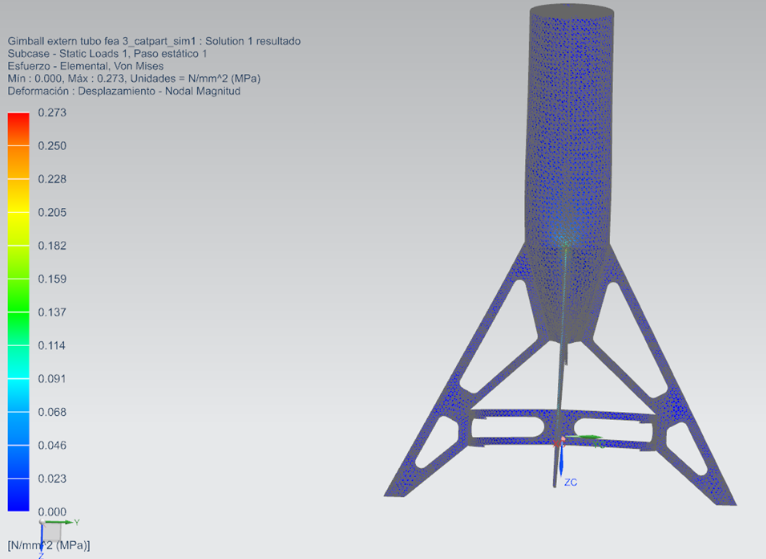
fig/fea/patas2.png
