soypat/proy-final/fig/fea/patas3.png

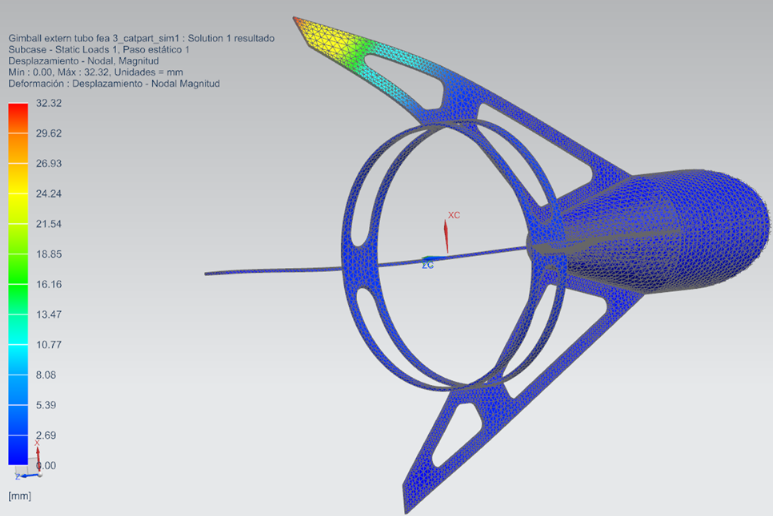
fig/fea/patas3.png
