soypat/proy-final/fig/fea/tuboplaca1.png

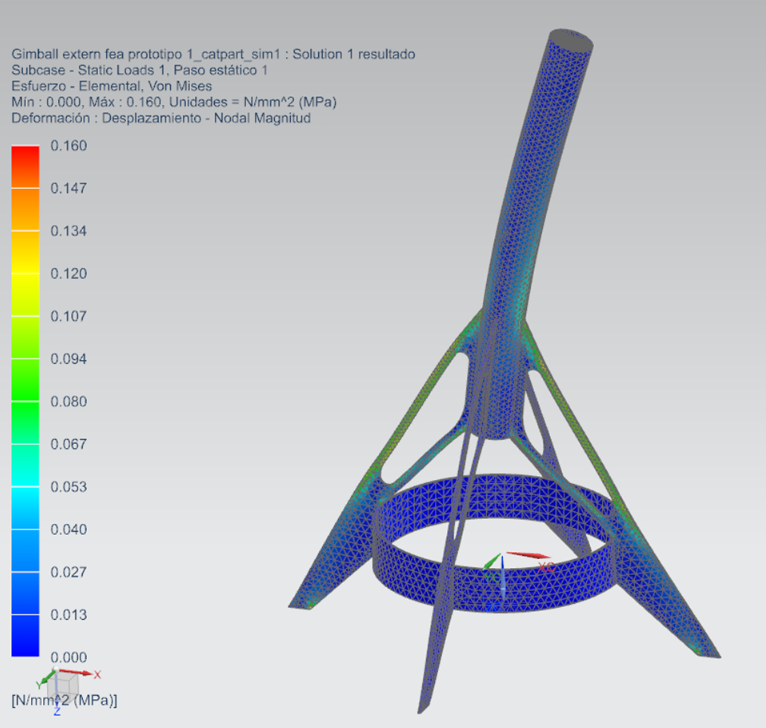
fig/fea/tuboplaca1.png
