soypat/proy-final/fig/fea/tuboplaca2.png

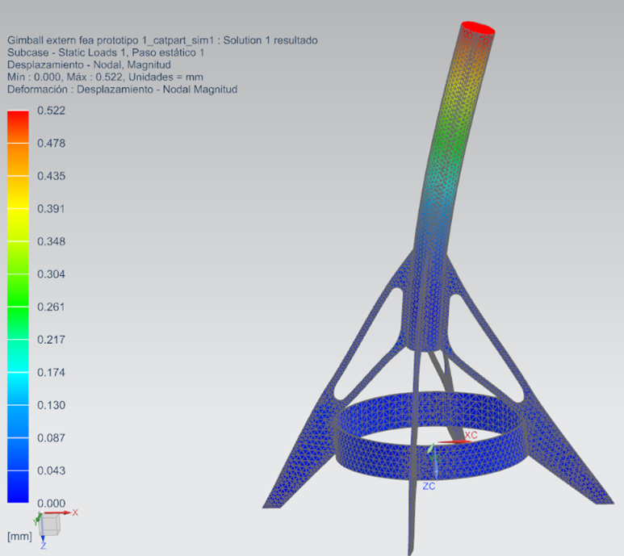
fig/fea/tuboplaca2.png
