soypat/proy-final/fig/fea/tuboplaca3.png

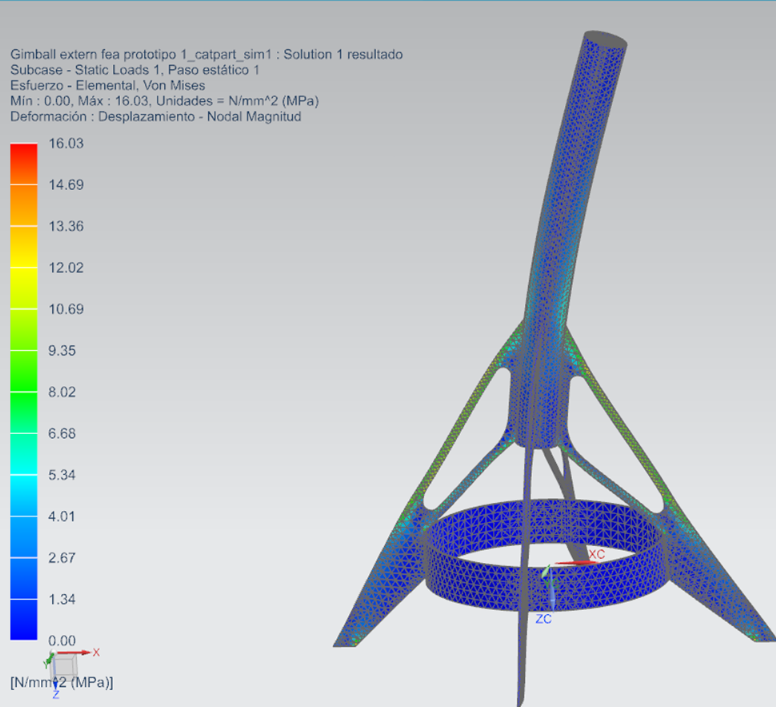
fig/fea/tuboplaca3.png
