soypat/proy-final/fig/fea/tuboplaca4.png

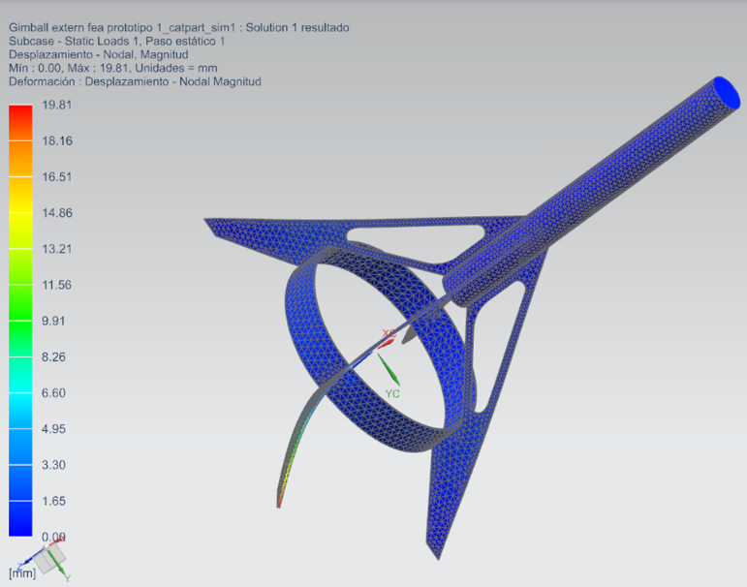
fig/fea/tuboplaca4.png
