soypat/proy-final/fig/fea/tuboplaca5.png

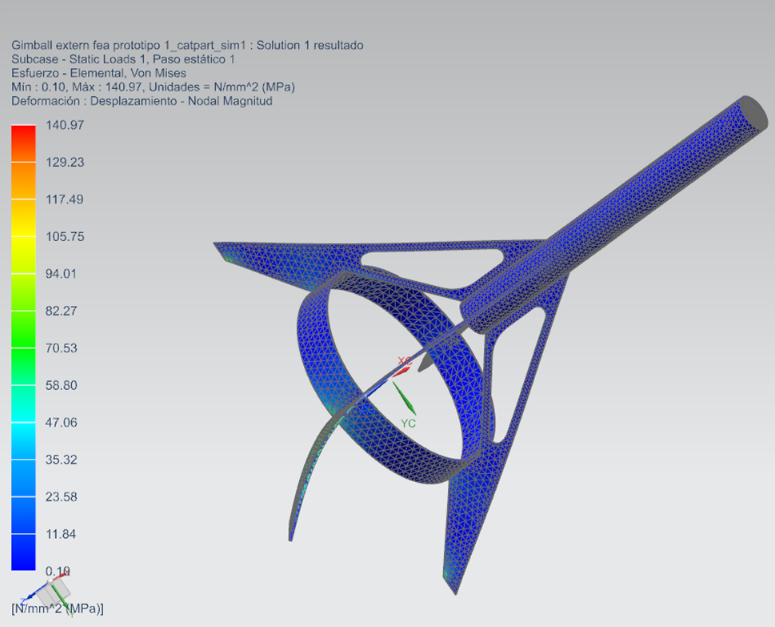
fig/fea/tuboplaca5.png
