soypat/proy-final/fig/frogTArch.png

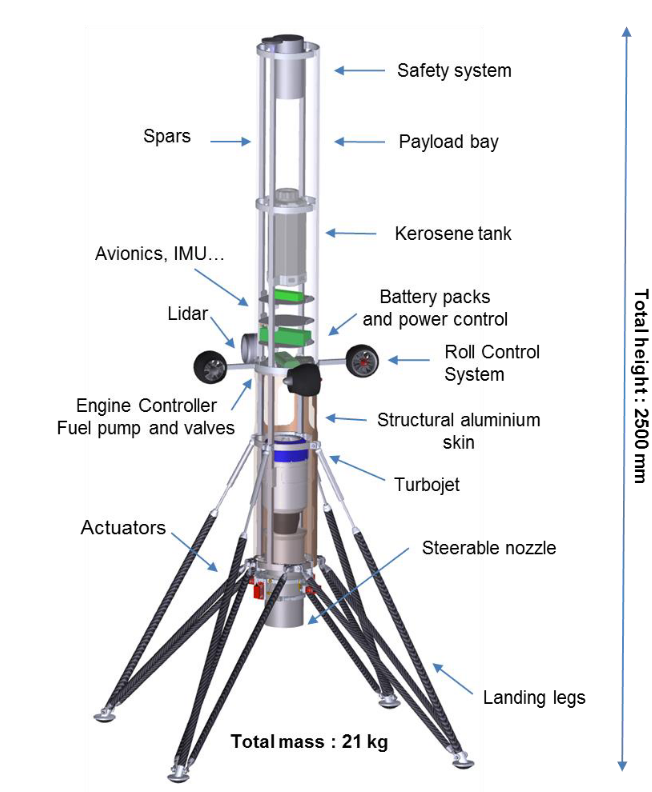
fig/frogTArch.png
