soypat/proy-final/fig/hq/backpcb.jpg

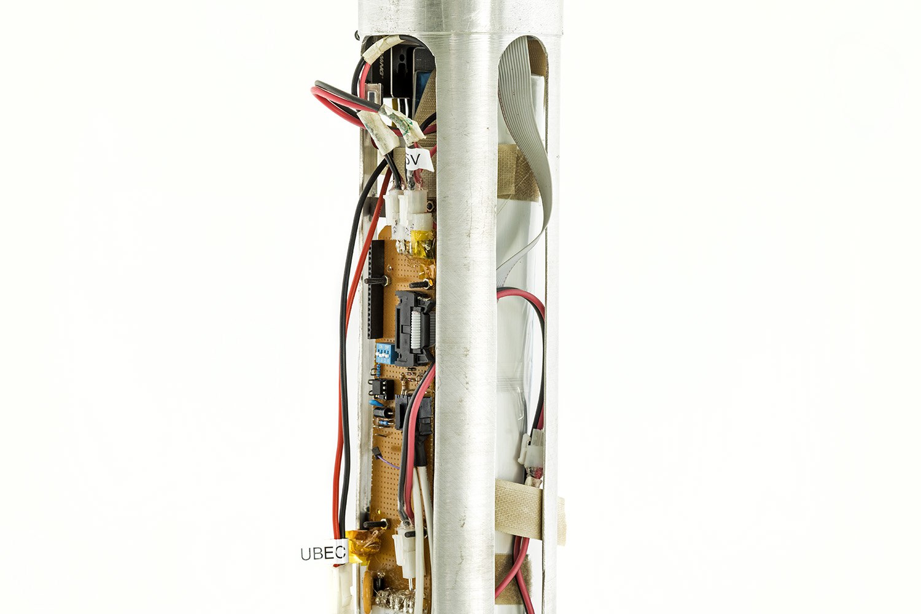
fig/hq/backpcb.jpg
