soypat/proy-final/fig/hq/electronics.jpg

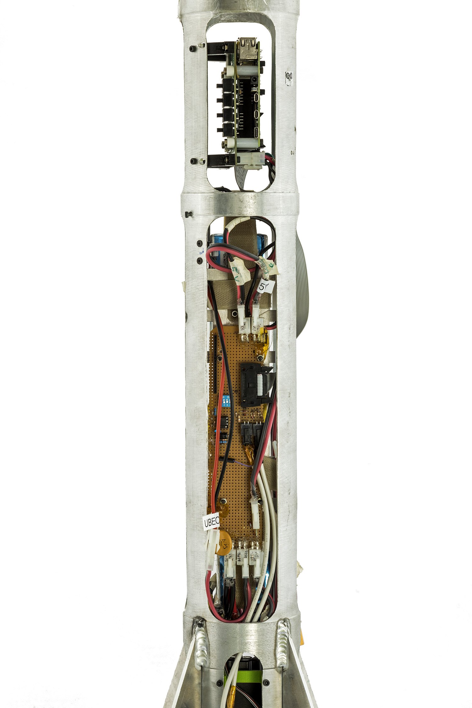
fig/hq/electronics.jpg
