soypat/proy-final/fig/hq/flaps.jpg

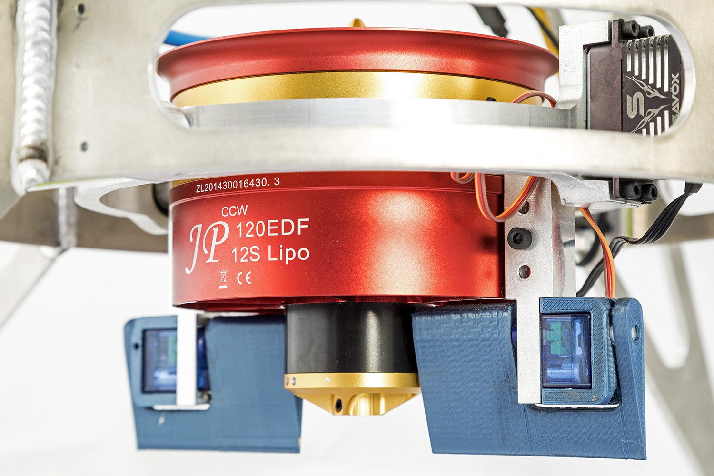
fig/hq/flaps.jpg
