soypat/proy-final/fig/hq/liaboard.jpg

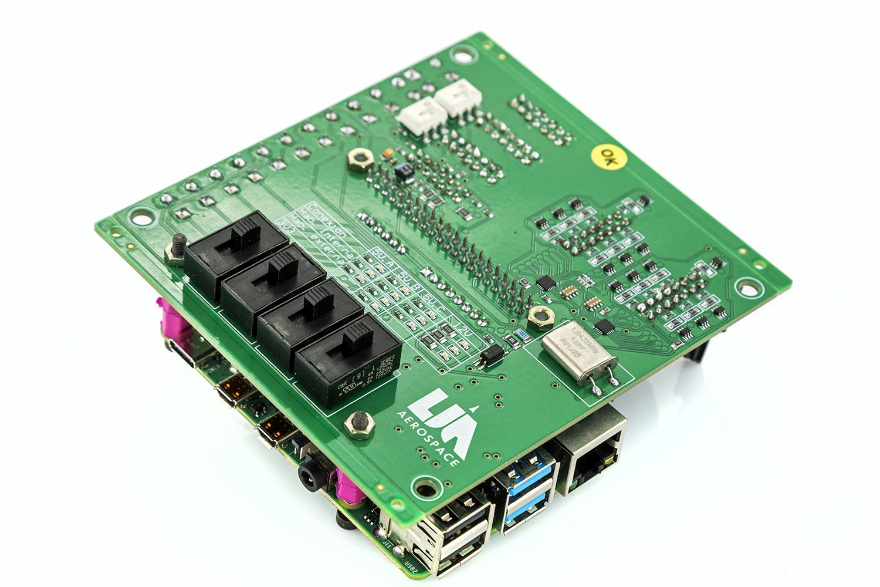
fig/hq/liaboard.jpg
