soypat/proy-final/fig/hq/liaboard_undershot.jpg

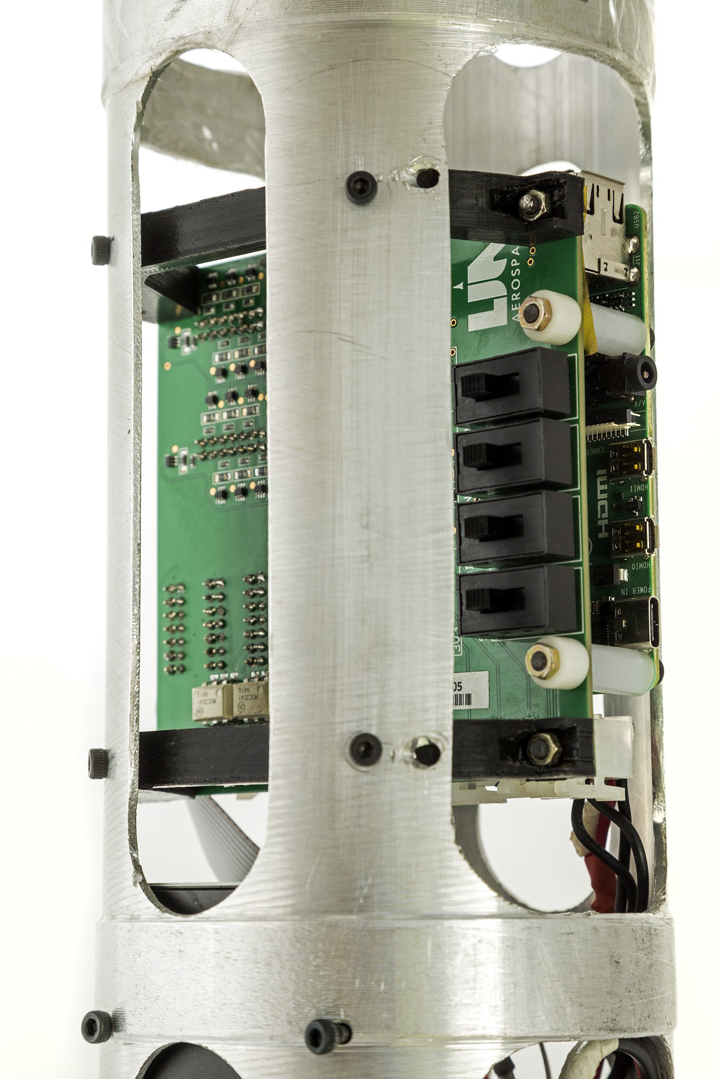
fig/hq/liaboard_undershot.jpg
