soypat/proy-final/fig/hq/lowerhalf.jpg

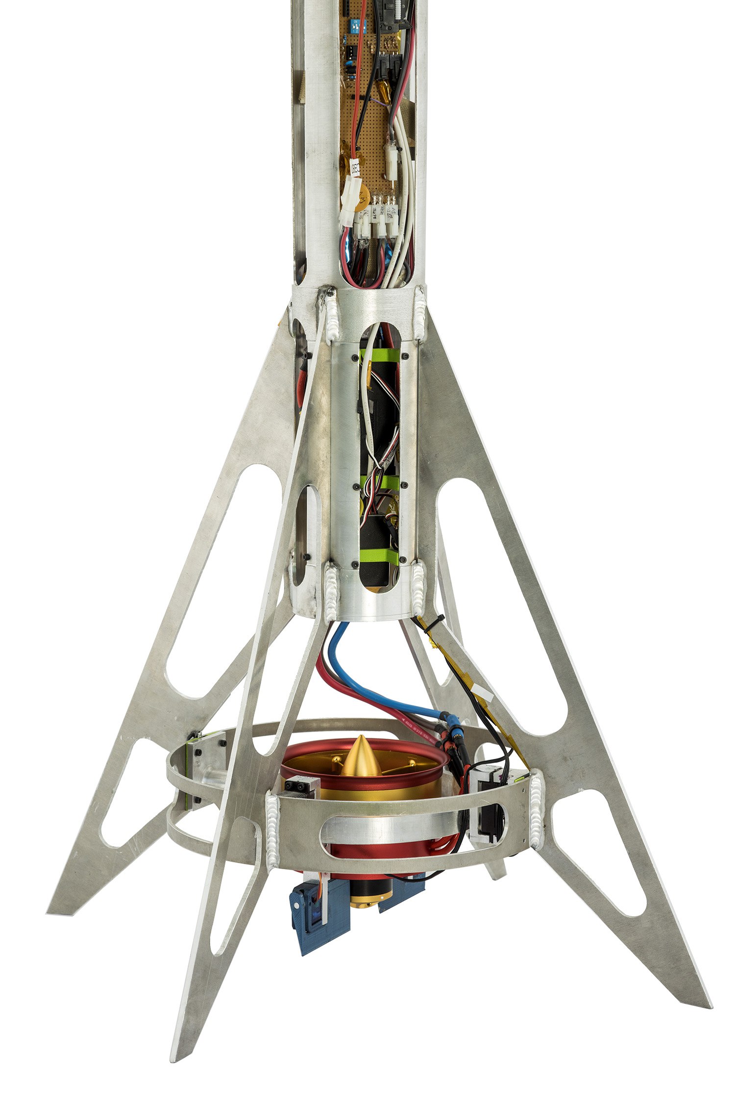
fig/hq/lowerhalf.jpg
