soypat/proy-final/fig/hq/wide_plane.jpg

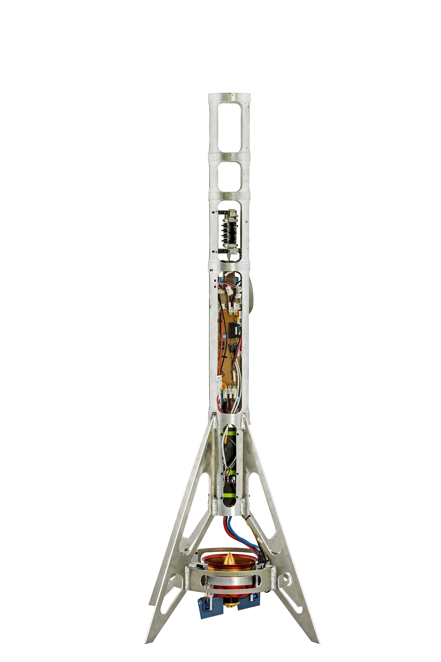
fig/hq/wide_plane.jpg
