soypat/proy-final/fig/hq/wide_plane_bonete.jpg

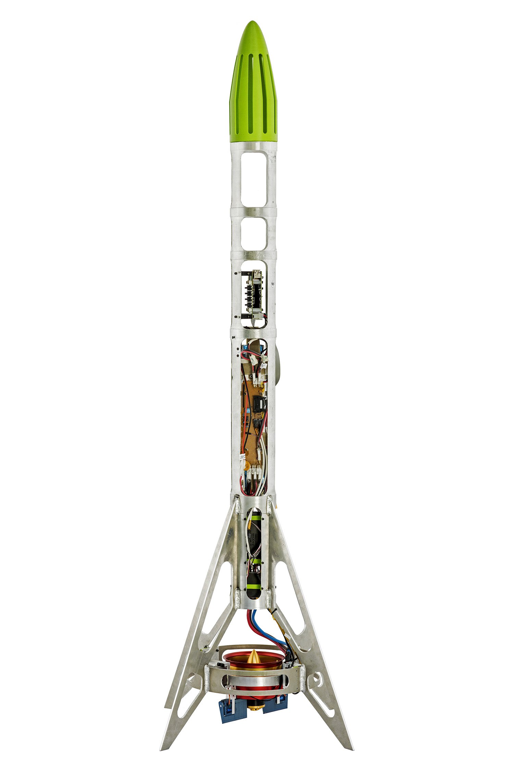
fig/hq/wide_plane_bonete.jpg
