soypat/proy-final/fig/icarus.png

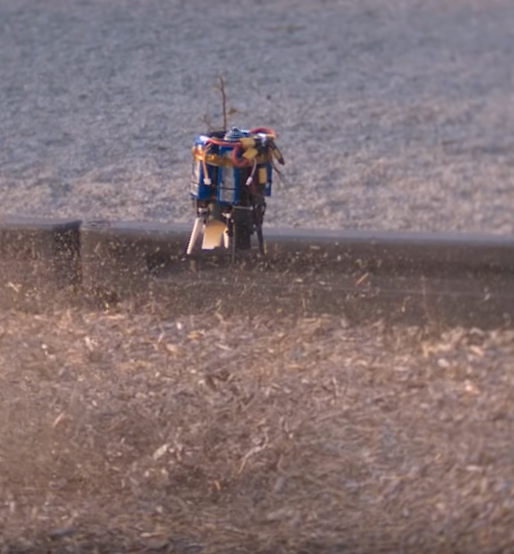
fig/icarus.png
