soypat/proy-final/fig/Planteo Base.jpg

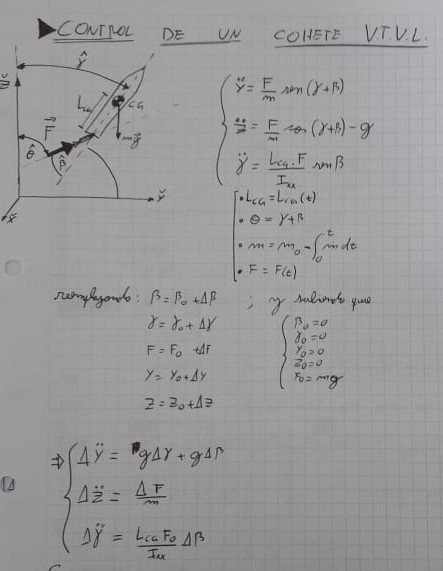
fig/Planteo Base.jpg
