soypat/proy-final/fig/starhip2.png

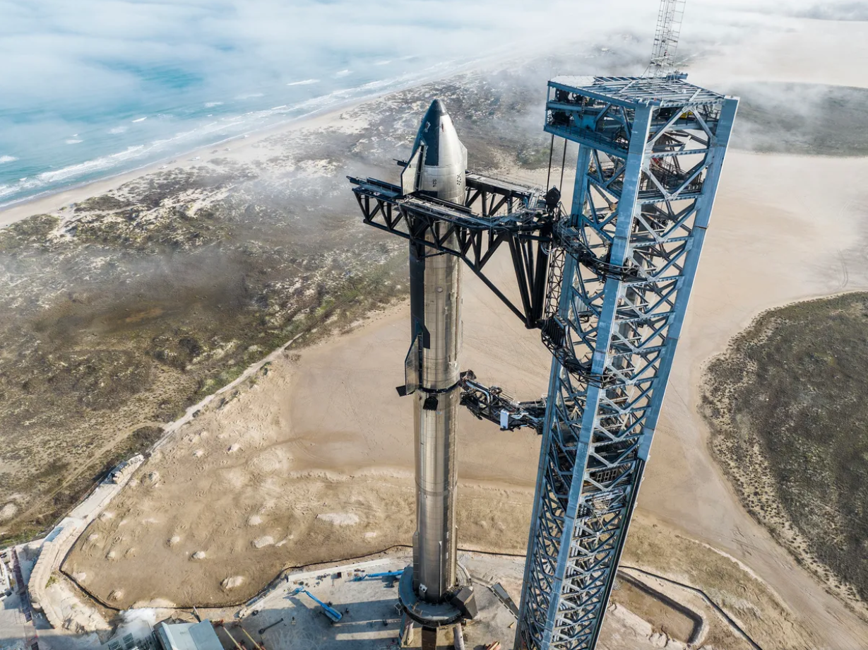
fig/starhip2.png
