soypat/proy-final/fig/vbat.jpg

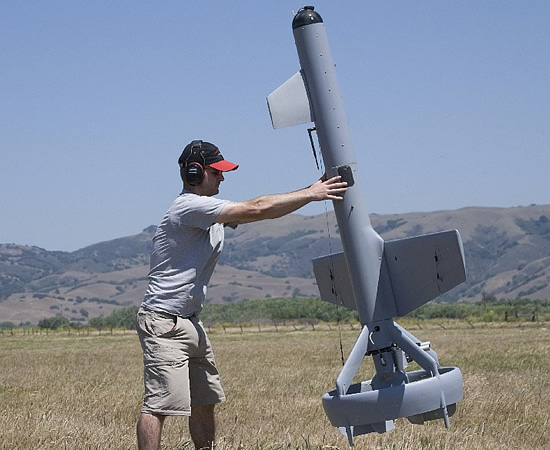
fig/vbat.jpg
