soypat/proy-final/pdf/vtvlpowerboard.pdf

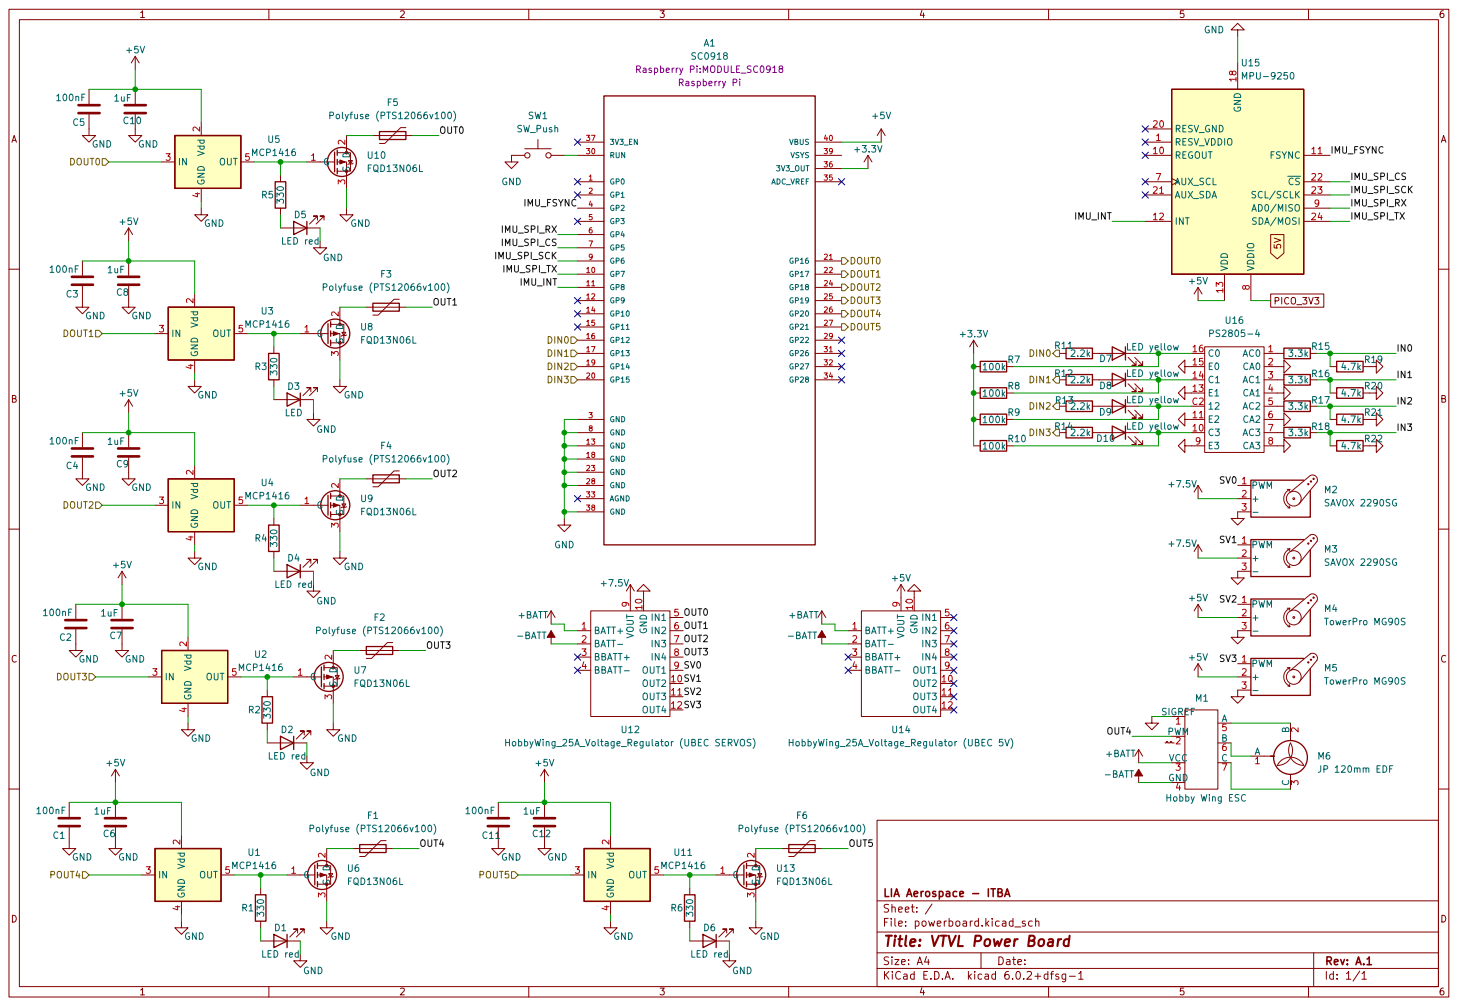
[picture p56: page 1]

9 U12 HobbyWing_25A_Voltage_Regulator (UBEC SERVOS) +5V GND GND

File: powerboard.kicad_sch Sheet: / LIA Aerospace - ITBA

Id: 1/1 Title: VTVL Power Board
