soypat/proy-final/pdf/cad/ALUM-06-01.pdf

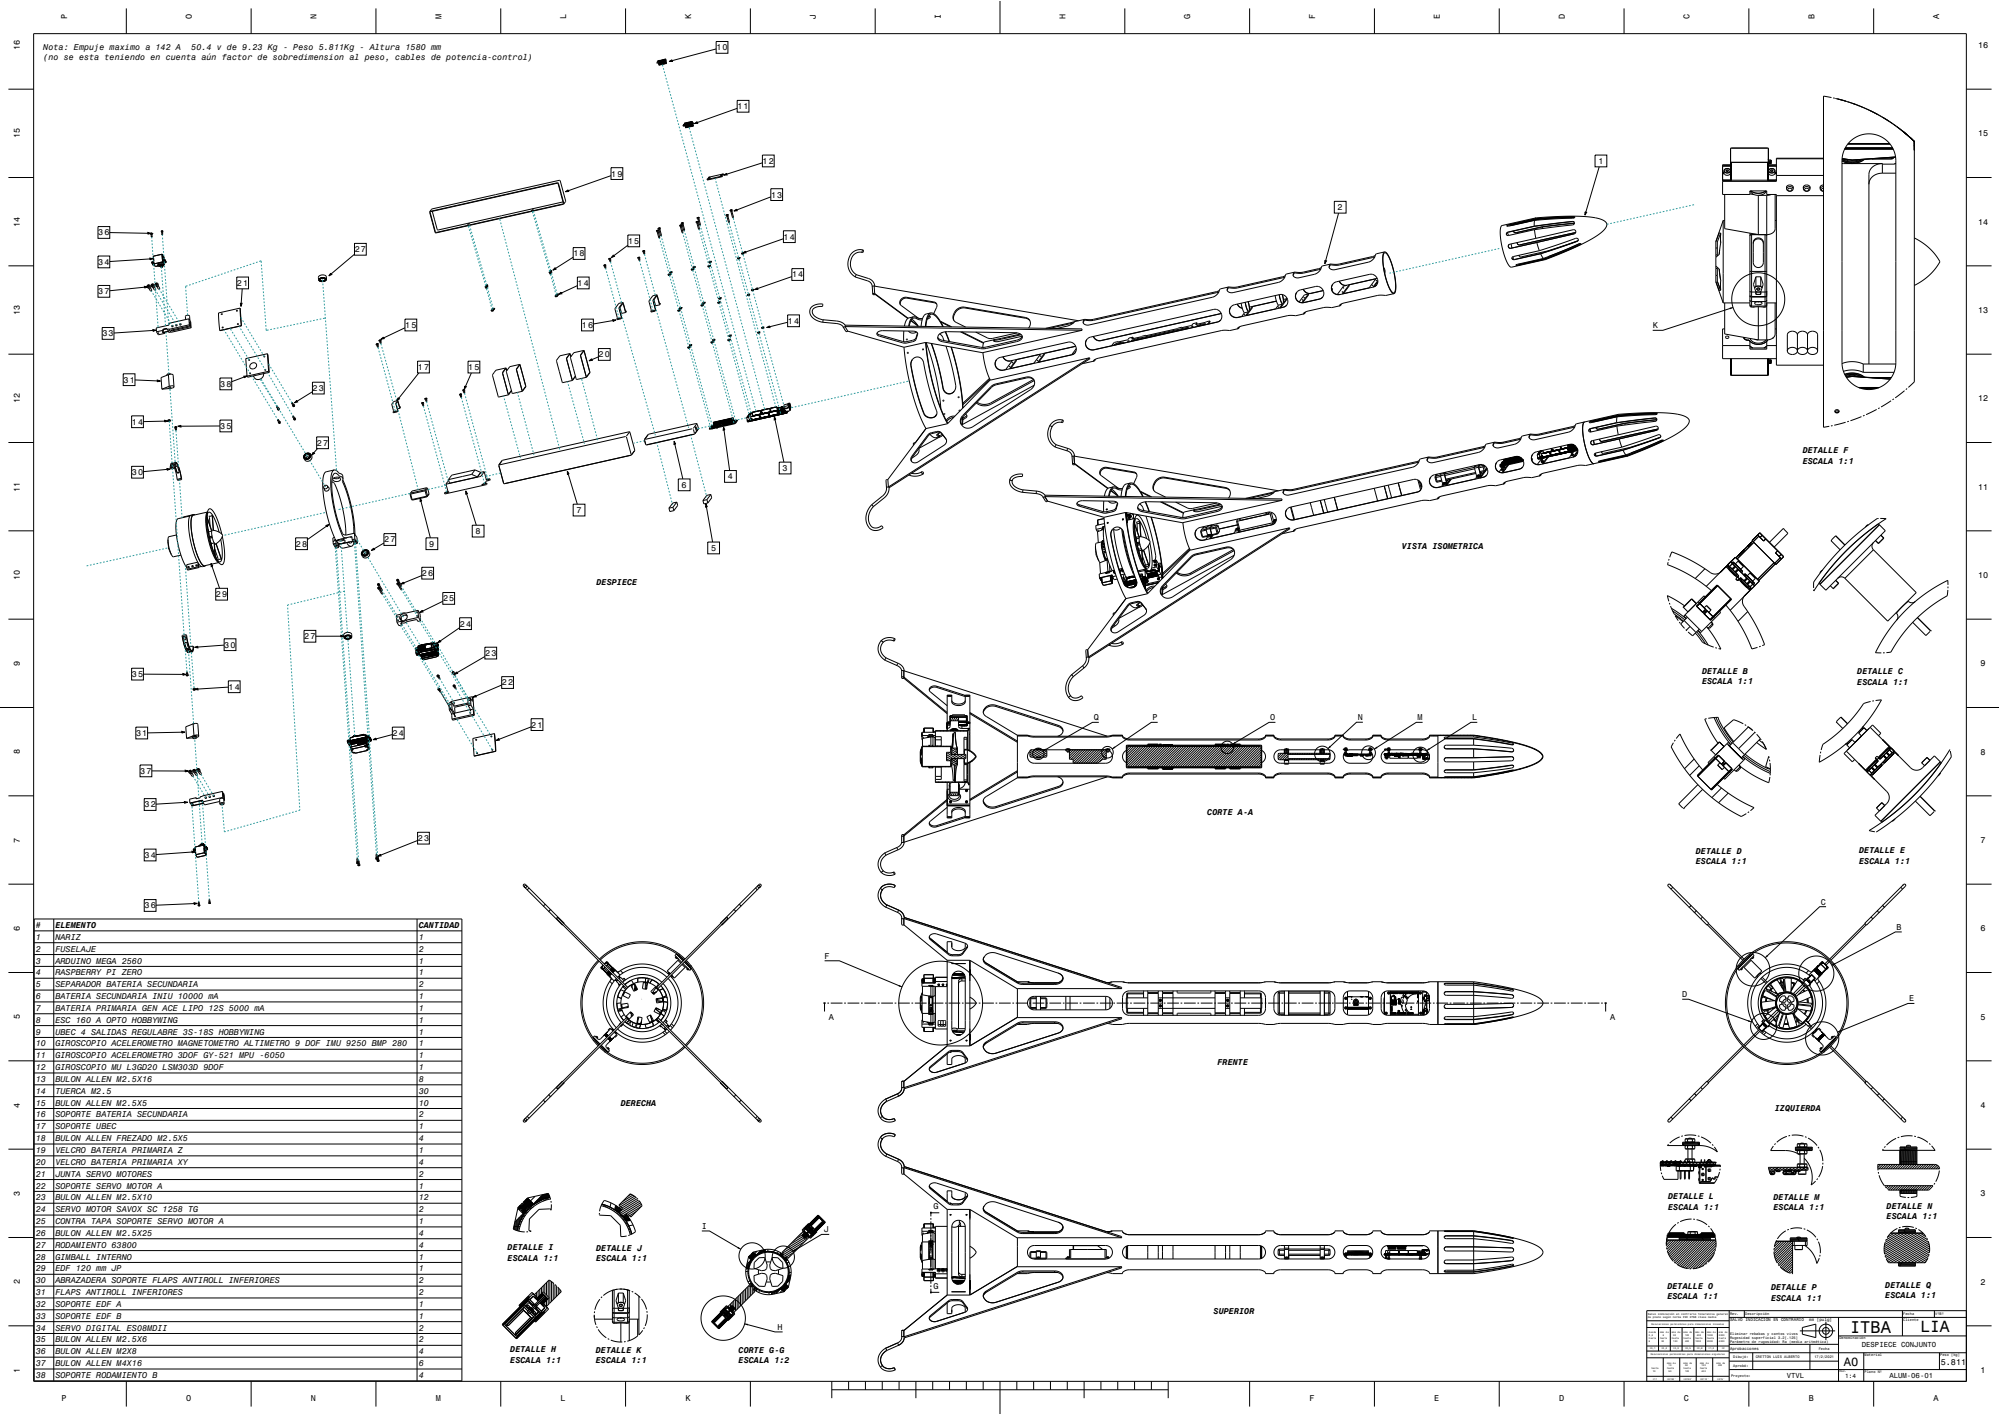
[picture p57: page 1]
Peso [kg]; Plano Nº; más de; DESPIECE CONJUNTO; VISTA ISOMETRICA; ARDUINO MEGA 2560; RASPBERRY PI ZERO; SEPARADOR BATERIA SECUNDARIA; BATERIA SECUNDARIA INIU 10000 mA; BATERIA PRIMARIA GEN ACE LIPO 12S 5000 mA; ESC 160 A OPTO HOBBYWING; UBEC 4 SALIDAS REGULABRE 3S-18S HOBBYWING; 11 GIROSCOPIO ACELEROMETRO 3DOF GY-521 MPU -6050; 12 GIROSCOPIO MU L3GD20 LSM303D 9DOF; 13 BULON ALLEN M2.5X16; 14 TUERCA M2.5; 15 BULON ALLEN M2.5X5; 16 SOPORTE BATERIA SECUNDARIA; 17 SOPORTE UBEC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

Nota: Empuje maximo a 142 A 50.4 v de 9.23 Kg - Peso 5.811Kg - Altura 1580 mm
(no se esta teniendo en cuenta aún factor de sobredimension al peso, cables de potencia-control)

10 GIROSCOPIO ACELEROMETRO MAGNETOMETRO ALTIMETRO 9 DOF IMU 9250 BMP 280 1

Salvo indicación en contrario tolerancia general
de plano según norma ISO 2768 clase media

Rev.
SALVO INDICACIÓN EN CONTRARIO mm [pulg]

Desviaciones permisibles para dimensiones lineales

más de
Eliminar rebabas y cantos vivos
Rugosidad superficial 3.2[.125]
Parámetro de rugosidad: Ra (media aritmética)
Aprobaciones

Desviaciones permisibles para dimensiones angulares

CRETTON LUIS ALBERTO
