soypat/proy-final/pdf/cad/ALUM-06-04.pdf

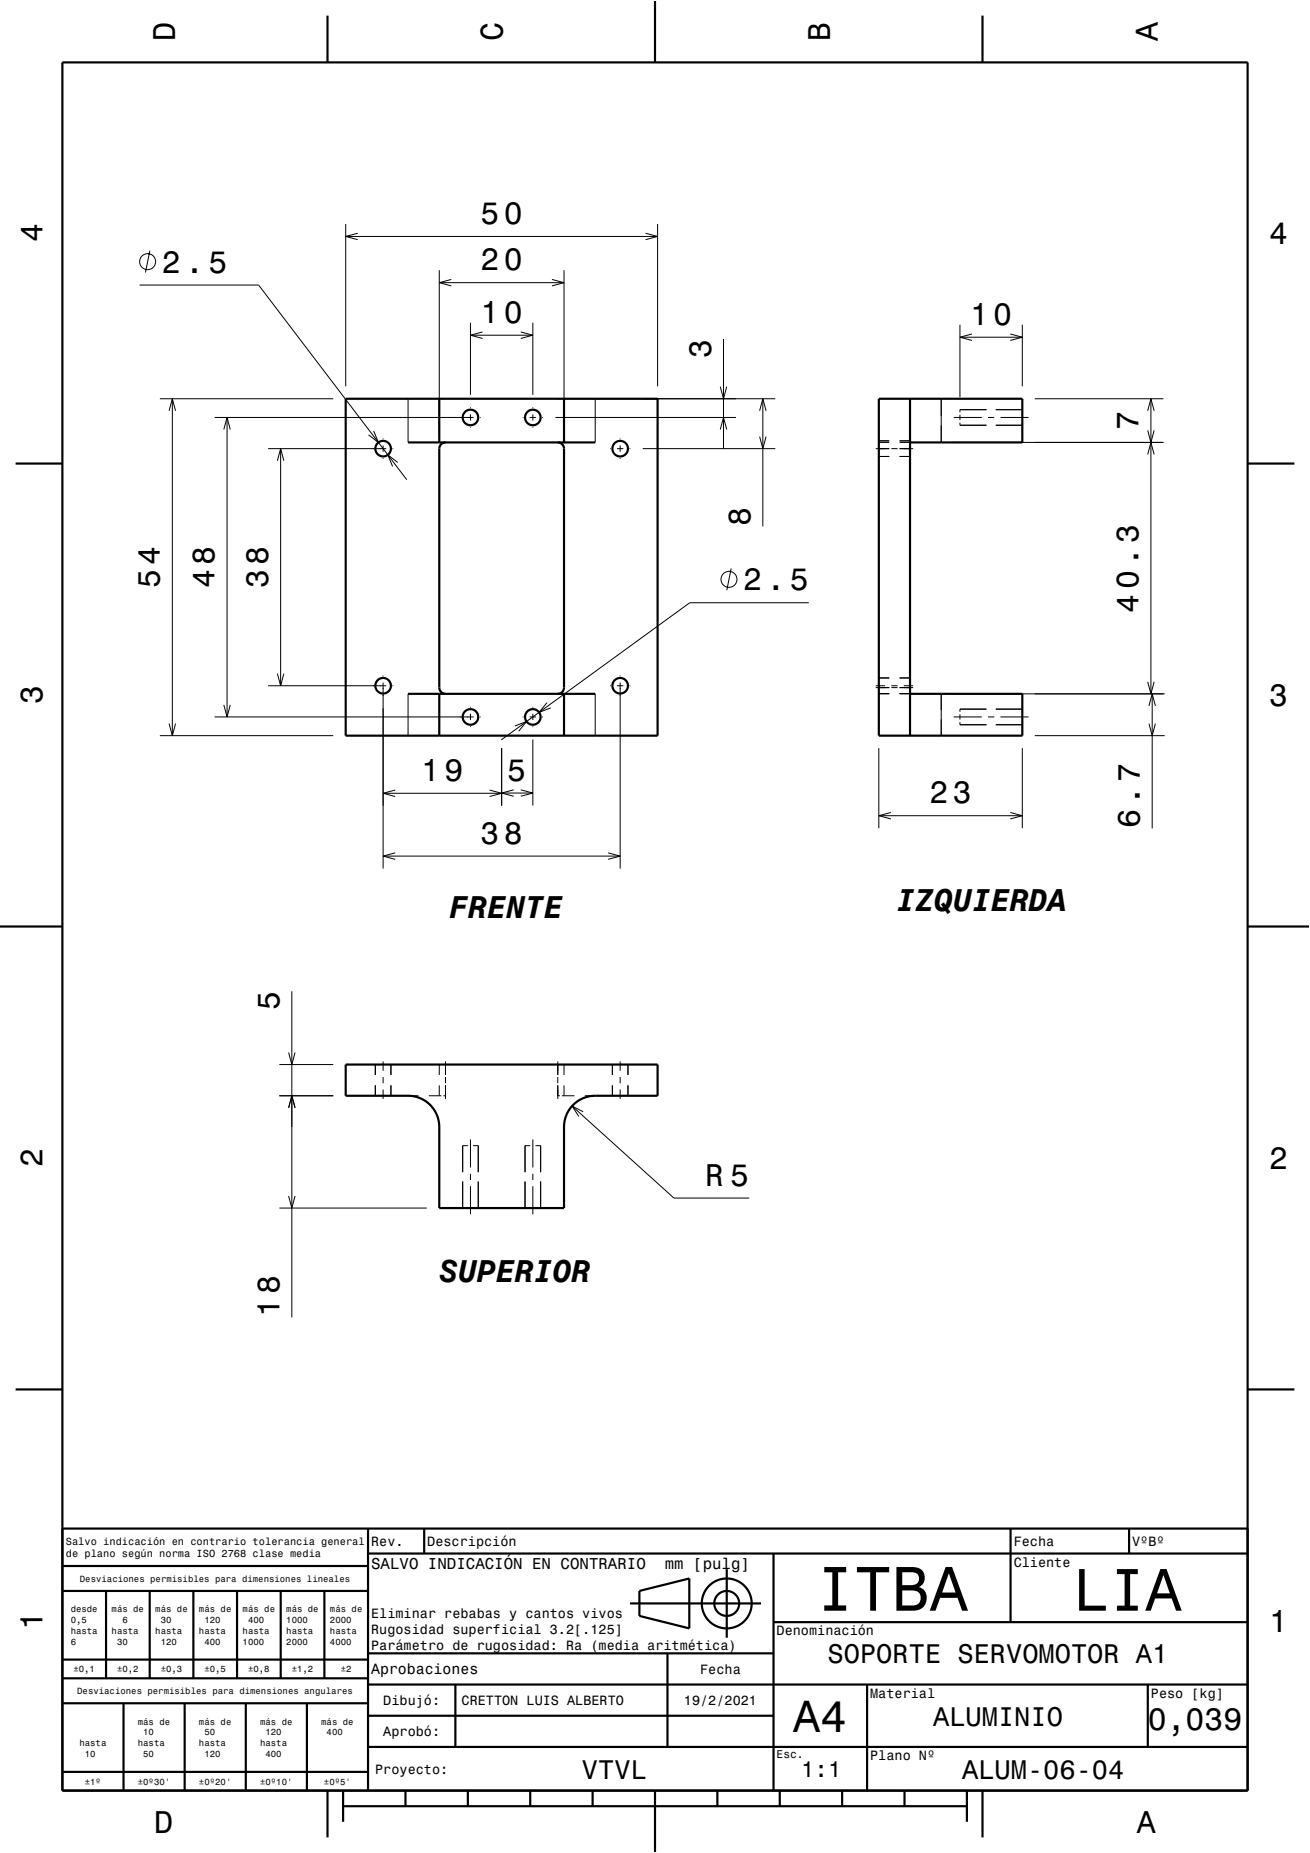
[picture p58: page 1]
SOPORTE SERVOMOTOR A1

Salvo indicación en contrario tolerancia general de plano según norma ISO 2768 clase media | Rev. | Descripción | Fecha | VºBº

SALVO INDICACIÓN EN CONTRARIO mm [pulg] Parámetro de rugosidad: Ra (media aritmética) | | | ITBA | Cliente LIA

Desviaciones permisibles para dimensiones lineales

desde 0,5 hasta 6 | más de 6 hasta 30 | más de 30 hasta 120 | más de 120 hasta 400 | más de 400 hasta 1000 | más de 1000 hasta 2000 | más de 2000 hasta 4000

Eliminar rebabas y cantos vivos
Rugosidad superficial 3.2[.125]

±0,1 | ±0,2 | ±0,3 | ±0,5 | ±0,8 | ±1,2 | ±2
Desviaciones permisibles para dimensiones angulares | Dibujó: | CRETTON LUIS ALBERTO | 19/2/2021 | A4 | Material ALUMINIO | Peso [kg] 0,039

Aprobaciones | Fecha

hasta 10 | más de 10 hasta 50 | más de 50 hasta 120 | más de 120 hasta 400 | más de 400

Aprobó:
VTVL Proyecto: | Esc. 1:1 | Plano Nº ALUM-06-04
