soypat/proy-final/pdf/cad/Vista explotada 1.0.pdf

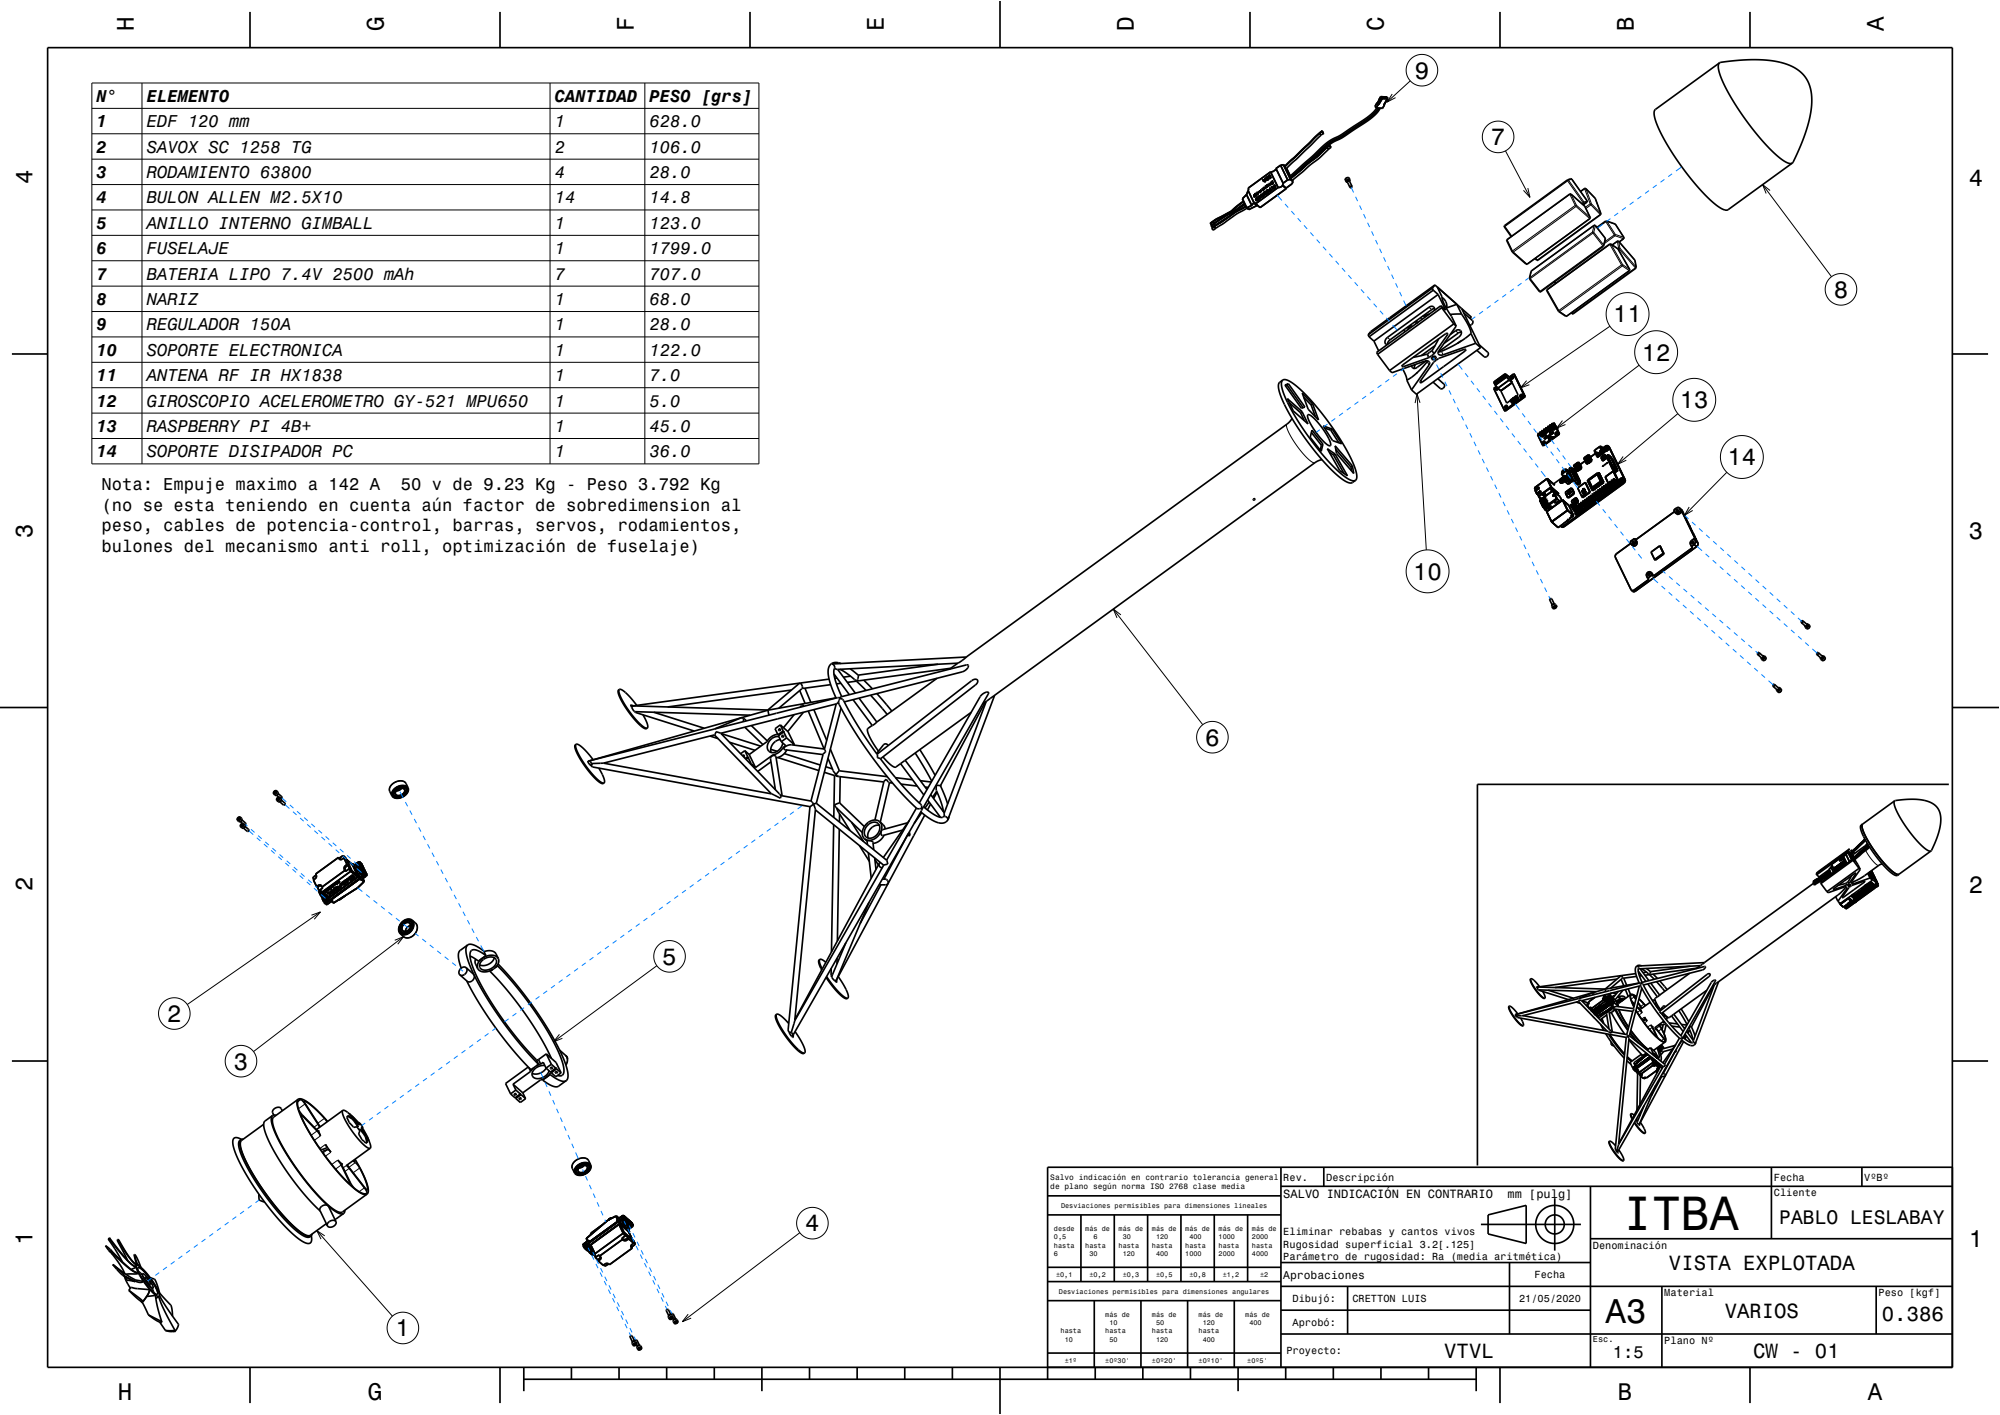
[picture p59: page 1]
Peso [kgf]; Plano Nº; CRETTON LUIS; más de; VISTA EXPLOTADA; PABLO LESLABAY; ELEMENTO; CANTIDAD PESO [grs]; EDF 120 mm; SAVOX SC 1258 TG; RODAMIENTO 63800; BULON ALLEN M2.5X10; ANILLO INTERNO GIMBALL; BATERIA LIPO 7.4V 2500 mAh; REGULADOR 150A; SOPORTE ELECTRONICA; ANTENA RF IR HX1838; GIROSCOPIO ACELEROMETRO GY-521 MPU650; RASPBERRY PI 4B+; SOPORTE DISIPADOR PC

Nota: Empuje maximo a 142 A 50 v de 9.23 Kg - Peso 3.792 Kg
(no se esta teniendo en cuenta aún factor de sobredimension al
peso, cables de potencia-control, barras, servos, rodamientos,
bulones del mecanismo anti roll, optimización de fuselaje)

Salvo indicación en contrario tolerancia general
de plano según norma ISO 2768 clase media

Rev.
SALVO INDICACIÓN EN CONTRARIO mm [pulg]

Desviaciones permisibles para dimensiones lineales

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

Desviaciones permisibles para dimensiones angulares
