soypat/proy-final/pdf/cad/Vista explotada.pdf

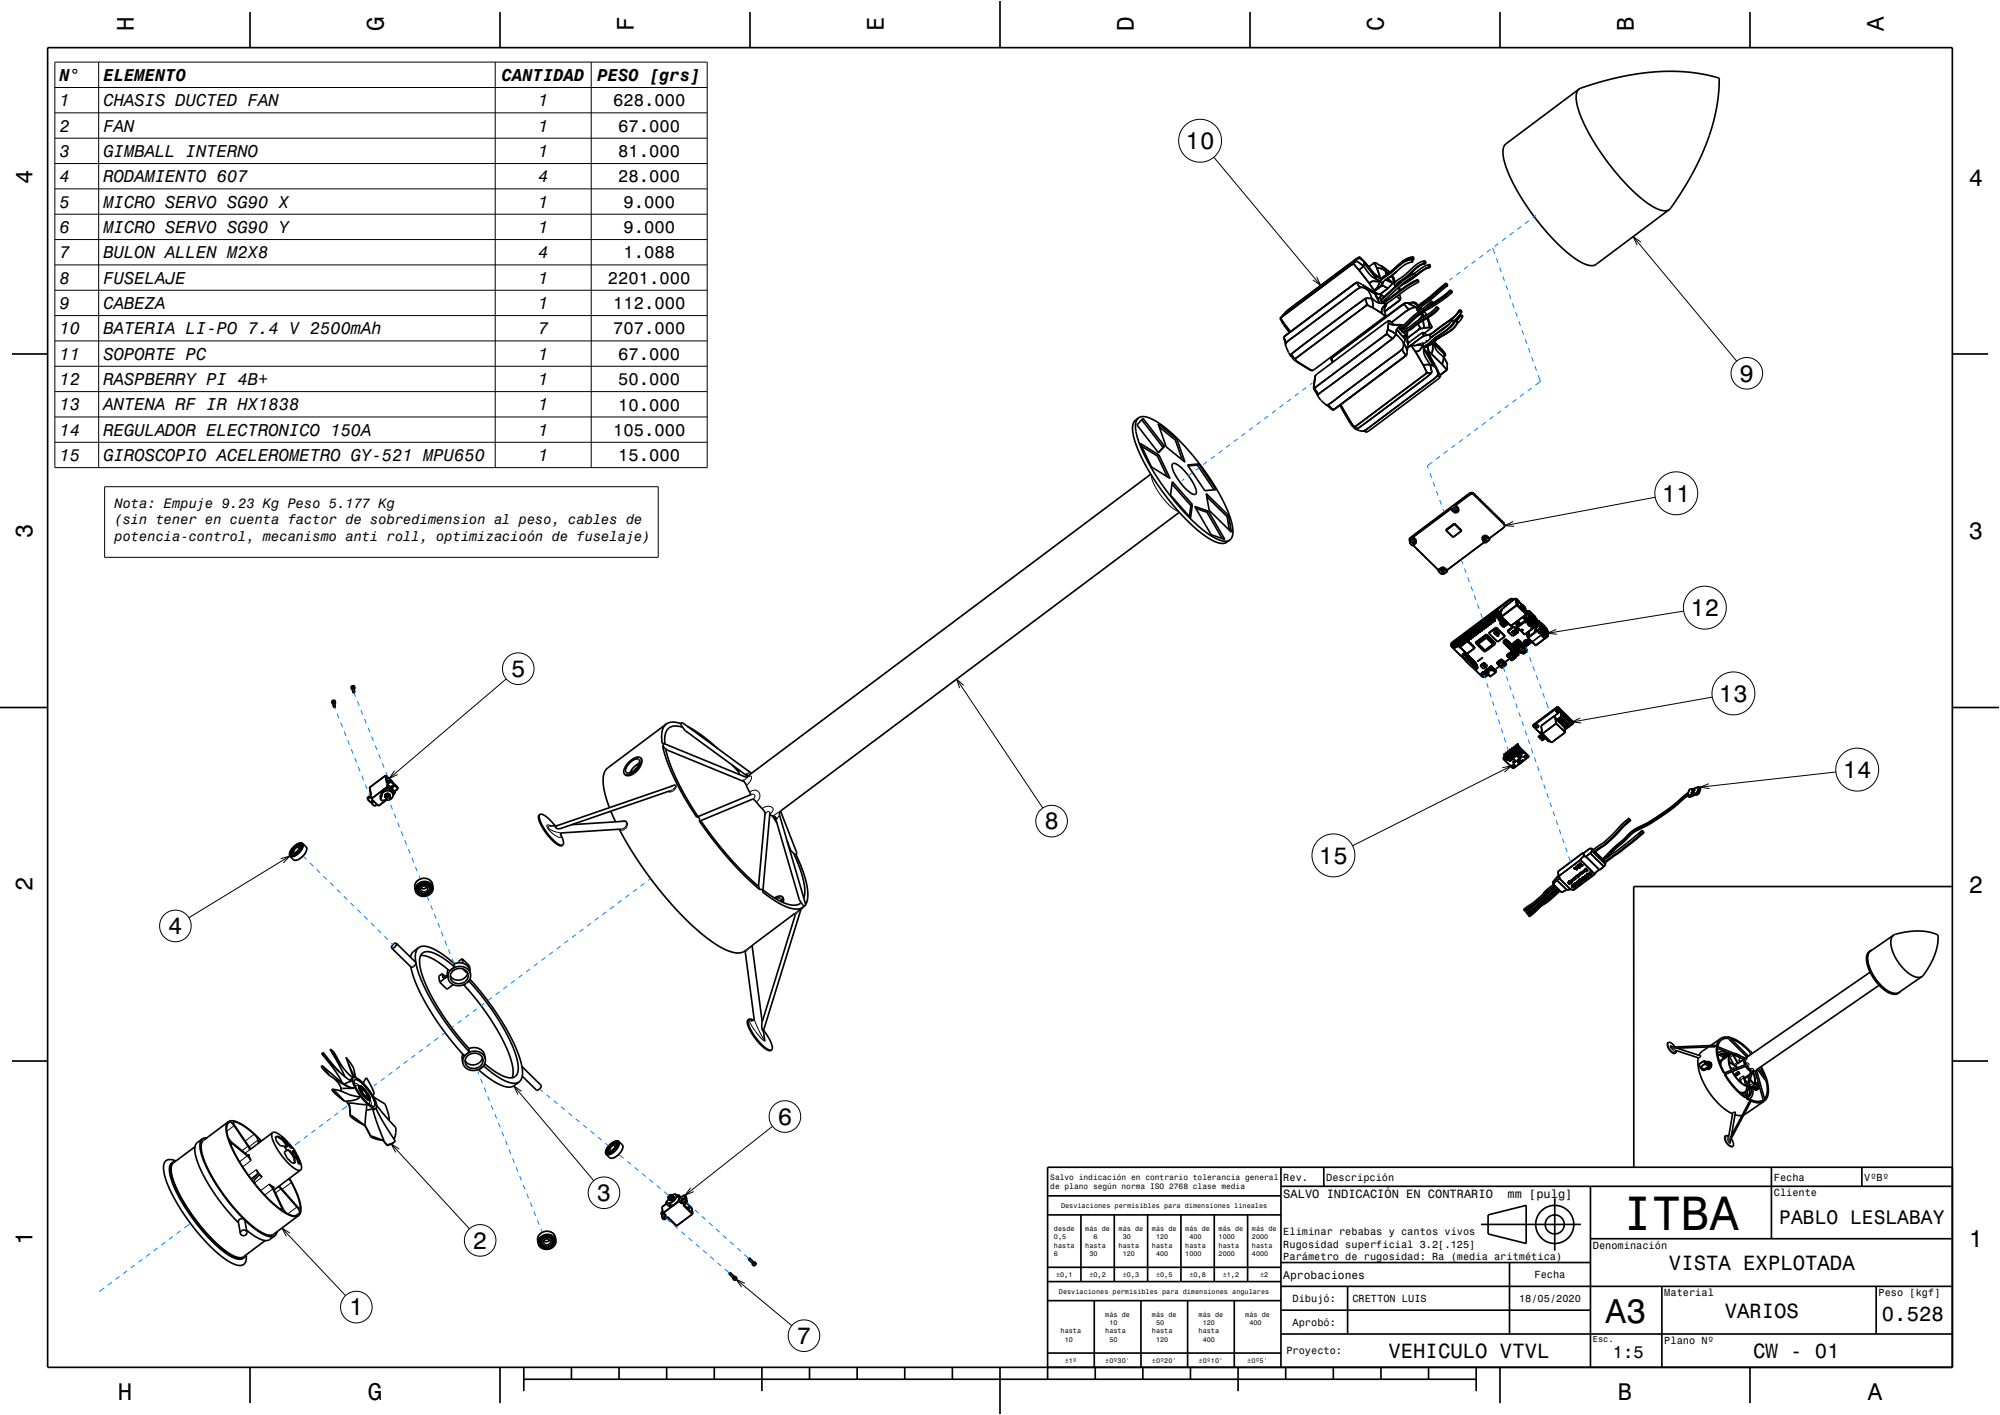
[picture p60: page 1]
Peso [kgf]; Plano Nº; CRETTON LUIS; más de; VEHICULO VTVL; VISTA EXPLOTADA; PABLO LESLABAY; N° ELEMENTO; CANTIDAD PESO [grs]; CHASIS DUCTED FAN; GIMBALL INTERNO; RODAMIENTO 607; MICRO SERVO SG90 X; MICRO SERVO SG90 Y; BULON ALLEN M2X8; 10 BATERIA LI-PO 7.4 V 2500mAh; 11 SOPORTE PC; 12 RASPBERRY PI 4B+; 13 ANTENA RF IR HX1838; 14 REGULADOR ELECTRONICO 150A; 15 GIROSCOPIO ACELEROMETRO GY-521 MPU650

Nota: Empuje 9.23 Kg Peso 5.177 Kg
(sin tener en cuenta factor de sobredimension al peso, cables de
potencia-control, mecanismo anti roll, optimizacioón de fuselaje)

Salvo indicación en contrario tolerancia general
de plano según norma ISO 2768 clase media

Rev.
SALVO INDICACIÓN EN CONTRARIO mm [pulg]

Desviaciones permisibles para dimensiones lineales

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

Desviaciones permisibles para dimensiones angulares
