soypat/proy-final/pdf/cad/Vista explotada 5.pdf

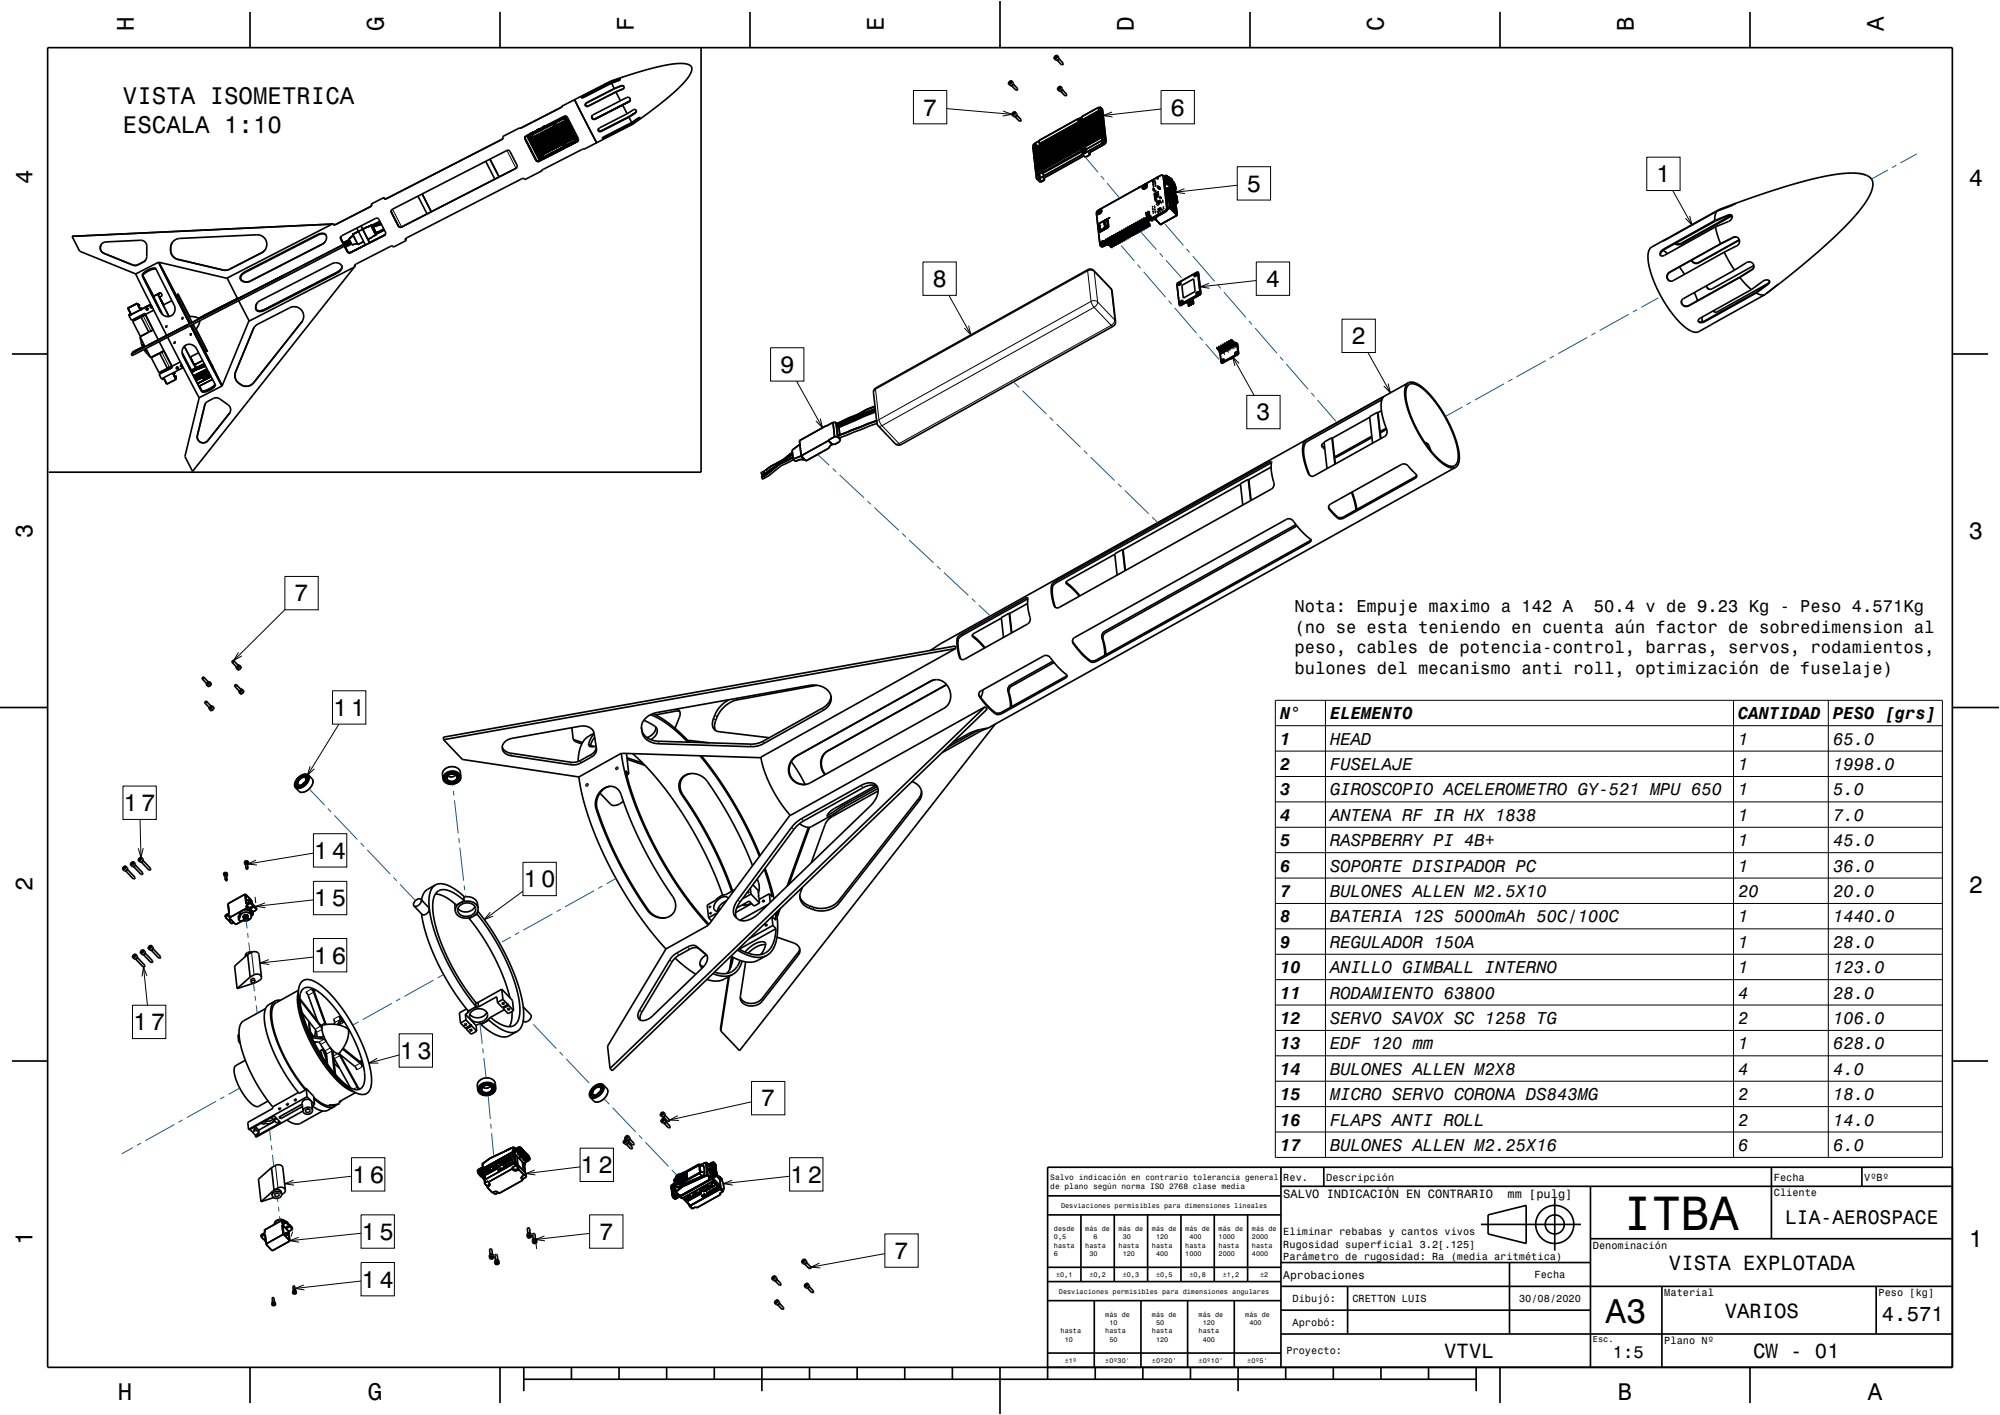
[picture p61: page 1]
Peso [kg]; Plano Nº; CRETTON LUIS; más de; VISTA EXPLOTADA; VISTA ISOMETRICA ESCALA 1:10; ELEMENTO; CANTIDAD PESO [grs]; GIROSCOPIO ACELEROMETRO GY-521 MPU 650 1; ANTENA RF IR HX 1838; RASPBERRY PI 4B+; SOPORTE DISIPADOR PC; BULONES ALLEN M2.5X10; BATERIA 12S 5000mAh 50C/100C; REGULADOR 150A; ANILLO GIMBALL INTERNO; RODAMIENTO 63800; SERVO SAVOX SC 1258 TG; EDF 120 mm; BULONES ALLEN M2X8; MICRO SERVO CORONA DS843MG; FLAPS ANTI ROLL; BULONES ALLEN M2.25X16

Nota: Empuje maximo a 142 A 50.4 v de 9.23 Kg - Peso 4.571Kg
(no se esta teniendo en cuenta aún factor de sobredimension al
peso, cables de potencia-control, barras, servos, rodamientos,
bulones del mecanismo anti roll, optimización de fuselaje)

Salvo indicación en contrario tolerancia general
de plano según norma ISO 2768 clase media

Rev.
SALVO INDICACIÓN EN CONTRARIO mm [pulg]

Desviaciones permisibles para dimensiones lineales

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

Desviaciones permisibles para dimensiones angulares
