soypat/proy-final/pdf/OverviewSystem.pdf

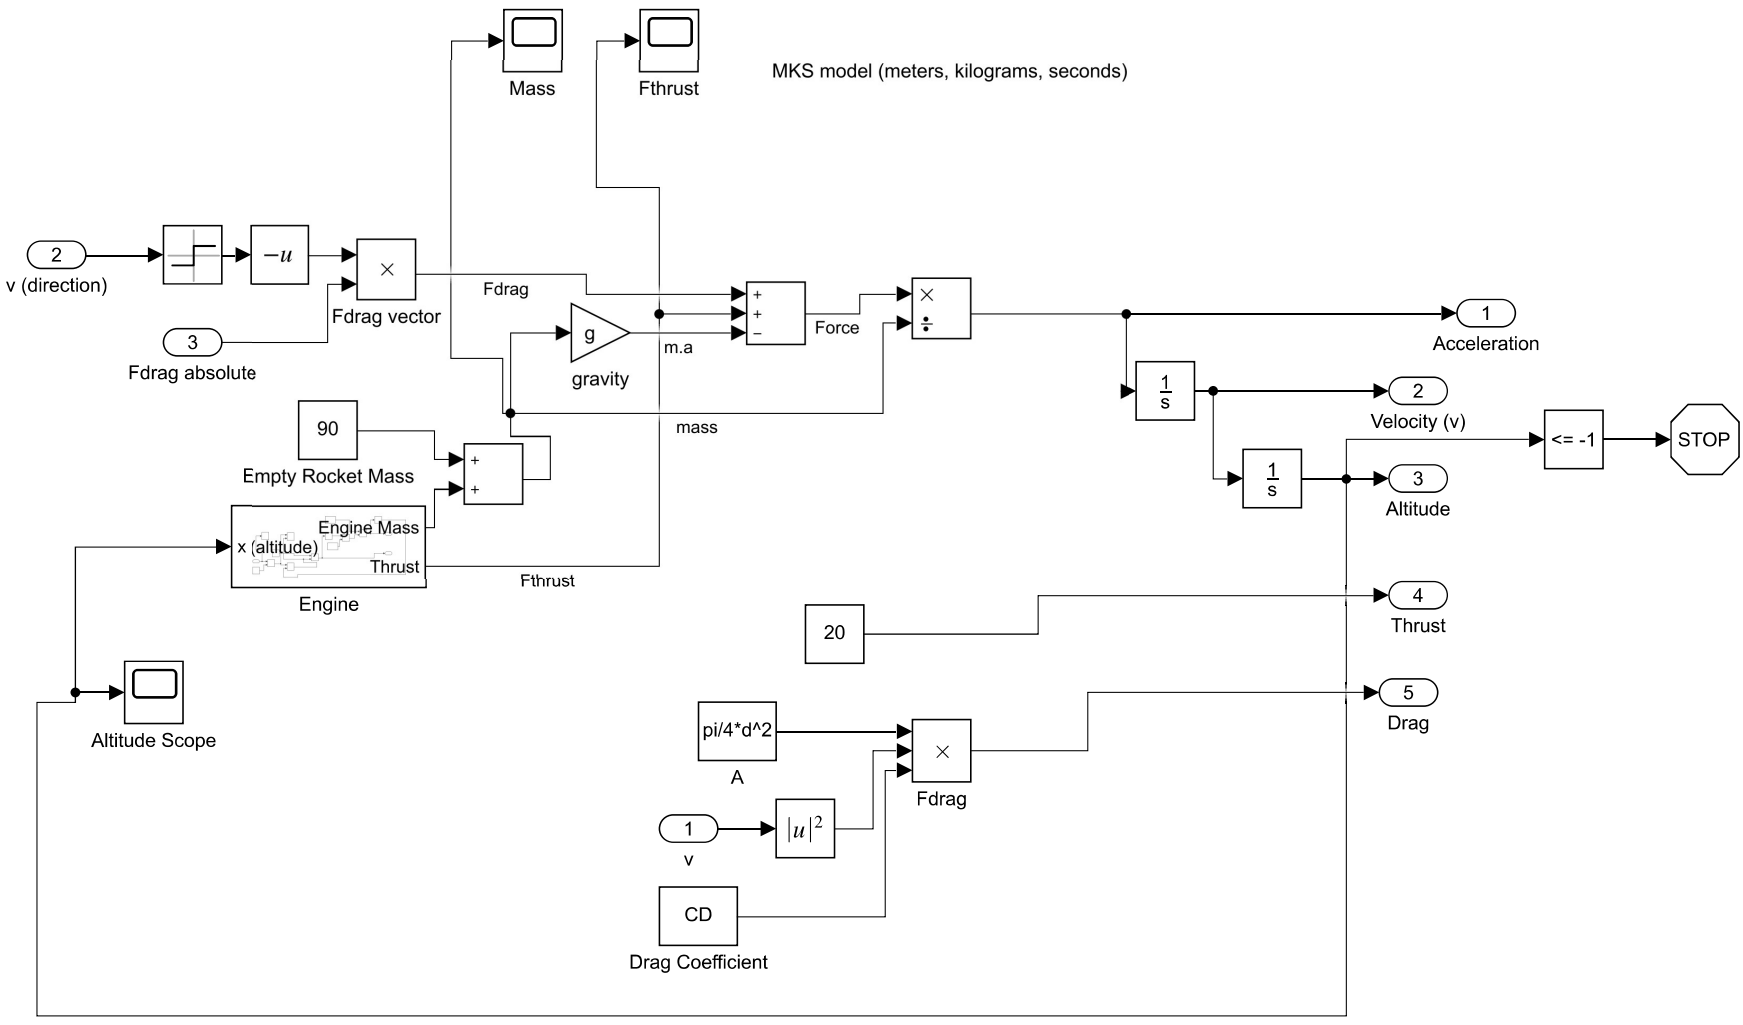
[picture p62: page 1]
