soypat/proy-final/pdf/engineSystem.pdf

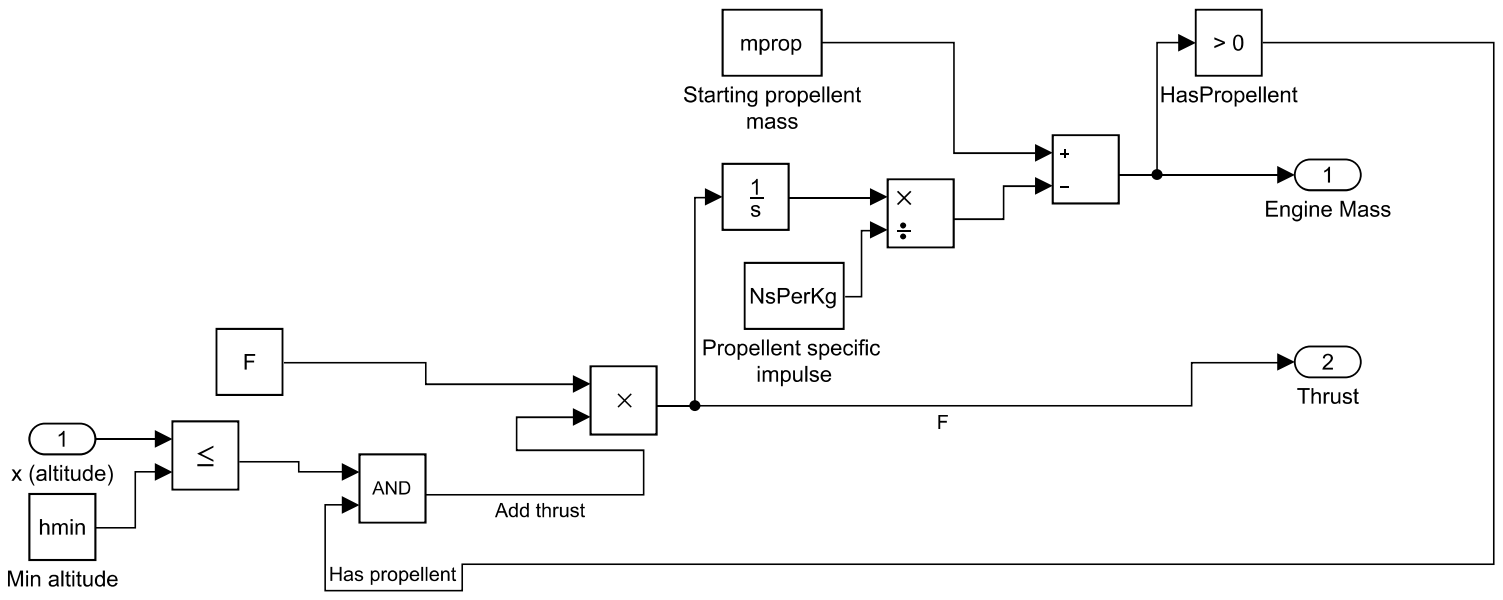
[picture p63: page 1]
