soypat/proy-final/pdf/cad/ALUM-06-03.pdf

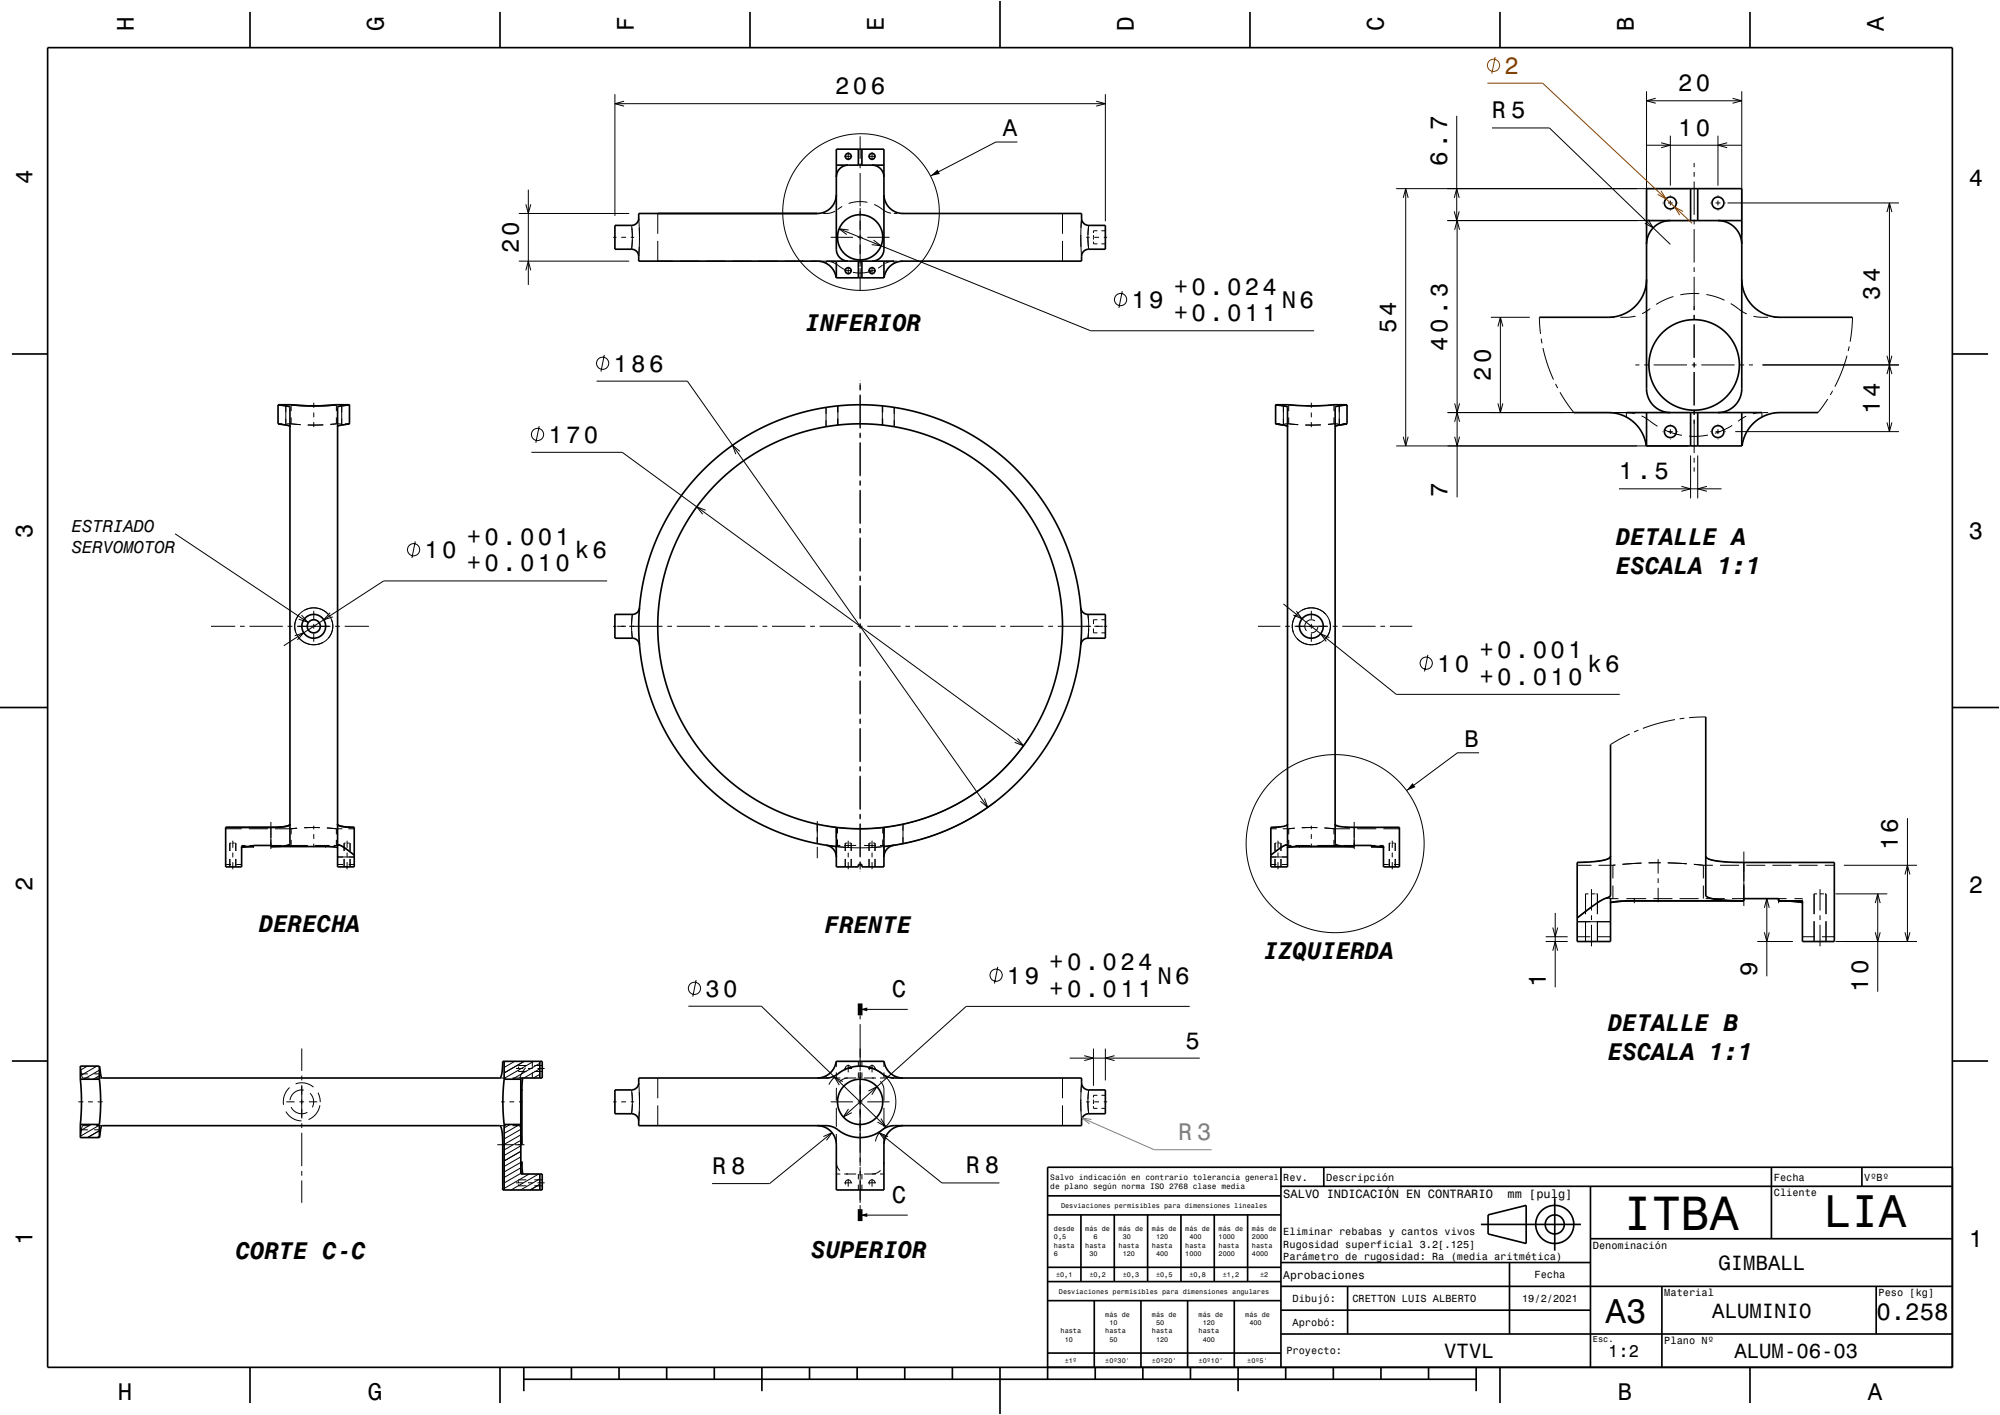
[picture p64: page 1]
más de; DETALLE A ESCALA 1:1; DETALLE B ESCALA 1:1; CORTE C-C

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

SALVO INDICACIÓN EN CONTRARIO mm [pulg] Parámetro de rugosidad: Ra (media aritmética) | | | ITBA | Cliente LIA

Desviaciones permisibles para dimensiones lineales

más de
Eliminar rebabas y cantos vivos
Rugosidad superficial 3.2[.125]

±0,1 | ±0,2 | ±0,3 | ±0,5 | ±0,8 | ±1,2 | ±2
Desviaciones permisibles para dimensiones angulares | Dibujó: | CRETTON LUIS ALBERTO | 19/2/2021 | A3 | Material ALUMINIO | Peso [kg] 0.258

Aprobaciones | Fecha

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

Aprobó:
VTVL Proyecto: | Esc. 1:2 | Plano Nº ALUM-06-03
