soypat/proy-final/cae/powerboard/powerboard.kicad_sch

## KiCad design cae/powerboard/powerboard.kicad_sch (2023-03-06)

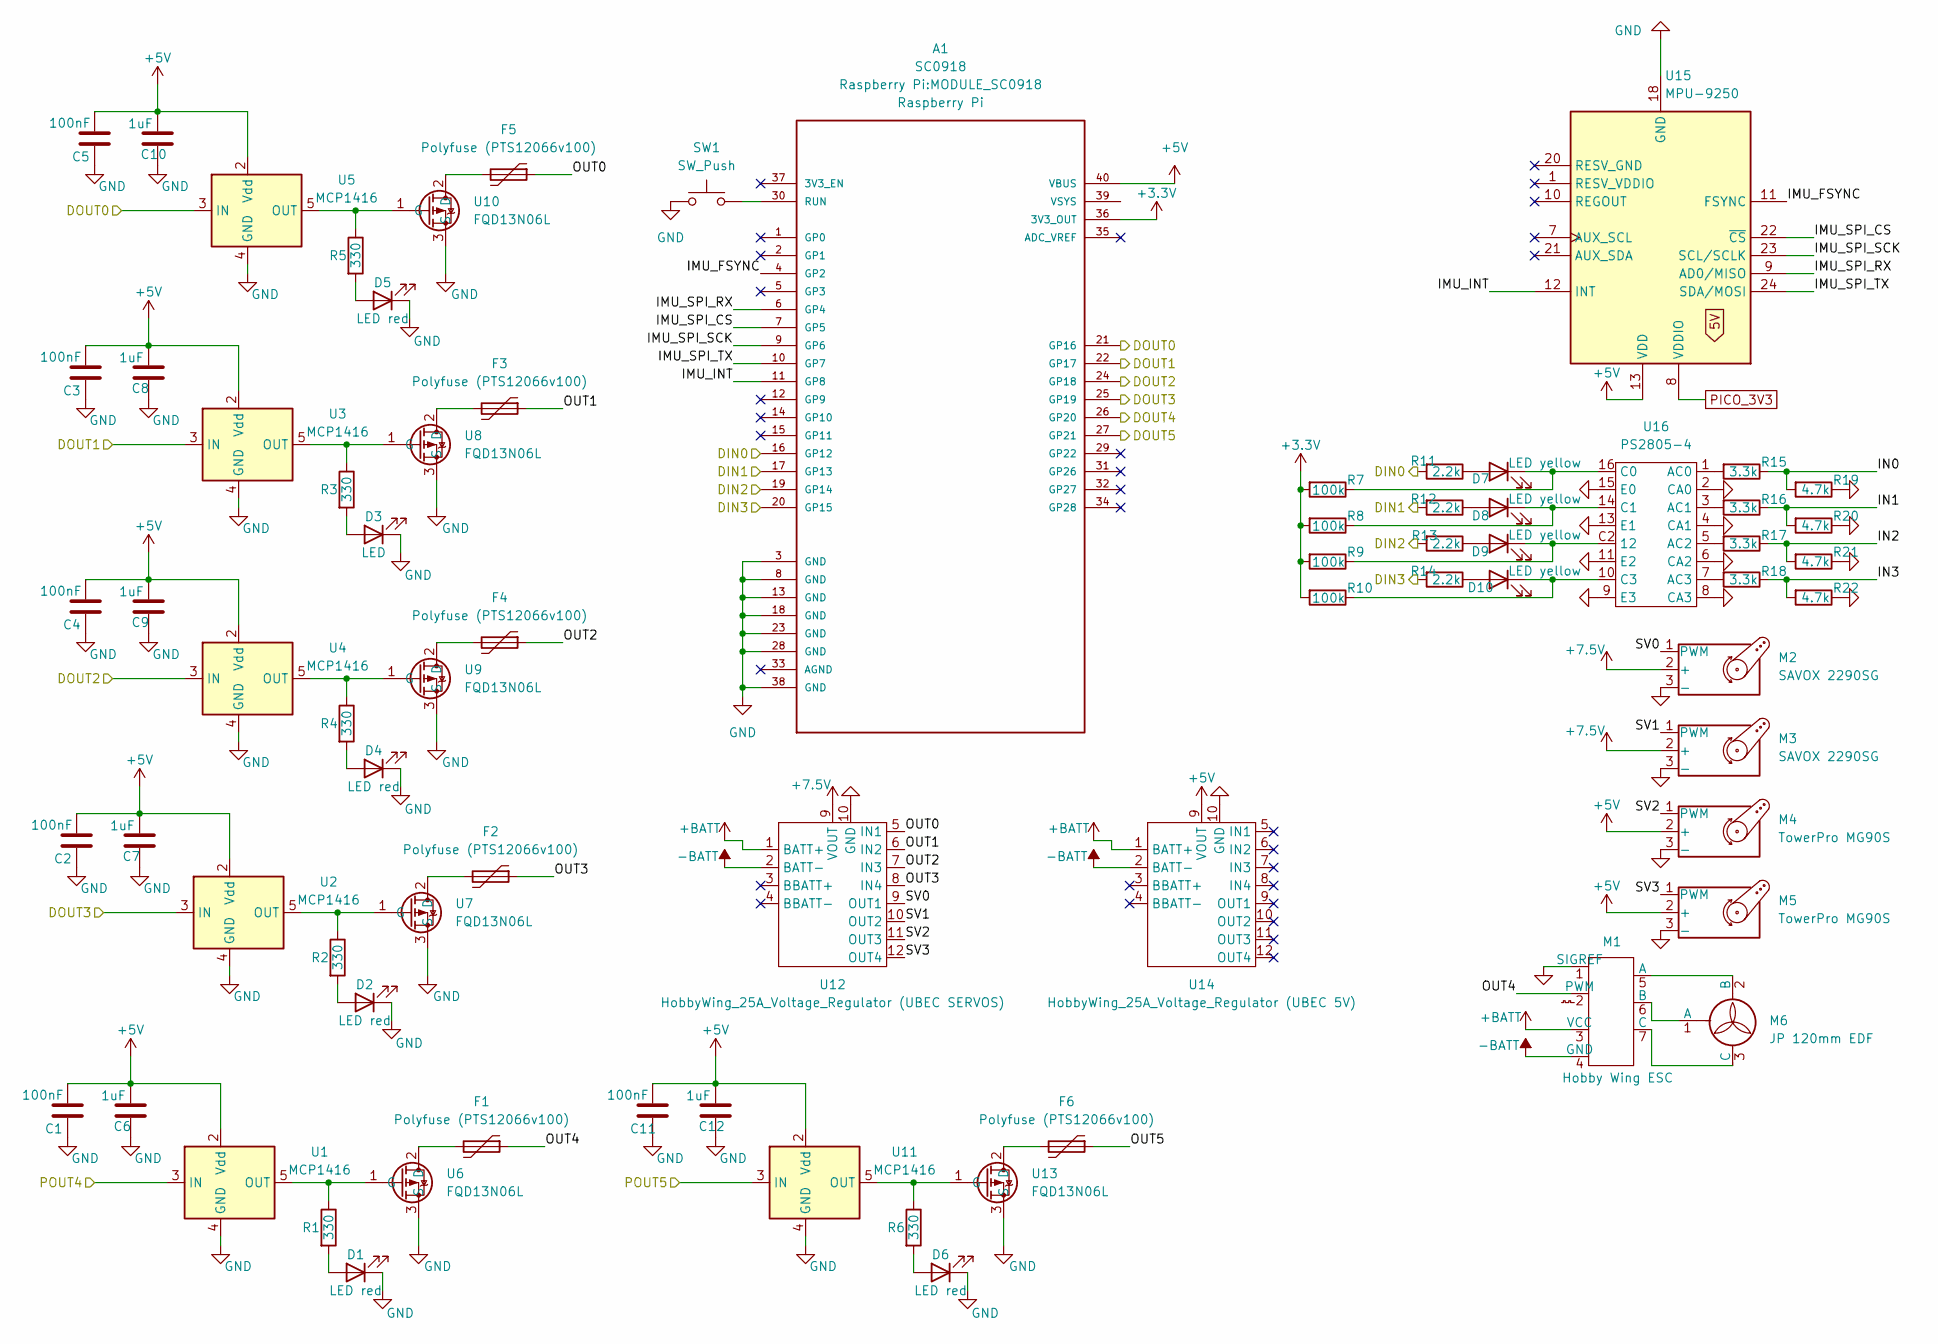
[picture p65: schematic powerboard.kicad_sch]

Parts:
A1: SC0918; MODULE_SC0918; PARTREV 1.6
C1, C2, C3, C4, C5, C11: 100nF
C6, C7, C8, C9, C10, C12: 1uF
D1, D2, D4, D5, D6: LED red
D3: LED
D7, D8, D9, D10: LED yellow
F1, F2, F3, F4, F5, F6: Polyfuse (PTS12066v100)
M1: Hobby Wing ESC
M2, M3: SAVOX 2290SG
M4, M5: TowerPro MG90S
M6: JP 120mm EDF
R1, R2, R3, R5, R6: 330; R_0201_0603Metric
R4: 330
R7, R8, R9, R10: 100k
R11, R12, R13, R14: 2.2k
R15, R16, R17, R18: 3.3k
R19, R20, R21, R22: 4.7k
SW1: SW_Push
U1, U2, U3, U4, U5, U11: MCP1416; SOT-23-5
U6, U7, U8, U9, U10, U13: FQD13N06L; SOT-223
U12: HobbyWing_25A_Voltage_Regulator (UBEC SERVOS)
U14: HobbyWing_25A_Voltage_Regulator (UBEC 5V)
U15: MPU-9250; InvenSense_QFN-24_3x3mm_P0.4mm
U16: PS2805-4

Connections:
+3.3V: A1.36 (3V3_OUT), R7.2, R8.2, R9.2, R10.2
+5V: A1.40 (VBUS), C1.1, C2.1, C3.1, C4.1, C5.1, C6.1, C7.1, C8.1, C9.1, C10.1, C11.1, C12.1, M4.2 (+), M5.2 (+), U1.2 (Vdd), U2.2 (Vdd), U3.2 (Vdd), U4.2 (Vdd), U5.2 (Vdd), U11.2 (Vdd), U14.9 (OUT1), U15.13 (VDD)
+7.5V: M2.2 (+), M3.2 (+), U12.9 (OUT1)
+BATT: M1.3 (VCC), U12.1 (BATT+), U14.1 (BATT+)
-BATT: M1.4 (GND), U12.2 (BATT-), U14.2 (BATT-)
DIN0: A1.16 (GP12), R11.2
DIN1: A1.17 (GP13), R12.2
DIN2: A1.19 (GP14), R13.2
DIN3: A1.20 (GP15), R14.2
DOUT0: A1.21 (GP16), U5.3 (IN)
DOUT1: A1.22 (GP17), U3.3 (IN)
DOUT2: A1.24 (GP18), U4.3 (IN)
DOUT3: A1.25 (GP19), U2.3 (IN)
DOUT4: A1.26 (GP20)
DOUT5: A1.27 (GP21)
GND: A1.3 (GND), A1.8 (GND), A1.13 (GND), A1.18 (GND), A1.23 (GND), A1.28 (GND), A1.38 (GND), C1.2, C2.2, C3.2, C4.2, C5.2, C6.2, C7.2, C8.2, C9.2, C10.2, C11.2, C12.2, D1.1 (K), D2.1 (K), D3.1 (K), D4.1 (K), D5.1 (K), D6.1 (K), M1.1 (SIGREF), M2.3 (-), M3.3 (-), M4.3 (-), M5.3 (-), R19.1, R20.1, R21.1, R22.1, SW1.1, U1.4 (GND), U2.4 (GND), U3.4 (GND), U4.4 (GND), U5.4 (GND), U6.3 (S), U7.3 (S), U8.3 (S), U9.3 (S), U10.3 (S), U11.4 (GND), U12.10 (GND), U13.3 (S), U14.10 (GND), U15.18 (GND), U16.2 (CA0), U16.4 (CA1), U16.6 (CA2), U16.8 (CA3), U16.9 (E3), U16.11 (E2), U16.13 (E1), U16.15 (E0)
IMU_FSYNC: A1.4 (GP2), U15.11 (FSYNC)
IMU_INT: A1.11 (GP8), U15.12 (INT)
IMU_SPI_CS: A1.7 (GP5), U15.22 (~CS)
IMU_SPI_RX: A1.6 (GP4), U15.9 (AD0/MISO)
IMU_SPI_SCK: A1.9 (GP6), U15.23 (SCL/SCLK)
IMU_SPI_TX: A1.10 (GP7), U15.24 (SDA/MOSI)
IN0: R15.1, R19.2
IN1: R16.1, R20.2
IN2: R17.1, R21.2
IN3: R18.1, R22.2
unnamed: A1.30 (RUN), SW1.2
unnamed: D1.2 (A), R1.2
unnamed: D2.2 (A), R2.2
unnamed: D3.2 (A), R3.2
unnamed: D4.2 (A), R4.2
unnamed: D5.2 (A), R5.2
unnamed: D6.2 (A), R6.2
unnamed: D7.1 (K), R7.1, U16.16 (C0)
unnamed: D7.2 (A), R11.1
unnamed: D8.1 (K), R8.1, U16.14 (C1)
unnamed: D8.2 (A), R12.1
unnamed: D9.1 (K), R9.1, U16.C2 (12)
unnamed: D9.2 (A), R13.1
unnamed: D10.1 (K), R10.1, U16.10 (C3)
unnamed: D10.2 (A), R14.1
unnamed: F1.2, U6.2 (D)
unnamed: F2.2, U7.2 (D)
unnamed: F3.2, U8.2 (D)
unnamed: F4.2, U9.2 (D)
unnamed: F5.2, U10.2 (D)
unnamed: F6.2, U13.2 (D)
unnamed: M1.5 (A), M6.2 (B)
unnamed: M1.6 (B), M6.1 (A)
unnamed: M1.7 (C), M6.3 (C)
unnamed: R1.1, U1.5 (OUT), U6.1 (G)
unnamed: R2.1, U2.5 (OUT), U7.1 (G)
unnamed: R3.1, U3.5 (OUT), U8.1 (G)
unnamed: R4.1, U4.5 (OUT), U9.1 (G)
unnamed: R5.1, U5.5 (OUT), U10.1 (G)
unnamed: R6.1, U11.5 (OUT), U13.1 (G)
unnamed: R15.2, U16.1 (AC0)
unnamed: R16.2, U16.3 (AC1)
unnamed: R17.2, U16.5 (AC2)
unnamed: R18.2, U16.7 (AC3)
OUT0: F5.1, U12.5 (IN1)
OUT1: F3.1, U12.6 (IN2)
OUT2: F4.1, U12.7 (IN3)
OUT3: F2.1, U12.8 (IN4)
OUT4: F1.1, M1.2 (PWM)
OUT5: F6.1
PICO_3V3: U15.8 (VDDIO)
POUT4: U1.3 (IN)
POUT5: U11.3 (IN)
SV0: M2.1 (PWM), U12.9 (OUT1)
SV1: M3.1 (PWM), U12.10 (GND)
SV2: M4.1 (PWM), U12.11 (OUT3)
SV3: M5.1 (PWM), U12.12 (OUT4)
