soypat/proy-final/(commit log)

2023-02-18 finalize first entrega
    [powerboard.kicad_pcb, powerboard.kicad_sch]
2023-03-06 begin editing first pictures
    [powerboard.kicad_pcb, powerboard.kicad_sch]
2023-06-14 k pasa, no t gusta edu cuando hablo de software
2023-06-15 cerrado la parte estructuras
